argeuthiesen/claudinho/virtual/modelo/base.stl

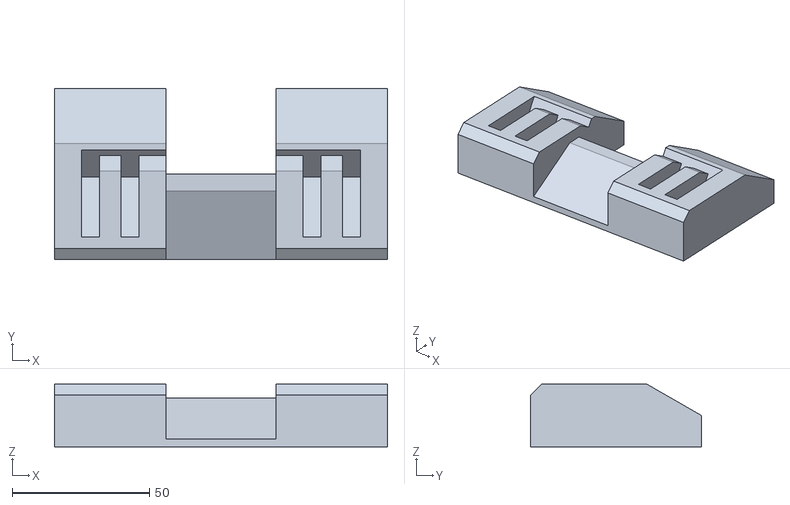
[picture p14: CAD file, 2026-10-12]
virtual/modelo/base.stl
121.5 x 62.4 x 23.0
