argeuthiesen/claudinho/docs/manual.md

# Claudinho manual

**English** · [Português](manual.pt-BR.md)

How to use Claudinho day to day, once it's built and set up. To build and
install it, see the [README](../README.md).

## What the face shows

Claudinho reacts on its own to what Claude Code is doing:

| Face | When it shows |
|---|---|
| Happy | a session started |
| Thinking | you sent a prompt |
| Excited | prompt with "thanks", "it works", "perfect", "awesome"... |
| Worried | prompt with "error", "bug", "doesn't work", "failed"... |
| Startled | prompt with a swear word |
| Working | Claude is about to use a tool (or one of the scenes below) |
| Suspicious | 5 tool calls in a row |
| Angry | a tool call failed |
| Excited | a `git commit` went through (it celebrates) |
| Happy | tests passed (`pytest`, `npm test`, `cargo test`, `go test`...) |
| Worried | tests failed |
| Waiting for you | Claude needs your permission or an answer |
| Dizzy | compacting the context |
| Done | Claude just finished responding |
| Tired | idle, with 5-hour usage above 75% |
| Sweating | idle, with usage above 90% |
| Sleeping | no open session, or 3 minutes without news from the computer |

Mood words are matched in English and Portuguese, and your prompt text never
leaves your computer: only the label ("happy", "worried", "startled") goes to
the board. The same goes for commits and tests: the command is checked on
your computer, and only the word ("commit", "tests passed", "tests failed")
goes to the board.

Along with the face, a short **caption** shows at the bottom for a few
seconds ("Thinking...", "Committed!", "I need you!") and then disappears,
leaving the face clean.

## Scenes while Claude works

While Claude uses tools, instead of the working face Claudinho plays a little
scene, with a mini Claudinho (arms, legs and all) in the corner:

| Claude is... | Scene |
|---|---|
| editing a file | a code editor: a terminal types `code` and a file name, then colored code is typed line by line and scrolls (a different file each time: Python, TypeScript, Go, SQL, C++) |
| running a command | a terminal typing commands, with output scrolling: git, tests that fail and then pass, builds, docker… in a different order each time |
| reading or searching the code | the Matrix rain |
| delegating to a subagent | an org chart: Claude on top, agents appearing below |
| asking another AI for a second opinion: OpenAI's [Codex plugin](https://github.com/openai/codex-plugin-cc) (GPT), `codex exec` or the Gemini CLI (`gemini -p`) | a chat: Claudinho and a little cloud with arms taking turns in speech bubbles full of zeros and ones |

It's all make-believe, stored on the board: the code and commands on screen are
fake. Only the category (editing, terminal, reading, agent, chat) leaves your
computer; file names and commands never do. Each scene stays at least 8
seconds, so the screen doesn't flicker; 12 seconds with no tool, it goes back
to the face (the chat waits for the next event, up to 5 minutes, since the
other AI often takes a while in a single command). Any other event (done, needs you, error) goes straight to the
face. Tap to see the usage card. To try one: `claudinho.sh cena codando`
(`terminal`, `lendo`, `agente`, `conversa`).

**The ticker.** Under the scene, a band in the face color shows what Claude is
doing in plain words: the short description Claude writes for each command
and agent (the one you see when approving it) or, without one, the task in
progress from its to-do list. It types itself out and, when it doesn't fit,
scrolls side to side. The command and file names still never leave your
computer. Off: `claudinho.sh letreiro desliga` (`liga` turns it back on). To
try it: `claudinho.sh cena terminal "Compiling the firmware"`. Claude tends to
write these descriptions in English; to get them in another language, ask for
it in your `CLAUDE.md`. On the single board the ticker uses DM Sans SemiBold;
on the Nextion version, the bold font the screen already has.

## Plan usage

- **Tap the screen** to see the usage card: 5-hour and 7-day windows, when
  each one resets, how many terminals are open and the board's IP, plus how
  full the current conversation's **context** is. On the single board they
  are **three rings** side by side (5 hours, 7 days, context) with the number
  in the middle; on the classic version, two bars plus **ctx** at the top.
  Colors: 5 h and 7 d turn yellow from 75% and red from 90%; context turns
  yellow from 70% and red from 85%, because Claude Code compacts the
  conversation a bit before it's full. After 15 seconds it goes back to the
  face (or tap outside the buttons).
- **The buttons at the bottom** (on the usage card and on the printer
  panel):
  - **Tokens** and **Printer** switch between the two screens;
    a thin gold frame marks the one you're on. Without a printer set up,
    only Tokens shows.
  - **Keep**: the screen stays on, updating live, and never goes
    back to the sleeping face. The button then reads **Sleep**:
    tap it and Claudinho goes back to sleep. Handy to take it to another
    room as a portable printer monitor. Printer alerts still show up, and
    after your tap it returns to the kept screen.
- **It also shows it on its own** for a few seconds when Claude finishes a
  response and usage grew noticeably, or when usage crosses 50%, 75% or 90%.
  Above 90% the number blinks red. Any new event goes straight back to the
  face.
- The numbers only show up after Claude's first response in a session.

## Web panel

`claudinho.sh web` (or ask Claude "open Claudinho's panel") opens, in your
browser, a page served by the board itself: the face it's showing, open
sessions, Wi-Fi signal, uptime, free memory, battery (single board), the
printer (if connected), plan usage and the last 20 events with the face each
one caused. It refreshes every 3 seconds.

Below, **Settings**: sound on/muted, volume, test a mood, face color (pick
it on the page and apply or save, or open the palette on the screen),
screen language, show usage or the printer panel now, open a game, run the
demo, restart and turn off. Updating the firmware, Wi-Fi and the printer
stay with `claudinho.sh` (they need the secret). The panel's address has a
read key that stays on your computer. Idea from
[bserking's fork](https://github.com/bserking/claudinho_GC9A01).

## Touch

| Touch | What it does |
|---|---|
| Short tap | on the face: opens the usage card; on the cards: the buttons (outside them, back to the face) |
| Long press (1.5 s) | toggles brightness between 100% and 15% |
| Tap when it asks to allow an update | authorizes the update |

When sleeping, it dims itself after 20 seconds.

## Changing the face color

Handy for matching the face to your case's filament color.

1. Ask Claude "change Claudinho's color" (or run `claudinho.sh cor`).
2. The screen shows **6 base colors**. Tap the one closest to your filament.
3. **12 shades of it** appear around the edges, with the tapped shade **shown
   large in the middle**. With the screen mounted in the case, the edge shades
   sit right against the printed frame, so you can compare each one directly
   with the filament, side by side. (Outside the case, hold a piece of
   filament next to the middle.)
4. Found it? **Tap the middle.** You get the face in that color with three
   buttons:
   - **Save**: keeps the color, even after a restart;
   - **Back**: back to the 12 shades;
   - **Cancel**: back to the previous color.

If nobody touches it for 1 minute, it cancels on its own. The eyes always
stay black. If you know the exact color: `claudinho.sh cor R G B salvar`.

## Tic-tac-toe

Just for fun: ask Claude "let's play tic-tac-toe" (or run `claudinho.sh
velha`). Your opponent is Claudinho itself, running on the board, spending no
tokens, and each game it's in a different mood: sometimes it plays perfectly,
sometimes it slips.

- You are **X**: tap a square. It answers right after with a **mini Clawd**.
- At the end it strikes the winning line and reacts: **sad** if you won,
  **excited** if it won, **suspicious** on a draw. Then a new game starts on
  its own, and who goes first alternates.
- To quit: **3 quick taps on the same square**, or 2 minutes without touching.
- If Claude Code needs you mid-game, a notice shows up in the corner.

## Genius (Simon)

Ask Claude "let's play Genius" (or run `claudinho.sh genius`). It also runs on
the board, spending no tokens.

- Claudinho lights up a sequence of colors on the 4 quadrants; you repeat it
  by tapping in the same order. The number in the middle is the round.
- Every time you get it right, the sequence gets one more color and speeds up
  a little.
- Miss one: it shows your score with a face that depends on how far you got,
  and a new game starts on its own.
- To quit: **3 quick taps on the same quadrant** (correct taps in the sequence
  don't count, so play without worry), or 2 minutes without touching.

## Bambu Lab printer (optional)

If you have a Bambu Lab 3D printer, Claudinho can watch it too. It connects
straight to the printer over your local network: no cloud, no server, no
tokens. **Tested on the P2S** (with AMS); other Bambu models with local access
(X1, P1, A1) should work but haven't been tested yet.

To turn it on, ask Claude "I have a Bambu printer" (or run `claudinho.sh bambu
PRINTER_IP`). You'll need the printer's IP and **access code** (printer
settings > Network). The access code is a secret like your Wi-Fi password: you
type it hidden, in your own terminal, and it's stored only on the board.

**The panel.** The printer model and its state (printing, paused...), the
AMS humidity and temperature (measured inside the AMS, where the spools are),
three columns (percent printed, time left, current layer), a progress bar in
the color of the filament being printed, nozzle, bed and chamber temperatures, and the
4 AMS colors with the current one framed. (The name you gave the printer in
the app lives only in Bambu's cloud, so the panel shows the model. The print
job name isn't shown either: over the local network the printer only sends
Bambu Studio's "project + plate" or the MakerWorld profile name, which don't
say what the part is.) While printing, it shows up on its own every 5 minutes
for 15 seconds. Open it anytime with the **Printer** button on the usage
card, and use **Keep** to keep it on screen.

**The alerts** show "3D PRINTER" and the model at the top, a
big title in the alert's color, the part name, the detail, and a little
Claudinho at the bottom: jumping for good news, waving its arms when something
needs you. The ones that only tell you how the print is going (started,
resumed, 5 minutes left, filament change) close by themselves after 20
seconds; the others stay on screen **until you tap** (the tap means "got it").
If several pile up, they show one after the other, and a newer alert from the
same print drops the ones it made old: "finished" replaces a "started" nobody
saw, and a pause that was resumed or ended goes away too. **When the printer
goes back to printing, Claudinho takes it that you already fixed the problem**:
the pause, the printer warnings and the end of the previous print leave the
queue without waiting for a tap.

| Alert | When |
|---|---|
| Started | a print started, with the estimated time |
| Paused | with the reason: out of filament, you paused, clogged nozzle, first layer error, front cover, temperature... |
| Resumed | back to printing after a pause |
| 5 min left | 5 minutes left |
| Filament changed | filament change, with the new color (one alert, kept up to date) |
| Finished! | with how long it took |
| Failed / Cancelled | failed (with the error code) or cancelled |
| HMS warnings | the printer's health warnings, in plain words (see below) |
| AMS is humid | AMS humidity reached 50% |

**HMS warnings, in plain words.** Bambu printers report problems as HMS codes
(like `0500-0200-0002-0005`). Claudinho carries Bambu's whole list (about 2,000
codes), rewritten as short phrases in your language: the title is the area (AMS,
nozzle / extruder, heated bed, network / internet...), the detail says what
happened, and the code stays small at the bottom, to look up in Bambu's wiki.
The color follows how serious it is: blue is informative, yellow needs
attention, red is serious.

**Tap or 20 seconds.** Informative warnings (no internet, clock sync, live
view, filter life...) **leave on their own after 20 seconds** and don't repeat
for 30 minutes: when the internet drops and comes back, it won't pop up every
time. A warning that shows up while the printer keeps printing also closes by
itself (it didn't stop anything), and one the printer clears from its list
leaves the queue too. Codes Bambu doesn't describe, at the "notice" level (no
effect on the print), only go to the log. Everything else waits for your tap,
or for the printer to start printing again.

During a game, the color palette or an update, the alerts wait until you're
back on the face. To see what they look like: `claudinho.sh alerta bom` (good
news), `ruim` (a pause), `filamento` or `hms`. To turn it off: `claudinho.sh bambu desligar` (erases the
code from the board).

## Sound and battery (single-board version only)

On the E32R28T with a small speaker, Claudinho **speaks a robot language** of
beeps and whistles, made up on the spot: no phrase is recorded, so no two are
alike, and the mood changes the intonation. It speaks when it wakes up, when
you open a Claude Code session (hello) and close the last one (goodbye), when
Claude needs you (a question), on an error (grumpy), when Claude finishes (a
quick "done!") and when it goes to sleep, and it calls out every 15 seconds
while the update screen waits for your tap. It stays quiet right after being
turned on.

- `claudinho.sh som desliga` / `som liga`: silence it or bring it back.
- `claudinho.sh som volume 150`: volume from 10 to 200% (above 100 it may
  distort a little).
- `claudinho.sh som feliz` (or `pergunta`, `sono`, `bravo`, `pronto`,
  `pensando`, `zonzo`...): hear a phrase in that mood.

**Battery:** the usage card shows a battery icon next to the clock, with a
**lightning bolt** inside while it charges. The charger's status pin doesn't
reach the ESP32, so the board figures it out from the voltage: plugging in
the 5 V makes it jump about 100 mV at once, and unplugging drops it the same
amount. The bolt shows up a few seconds after plugging in; if the board was
turned on already plugged in, it takes about 10 minutes (a slow rise). To put it
away for a few days, `claudinho.sh desligar` turns off the screen and puts the
board to deep sleep, using almost nothing; press **BOOT** (or RESET) to turn it
back on.

## Virtual Claudinho (no board)

No board yet? `claudinho.sh virtual` (or ask Claude "turn on the virtual
Claudinho") starts a small local server that takes the board's place and
opens Claudinho in a browser tab: the 3D case with the face running, or just
the screen ("Screen only" button), with the plan usage beside it. Drag to
turn it around, scroll to zoom. It reacts to the same events as the board,
spends no tokens and listens on `127.0.0.1` only.

- Click the screen (or the "Show usage" button) to see the three usage rings,
  like a tap on the board. It also opens on its own when usage crosses 50, 75
  or 90 %, and goes back to the face after 10 s.
- After restarting the computer, run it again.
- `claudinho.sh virtual parar` turns it off and points the plugin back to
  the board, if there was one.
- Not there yet: the Bambu Lab printer (panel and alerts) and the games.
  Only the board connects to a real printer for now; the online demo shows
  the printer screens with made-up data.
- Just want to look? The [online demo](https://argeuthiesen.github.io/claudinho/)
  runs on made-up events, nothing to install.

## Demo mode

Want to film Claudinho or show it to someone? Run `claudinho.sh demo` (or ask
Claude "run Claudinho's demo"). In about 2 minutes it goes through
everything on its own: sleeping and waking up, the faces, plan usage, the
work scenes, the printer panel and alerts, the color calibration, a game of
tic-tac-toe and one of Simon with "ghost" taps, and back to sleep.

It's all make-believe: your real numbers, the printer, the face color and
any pending alerts come back exactly as they were. During the demo, events
from the computer and the printer are ignored, so nothing interrupts it.
**Tap the screen to stop it** (or `claudinho.sh demo parar`). It uses the
screen language you picked. The printer part only shows if a printer is set
up.

## Updating

Ask Claude "update Claudinho". The screen will ask to allow the update: **tap
it within 1 minute** (or press the board's BOOT button). Without the tap,
nothing is sent. That keeps anyone from swapping the firmware over the network
without being in front of it.

The update takes about 40 seconds and it restarts on its own. If the network
drops halfway, it keeps the current version; just ask again.

## Asking Claude

No need to memorize commands. Inside Claude Code, just ask:

- "update Claudinho"
- "change Claudinho's color"
- "show the usage on Claudinho"
- "Claudinho stopped reacting" (the skill runs a diagnosis)
- "I changed my Wi-Fi, reconfigure Claudinho"
- "change Claudinho's language" (screen texts in English or Portuguese, and
  [your language, if you translate it](../idiomas/TRANSLATING.md))
- "I have a Bambu printer" / "show the printer panel"

The full command list is in the [README](../README.md#commands), and the most
common problems in [Troubleshooting](../README.md#troubleshooting).
