argeuthiesen/claudinho/docs/manual.pt-BR.md

# Manual do Claudinho

[English](manual.md) · **Português**

Como usar o Claudinho no dia a dia, depois de montado e configurado. Para
montar e instalar, veja o [README](../README.pt-BR.md).

## O que o rosto mostra

O Claudinho reage sozinho ao que o Claude Code está fazendo:

| Cara | Quando aparece |
|---|---|
| Feliz | abriu uma sessão |
| Pensando | você mandou um prompt |
| Empolgado | prompt com "obrigado", "valeu", "funcionou", "perfeito"... |
| Preocupado | prompt com "erro", "bug", "não funciona", "travou"... |
| Susto | prompt com palavrão |
| Trabalhando | o Claude vai usar uma ferramenta (ou uma das cenas abaixo) |
| Desconfiado | 5 ferramentas seguidas |
| Bravo | uma ferramenta falhou |
| Empolgado | um `git commit` deu certo (ele comemora) |
| Feliz | os testes passaram (`pytest`, `npm test`, `cargo test`, `go test`...) |
| Preocupado | os testes falharam |
| Esperando você | o Claude precisa da sua permissão ou de uma resposta |
| Zonzo | compactando o contexto |
| Terminou | o Claude acabou de responder |
| Cansado | parado, com o uso da janela de 5 horas acima de 75 % |
| Suando | parado, com o uso acima de 90 % |
| Dormindo | nenhuma sessão aberta, ou 3 minutos sem notícia do computador |

As palavras do humor são procuradas em português e em inglês, e o texto do
prompt nunca sai do seu computador: só a etiqueta ("feliz", "preocupado",
"susto") vai para a placa. O mesmo vale para commit e testes: o comando é
conferido no seu computador, e só a palavra ("commit", "testes passaram",
"testes falharam") vai para a placa.

Junto com a cara, aparece uma **legenda** curta embaixo por uns segundos
("Pensando...", "Commit feito!", "Preciso de você!"), que depois some e
deixa o rosto limpo.

## Cenas enquanto o Claude trabalha

Enquanto o Claude usa ferramentas, no lugar da cara de trabalhando o
Claudinho mostra uma cena, com um Claudinho pequeno (com bracinhos e
perninhas) no canto:

| O Claude está... | Cena |
|---|---|
| editando um arquivo | um editor de código: um terminal digita `code` e o nome de um arquivo, e o código colorido vai sendo digitado e rolando (cada vez um arquivo: Python, TypeScript, Go, SQL, C++) |
| rodando um comando | um terminal digitando comandos, com a saída rolando: git, testes que falham e depois passam, builds, docker… cada vez numa ordem |
| lendo ou procurando no código | a chuva do Matrix |
| delegando para um subagente | um organograma: o Claude em cima, os agentes surgindo embaixo |
| pedindo uma segunda opinião a outra IA: o [plugin do Codex](https://github.com/openai/codex-plugin-cc) da OpenAI (GPT), o `codex exec` ou o Gemini CLI (`gemini -p`) | uma conversa: o Claudinho e uma nuvenzinha de bracinhos se revezando em balões cheios de zeros e uns |

É tudo de mentira, guardado na placa: o código e os comandos da tela são
inventados. Do seu computador sai só a categoria (editando, terminal, lendo,
agente, conversa); nome de arquivo e comando nunca saem. Cada cena fica pelo menos 8
segundos, para a tela não piscar; 12 segundos sem ferramenta, volta ao rosto
(a conversa espera o próximo evento, até 5 minutos, porque a outra IA costuma
demorar num comando só).
Qualquer outro evento (terminou, precisa de você, erro) volta ao rosto na
hora. Tocar mostra o cartão de consumo. Para ver uma: `claudinho.sh cena
codando` (`terminal`, `lendo`, `agente`, `conversa`).

**O letreiro.** Embaixo da cena, uma faixa na cor do rosto mostra o que o
Claude está fazendo, em palavras: o resumo que o Claude escreve para cada
comando e agente (o que você vê ao aprovar) ou, sem ele, a tarefa em andamento
da lista dele. Ele se digita sozinho e, quando não cabe, rola de um lado para
o outro. O comando e os nomes de arquivo continuam sem sair do computador.
Desligar: `claudinho.sh letreiro desliga` (`liga` volta). Para ver:
`claudinho.sh cena terminal "Compilando o firmware"`. O Claude costuma
escrever esses resumos em inglês; para tê-los em português, peça isso no seu
`CLAUDE.md`. Na placa única o letreiro usa a DM Sans SemiBold; na versão com
Nextion, a negrito que a tela já tem.

## O consumo do plano

- **Tocando na tela** aparece o cartão de consumo: janelas de 5 horas e de 7
  dias, quando cada uma renova, quantos terminais estão abertos e o IP da
  placa, e quanto do **contexto** da conversa atual já foi usado. Na placa
  única são **três anéis** lado a lado (5 horas, 7 dias e contexto), com o
  número no meio; na versão clássica, duas barras e o **ctx** no alto. Cores:
  5 h e 7 d ficam amarelos a partir de 75 % e vermelhos a partir de 90 %; o
  contexto fica amarelo a partir de 70 % e vermelho a partir de 85 %, porque o
  Claude Code compacta a conversa um pouco antes de encher. Depois de 15
  segundos ele volta ao rosto (ou toque fora dos botões).
- **Os botões de baixo** (no cartão de consumo e no painel da impressora):
  - **Tokens** e **Impressora** alternam entre as duas telas; uma moldura
    dourada fina marca a atual. Sem impressora configurada, só aparece
    Tokens.
  - **Manter**: a tela fica ligada, atualizando ao vivo, e não volta mais
    para o rosto dormindo. O botão passa a dizer **Dormir**: tocando nele,
    o Claudinho volta a dormir. Bom para levar para outro cômodo como
    monitor portátil da impressora. Os alertas da impressora continuam
    aparecendo e, depois do seu toque, ele volta para a tela mantida.
- **Ele também mostra sozinho**, por alguns segundos, quando o Claude termina
  de responder e o uso subiu bastante, ou quando o uso passa de 50 %, 75 % ou
  90 %. Acima de 90 % o número pisca em vermelho. Qualquer evento novo volta
  ao rosto na hora.
- Os números só aparecem depois da primeira resposta do Claude numa sessão.

## Painel web

O `claudinho.sh web` (ou peça ao Claude "abre o painel do Claudinho") abre,
no navegador, uma página servida pela própria placa: a cara que está na
tela, as sessões abertas, o sinal do Wi-Fi, há quanto tempo está ligado, a
memória livre, a bateria (placa única), a impressora (se conectada), o
consumo do plano e os últimos 20 eventos, com a cara que cada um deu.
Atualiza a cada 3 segundos.

Embaixo, **Ajustes**: som ligado/mudo, volume, testar um humor, cor do rosto
(escolha na página e aplique ou salve, ou abra a paleta na tela), idioma da
tela, mostrar agora o consumo ou o painel da impressora, abrir um jogo,
rodar a demonstração, reiniciar e desligar. Atualizar o firmware, o Wi-Fi e
a impressora continuam no `claudinho.sh` (pedem o segredo). O endereço do
painel tem uma chave de leitura que fica só no seu computador. Ideia do
[fork do bserking](https://github.com/bserking/claudinho_GC9A01).

## Toques na tela

| Toque | O que faz |
|---|---|
| Toque curto | no rosto: abre o cartão de consumo; nos cartões: os botões (fora deles, volta ao rosto) |
| Toque longo (1,5 s) | alterna o brilho entre 100 % e 15 % |
| Toque quando pede "O PC quer me atualizar" | autoriza a atualização |

Dormindo, ele baixa o brilho sozinho depois de 20 segundos.

## Mudar a cor do rosto

Serve para combinar o rosto com a cor do filamento da caixa.

1. Peça ao Claude: "muda a cor do Claudinho" (ou rode `claudinho.sh cor`).
2. Na tela aparecem **6 cores base**. Toque na mais parecida com o filamento.
3. Aparecem **12 tons dela em volta da tela**, com o tom tocado **grande no
   centro**. Com a tela montada na caixa, os tons da borda ficam colados na
   moldura impressa: dá para comparar cada um direto com o filamento, lado a
   lado. (Fora da caixa, encoste um pedaço de filamento no centro.)
4. Achou? **Toque no centro.** Aparece o rosto nessa cor, com três botões:
   - **Gravar**: guarda a cor (continua depois de reiniciar);
   - **Voltar**: volta aos 12 tons;
   - **Cancelar**: volta à cor de antes.

Se ninguém tocar por 1 minuto, ele cancela sozinho. Os olhos ficam sempre
pretos. Quem souber a cor exata pode usar `claudinho.sh cor R G B salvar`.

## Jogo da velha

Um passatempo: peça ao Claude "vamos jogar velha" (ou rode `claudinho.sh
velha`). Quem joga contra você é o próprio Claudinho, rodando na placa, sem
gastar token, e cada partida ele está com um humor: às vezes joga perfeito, às
vezes vacila.

- Você é o **X**: toque no quadrado. Ele responde logo depois, com um **mini Clawd**.
- No fim, ele risca a linha vencedora e reage: **triste** se você ganhou,
  **empolgado** se ele ganhou, **desconfiado** no empate. Depois começa outra
  partida sozinho, e quem começa alterna.
- Para sair: **3 toques rápidos no mesmo quadrado**, ou 2 minutos sem tocar.
- Se o Claude Code precisar de você no meio do jogo, aparece um aviso no canto.

## Genius

Peça ao Claude "vamos jogar Genius" (ou rode `claudinho.sh genius`). Também
roda na placa, sem gastar token.

- O Claudinho acende uma sequência de cores nos 4 quadrantes; você repete
  tocando na mesma ordem. O número no meio é a rodada.
- A cada acerto a sequência ganha mais uma cor e acelera um pouco.
- Errou: ele mostra o seu placar ("Score") com uma cara que depende de quão
  longe você foi, e começa outro jogo sozinho.
- Para sair: **3 toques rápidos no mesmo quadrante** (os toques certos da
  sequência não contam, então dá para jogar sem medo), ou 2 minutos sem tocar.

## Impressora Bambu Lab (opcional)

Se você tem uma impressora 3D da Bambu Lab, o Claudinho acompanha ela também.
Ele conecta direto na impressora, pela rede de casa: sem nuvem, sem servidor,
sem gastar token. **Testado na P2S** (com AMS); outros modelos Bambu com
acesso local (X1, P1, A1) devem funcionar, mas ainda não foram testados.

Para ligar, peça ao Claude "tenho uma impressora Bambu" (ou rode
`claudinho.sh bambu IP_DA_IMPRESSORA`). Você vai precisar do IP e do **código
de acesso** da impressora (configurações > Rede). O código é um segredo, como
a senha do Wi-Fi: você digita escondido, no seu terminal, e ele fica gravado
só na placa.

**O painel.** O modelo da impressora e o estado (imprimindo, pausada...), a
umidade e a temperatura do AMS (medidas dentro dele, onde ficam os
carretéis), três colunas (quanto já imprimiu, tempo que falta, camada atual),
barra de progresso na cor do filamento que está imprimindo, temperatura do
bico, da mesa e da câmara, e as 4 cores do AMS com a atual em destaque. (O nome que você
deu à impressora no app fica só na nuvem da Bambu, por isso o painel mostra o
modelo. O nome da impressão também não aparece: pela rede local a impressora
só manda o "projeto + placa" do Bambu Studio ou o nome do perfil do
MakerWorld, que não dizem qual é a peça.) Imprimindo, ele aparece sozinho a
cada 5 minutos por 15 segundos. Abra quando quiser pelo botão **Impressora**
do cartão de consumo, e use **Manter** para deixar na tela.

**Os alertas** mostram "IMPRESSORA 3D" e o modelo no alto, um título grande na
cor do alerta, o nome da peça, o detalhe e um Claudinho pequeno embaixo:
pulando nas notícias boas, abanando os braços quando algo precisa de você.
Os que só contam como a impressão vai (começou, retomou, faltam 5 min, troca
de filamento) saem sozinhos em 20 segundos; os outros ficam na tela **até
você tocar** (o toque quer dizer "li"). Se juntarem vários, aparecem um depois
do outro, e um alerta mais novo da mesma impressão tira os que ficaram velhos:
o "terminou" substitui um "começou" que ninguém viu, e uma pausa que voltou
ou acabou também sai. **Quando a impressora volta a imprimir, o Claudinho
entende que você já resolveu o problema**: a pausa, os avisos da impressora e
o fim da impressão anterior saem da fila sem esperar o toque.

| Alerta | Quando |
|---|---|
| Começou | começou uma impressão, com o tempo previsto |
| Pausada | com o motivo: acabou o filamento, você pausou, bico entupido, erro na 1ª camada, tampa frontal, temperatura... |
| Retomou | voltou a imprimir depois da pausa |
| Faltam 5 min | faltam 5 minutos |
| Trocou o filamento | troca de filamento, com a cor nova (um alerta só, atualizado) |
| Terminou! | com quanto tempo levou |
| Falhou / Cancelada | falhou (com o código do erro) ou foi cancelada |
| Avisos HMS | os avisos de saúde da impressora, em palavras simples (veja abaixo) |
| AMS úmido | a umidade do AMS chegou a 50 % |

**Avisos HMS em português.** As impressoras Bambu avisam problemas com códigos
HMS (como `0500-0200-0002-0005`). O Claudinho leva a lista inteira da Bambu
(uns 2.000 códigos), reescrita em frases curtas: o título é a área (AMS,
bico / extrusora, mesa aquecida, rede / internet...), o detalhe diz o que
aconteceu, e o código fica pequeno embaixo, para procurar no wiki da Bambu. A
cor segue a gravidade: azul é informativo, amarelo pede atenção, vermelho é
grave.

**Toque ou 20 segundos.** Os avisos informativos (sem internet, acerto do
relógio, câmera ao vivo, vida do filtro...) **saem sozinhos em 20 segundos** e
não se repetem por 30 minutos: se a internet cair e voltar, não fica
pipocando. Um aviso que chega com a impressora imprimindo também sai sozinho
(ele não parou nada), e o que a impressora tira da lista dela sai da fila
também. Códigos que a Bambu não descreve, no nível de "aviso" (sem efeito na
impressão), vão só para o log. Todo o resto espera o seu toque, ou a
impressora voltar a imprimir.

Num jogo, na paleta de cores ou numa atualização, os alertas esperam você
voltar ao rosto. Para ver como ficam: `claudinho.sh alerta bom` (notícia
boa), `ruim` (uma pausa), `filamento` ou `hms`. Para desligar: `claudinho.sh bambu desligar` (apaga o código
da placa).

## Som e bateria (só na versão de placa única)

Na E32R28T com um alto-falante pequeno, o Claudinho **fala um idioma de
robô**, de bipes e assobios, inventado na hora: nenhuma fala é gravada, então
nenhuma sai igual, e o humor muda a entonação. Ele fala ao acordar, quando
você abre uma sessão do Claude Code (oi) e fecha a última (tchau), quando o
Claude precisa de você (uma pergunta), num erro (bravo), quando o Claude
termina (um "pronto!" rápido) e ao ir dormir, e chama a cada 15 segundos
enquanto a tela de atualização espera o seu toque. Logo depois de ligar ele
fica quieto.

- `claudinho.sh som desliga` / `som liga`: silencia ou volta a falar.
- `claudinho.sh som volume 150`: volume de 10 a 200 % (acima de 100 pode
  distorcer um pouco).
- `claudinho.sh som feliz` (ou `pergunta`, `sono`, `bravo`, `pronto`,
  `pensando`, `zonzo`...): ouve uma fala daquele humor.

**Bateria:** o cartão de consumo mostra um ícone de bateria ao lado do
relógio, com um **raio** dentro enquanto carrega. O pino de estado do
carregador não chega ao ESP32, então a placa deduz pela tensão: ao plugar os
5 V ela pula uns 100 mV de uma vez, e ao tirar cai o mesmo tanto. O raio
aparece uns segundos depois de plugar; se a placa foi ligada já na tomada,
leva uns 10 minutos (a subida é lenta). Para guardar por uns dias, o `claudinho.sh desligar` apaga a tela e
põe a placa em sono profundo, gastando quase nada; aperte **BOOT** (ou RESET)
para ligar de novo.

## Claudinho virtual (sem placa)

Ainda sem placa? O `claudinho.sh virtual` (ou peça ao Claude "liga o
Claudinho virtual") sobe um servidorzinho local que faz o papel da placa e
abre o Claudinho numa aba do navegador: a caixa em 3D com o rosto
funcionando, ou só a tela (botão "Ver só a tela"), com o consumo do plano ao
lado. Arraste para girar, use a rodinha para aproximar. Ele reage aos mesmos
eventos da placa, não gasta tokens e só escuta em `127.0.0.1`.

- Clique na tela (ou no botão "Ver consumo") para ver os três anéis de
  consumo, como um toque na placa. Ela também abre sozinha quando o consumo
  cruza 50, 75 ou 90 %, e volta para o rosto depois de 10 s.
- Depois de reiniciar o computador, rode de novo.
- `claudinho.sh virtual parar` desliga e aponta o plugin de volta para a
  placa, se havia uma.
- Ainda não tem: a impressora Bambu Lab (painel e alertas) e os jogos. Por
  enquanto só a placa conecta a uma impressora de verdade; a demonstração
  online mostra as telas da impressora com dados de mentira.
- Só quer olhar? A [demonstração online](https://argeuthiesen.github.io/claudinho/?lang=pt)
  roda com eventos de mentira, sem instalar nada.

## Modo demonstração

Quer filmar o Claudinho ou mostrar para alguém? Rode `claudinho.sh demo` (ou
peça ao Claude "roda a demo do Claudinho"). Em uns 2 minutos ele passa por
tudo sozinho: dorme e acorda, as caras, o consumo do plano, as cenas de
trabalho, o painel e os alertas da impressora, a calibragem de cor, uma
partida de jogo da velha e uma de Genius com toques "fantasma", e volta a
dormir.

É tudo de mentira: seus números de verdade, a impressora, a cor do rosto e os
alertas pendentes voltam exatamente como estavam. Durante a demo, os eventos
do computador e da impressora são ignorados, para nada interromper. **Toque
na tela para parar** (ou `claudinho.sh demo parar`). Ela usa o idioma da tela
que você escolheu. A parte da impressora só aparece se houver impressora
configurada.

## Atualizar

Peça ao Claude "atualiza o Claudinho". A tela vai mostrar "O PC quer me
atualizar": **toque nela em até 1 minuto** (ou aperte o botão BOOT da placa).
Sem o toque, nada é enviado. Isso impede que alguém troque o firmware pela
rede sem estar na frente dele.

A atualização leva uns 40 segundos e ele reinicia sozinho. Se a rede cair no
meio, ele continua na versão atual; é só pedir de novo.

## Pedir ao Claude

Não precisa decorar comando. Dentro do Claude Code, é só pedir:

- "atualiza o Claudinho"
- "muda a cor do Claudinho"
- "mostra o consumo no Claudinho"
- "o Claudinho parou de reagir" (a skill faz o diagnóstico)
- "troquei o Wi-Fi, reconfigura o Claudinho"
- "muda o idioma do Claudinho" (textos da tela em português ou inglês, e
  [no seu idioma, se você traduzir](../idiomas/TRANSLATING.pt-BR.md))
- "tenho uma impressora Bambu" / "mostra o painel da impressora"

A lista completa de comandos está no [README](../README.pt-BR.md#comandos), e
os problemas mais comuns, em [Problemas comuns](../README.pt-BR.md#problemas-comuns).
