argeuthiesen/claudinho/docs/img/e32r28t-montagem-frente.jpg

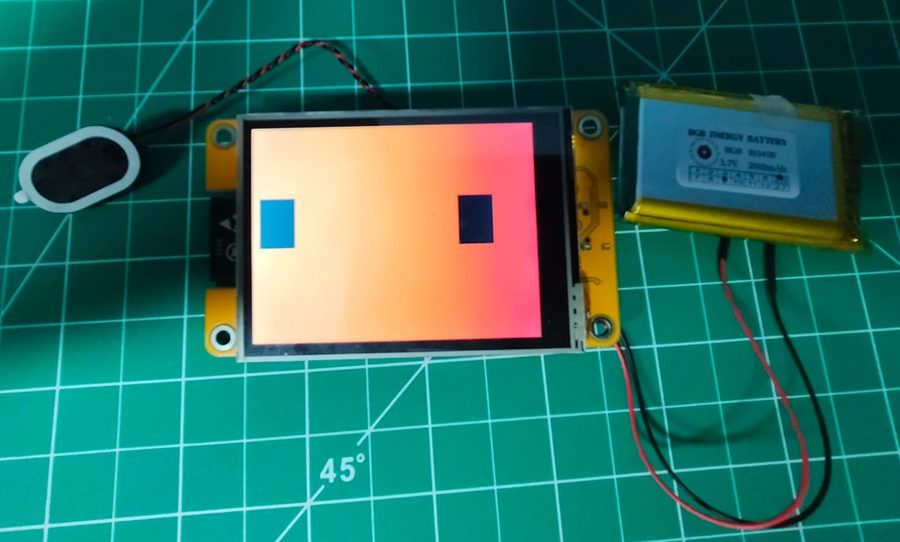
docs/img/e32r28t-montagem-frente.jpg
