argeuthiesen/claudinho/docs/img/e32r28t-montagem-verso.jpg

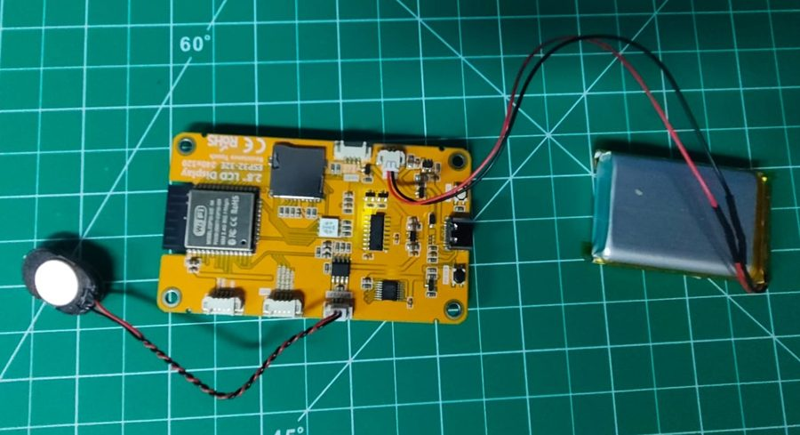
docs/img/e32r28t-montagem-verso.jpg
