argeuthiesen/claudinho/firmware/claudinho/claudinho.ino

/*
 * Claudinho — o mascote do Claude Code, vivo, na sua mesa.
 * ESP32-C3 Super Mini (ou ESP32-S3) + Nextion Discovery NX3224F024 (320x240).
 *
 * Tela 0 (padrao): os olhos do Clawd, pixelados, na tela inteira, reagindo ao
 *                  que o Claude Code esta fazendo (hooks) e ao uso do plano.
 * Tela 1 (toque):  janelas de 5 h e 7 dias, reset, terminais abertos e o IP.
 * Toque longo:     brilho 100 % / 15 %.
 *
 * Sem servidor e sem credencial da Anthropic: o PC (status line e hooks do
 * Claude Code) faz POST direto aqui, na rede local, com um segredo proprio.
 *
 * Configuracao (Wi-Fi e segredo) fica gravada na placa, nao no codigo. Na
 * primeira vez, pela serial USB (115200), linha a linha:
 *   INFO                      -> CLAUDINHO {"versao":..,"mac":..,"ip":..,...}
 *   SCAN                      -> REDE {"ssid":..,"rssi":..} ... SCAN FIM
 *   CFG {"ssid":..,"senha":..,"token":..}  -> CFG OK e reinicia
 * A skill do plugin faz isso sozinha.
 *
 * HTTP, tudo com "Authorization: Bearer <token>": POST /estado, /evento,
 * /cmd; GET /mini.json e /log; /ota (upload do .bin) e /tft?tam=N (upload da
 * tela) exigem ainda um toque na tela (ver manutencao). GET / so diz a versao.
 */

#include <WiFi.h>
#include <WiFiClientSecure.h>
#ifdef PLACA_E32R28T
#include "tela_e32.h"        // a E32R28T desenha direto (sem Nextion)
#include <LittleFS.h>         // sons enviados pela rede (claudinho.sh som envia)
#include "soc/rtc_io_reg.h"   // escrita direta no DAC do IO26 (rapida)
#endif
#include "textos.h"        // textos da tela por idioma (gerado de idiomas/*.txt)
#include "painel_web.h"    // a pagina do painel web (/painel)
#include "hms_codigos.h"   // codigos HMS da Bambu (gerado por firmware/hms/gerar.py)      // avisos HMS da Bambu em portugues (gerado por firmware/hms/gerar.py)
#include <esp_wifi.h>
#include <WebServer.h>
#include <Preferences.h>
#include <Update.h>
#include <ESPmDNS.h>
#include <ArduinoJson.h>
#include <time.h>
#include <sys/time.h>
#include <stdarg.h>
#include "config.h"

// ---------------------------------------------------------------- cores 565
#define RGB565(r, g, b) ((uint16_t)((((r) >> 3) << 11) | (((g) >> 2) << 5) | ((b) >> 3)))
static const uint16_t COR_FUNDO   = RGB565(0x36, 0x34, 0x35);
static const uint16_t COR_BLOCO   = RGB565(0x42, 0x40, 0x41);
static const uint16_t COR_OURO    = RGB565(0xd0, 0xad, 0x6c);
static const uint16_t COR_ALERTA  = RGB565(0xd9, 0xa2, 0x5a);
static const uint16_t COR_CRITICO = RGB565(0xc9, 0x6f, 0x6f);
static const uint16_t COR_OK      = RGB565(0x7b, 0xbf, 0x7b);
static const uint16_t COR_TEXTO   = RGB565(0xf2, 0xf3, 0xf4);
static const uint16_t COR_APAGADO = RGB565(0xa5, 0xa0, 0x9d);
static const uint16_t COR_TRILHO  = RGB565(0x55, 0x53, 0x54);
static const uint16_t COR_AZUL    = RGB565(0x4a, 0x8f, 0xd9);
// Rosto: o Clawd (mascote do Claude Code) — corpo laranja, dois retangulos
// pretos verticais como olhos, "> <" quando fecha. O fundo e a cor do corpo
// impresso, para o display parecer a propria logo viva.
static const uint16_t COR_ROSTO = RGB565(240, 105, 30);        // afinado ao vivo com o filamento laranja (2026-09-26)
static const uint16_t COR_OLHO  = RGB565(0x1e, 0x1c, 0x1c);   // preto
static const uint16_t COR_ZZZ   = RGB565(0x8a, 0x44, 0x10);   // marrom, discreto sobre o laranja
static const uint16_t COR_BRAVO = RGB565(0x8c, 0x0e, 0x0e);   // olhos vermelho-escuro
static const uint16_t COR_BRANCO = RGB565(0xff, 0xf4, 0xe6);

static const int FONTE_P = 0;   // 16 px
static const int FONTE_G = 1;   // 48 px
static const int FONTE_M = 2;   // 24 px negrito
static const int FONTE_32 = 3;  // 32 px
static const int LARG = 320;

// ---------------------------------------------------------------- estado
struct Dados {
  int  h5 = 0, d7 = 0, ctx = 0, n = 0;
  long h5r = 0, d7r = 0, at = 0;
  char mod[17] = "";
  bool ok = false;
};
Dados dados;

enum Servidor { SRV_INICIANDO, SRV_OK, SRV_SEM_WIFI, SRV_FALHA };
Servidor servidor = SRV_INICIANDO;

enum Cara { C_DORMINDO, C_NEUTRO, C_PENSANDO, C_TRABALHANDO, C_ESPERANDO, C_TERMINOU,
            C_FELIZ, C_EMPOLGADO, C_PREOCUPADO, C_SUSTO, C_ZONZO, C_CANSADO, C_SUANDO,
            C_BRAVO, C_TRISTE, C_DESCONFIADO };
// Um olho pixelado, em CELULAS (nao pixels). Definido antes de qualquer funcao:
// o Arduino gera protótipos no topo e precisa do tipo ja existente.
struct Olho {
  int w = 5, h = 11;        // tamanho em celulas (retangulo vertical, como o Clawd)
  int dx = 0, dy = 0;       // olhar (deslocamento em celulas)
  int palpebra = 0;         // linhas escondidas a partir de cima (cansado, piscar)
  int fundo = 0;            // linhas escondidas a partir de baixo
  bool domo = false;        // topo em arco (feliz)
  int diag = 0;             // 0 nada, +1 corta canto externo de cima (triste), -1 corta o interno
  int diagN = 0;            // quantas linhas o corte diagonal alcanca
  bool xis = false;         // olho em X (zonzo)
  int chev = 0;             // 0 quadrado, 1 = "<" piscadela (aponta para o outro olho), 2 = "^" feliz
};
struct Caixa { int x = 0, y = 0, w = 0, h = 0; };
struct Forma { int chev = -1, xis = 0, diag = 0, diagN = 0, domo = 0; uint16_t cor = 0;
  bool operator==(const Forma& f) const { return chev == f.chev && xis == f.xis && diag == f.diag && diagN == f.diagN && domo == f.domo && cor == f.cor; } };
enum BocaP { BP_NENHUMA, BP_SORRISO, BP_ABERTA, BP_O, BP_O_PEQ, BP_TRISTE, BP_BRAVA, BP_ONDA, BP_RETA };
struct Expr { Olho e, d; BocaP boca = BP_NENHUMA; uint16_t cor = 0; int bocaDy = 0; };
Cara caraNaTela = C_NEUTRO;
bool caraDesenhada = false;
struct { Cara cara = C_NEUTRO; unsigned long ate = 0; } evento;   // cara vinda de evento, com validade

int  pagina = 0;
bool demo = false;           // modo demonstracao (claudinho.sh demo): ignora eventos de verdade
bool forcaCena = false;      // evento de teste: troca a cena sem esperar o minimo
bool manter = false; int paginaManter = 1;   // botao Manter: tokens ou impressora ficam na tela (nao volta a dormir)
int  miniP = 4;              // tamanho do pixel do mini Clawd (4 nas cenas, 6 nos alertas)
unsigned long paginaDesde = 0;
unsigned long paginaDur = VOLTA_PAGINA_MS;    // quanto a tela de numeros fica antes de voltar ao rosto

// Atualizacao pela rede (firmware e tela) so com alguem na frente do
// Claudinho: o PC pede (/cmd {"manutencao":true}), a tela pede um toque (ou o
// botao BOOT) e so entao /ota e /tft aceitam arquivo, por MANUT_JANELA_MS.
// Quem so conhece o segredo, de longe, nao troca o firmware.
unsigned long manutPedidaEm = 0, manutAte = 0;

// Consumo automatico: a tela de numeros aparece sozinha em alguns momentos
// (boas-vindas, fim de resposta com uso subindo, limite cruzado). O pedido
// fica na fila e so e atendido com o Claudinho parado (sem cara de evento),
// para nunca esconder "esperando voce" nem atrapalhar o trabalho.
struct {
  bool pendente = false, soSeSubiu = false, intenso = false;
  unsigned long dur = 0;
  bool naTela = false, telaIntensa = false;   // o que esta sendo mostrado agora
} consumo;
int  mostrado5 = -1, mostrado7 = -1;          // uso na ultima exibicao
int  faixa5 = -1, faixa7 = -1;                // maior limite (0/50/75/90) ja avisado na janela
bool renovou5 = false, renovou7 = false;
unsigned long ultimoIntenso = 0;
static const unsigned long INTENSO_INTERVALO_MS = 5UL * 60 * 1000;
bool brilhoAlto = true;

HardwareSerial& nex = Serial1;

// Configuracao gravada na placa (NVS). Vazia de fabrica.
Preferences prefs;
String cfgSsid, cfgSenha, cfgToken;
String cfgLeitura;           // chave de leitura do painel web (so le; o segredo continua sendo o cfgToken)
// Abrir a porta serial reinicia a placa. Enquanto ela ainda tenta entrar no
// Wi-Fi, INFO nao e respondido (responderia "sem conexao" cedo demais); o
// proprio setup imprime o INFO quando termina.
bool conectandoWifi = false;

// ---------------------------------------------------------------- primitivas (protótipos p/ structs)
void preenche(int x, int y, int w, int h, uint16_t cor);
void escreve(int x, int y, int w, int h, int fonte, uint16_t cor, uint16_t fundo, int alin, const char* t);

struct Campo {
  int x, y, w, h, fonte, alin;
  uint16_t fundo;
  char ultimo[40] = "";
  uint16_t corUltima = 0;
  void mostra(const char* t, uint16_t cor) {
    if (strcmp(t, ultimo) == 0 && cor == corUltima) return;
    strlcpy(ultimo, t, sizeof ultimo);
    corUltima = cor;
    escreve(x, y, w, h, fonte, cor, fundo, alin, t);
  }
  void limpa() { ultimo[0] = 0; corUltima = 0; }
};

struct Barra {
  int x, y, w, h;
  int pctUltimo = -1;
  uint16_t corUltima = 0;
  void mostra(int pct, uint16_t cor) {
    if (pct == pctUltimo && cor == corUltima) return;
    pctUltimo = pct; corUltima = cor;
    preenche(x, y, w, h, COR_TRILHO);
    int usado = (long)w * constrain(pct, 0, 100) / 100;
    if (usado > 0) preenche(x, y, usado, h, cor);
  }
  void limpa() { pctUltimo = -1; }
};

// ---------------------------------------------------------------- layout
Campo cTitulo  = {12,  3, 100, 20, FONTE_P, 0, COR_FUNDO};
Campo cCtx     = {112, 3, 88, 20, FONTE_P, 0, COR_FUNDO};   // contexto da conversa; termina antes do icone da bateria (E32R28T)
Campo cRelogio = {240, 3,  68, 20, FONTE_P, 2, COR_FUNDO};
Campo cRodape  = {0, 168, LARG, 17, FONTE_P, 1, COR_FUNDO};

// Tela 0: grade de celulas de 8 px (40 x 30 celulas). Centros dos olhos.
static const int CEL = 8;
static const int OLHO_ESQ_X = 6, OLHO_DIR_X = 34, OLHO_Y = 11;    // em celulas: bem afastados, como no mascote; boca em y 21..24

// Tela 1: blocos completos
struct BlocoJanela {
  int y;
  Campo rotulo, pct, reseta, resta;
  Barra barra;
  BlocoJanela(int y0) : y(y0),
    rotulo {12,  y0 + 2,  220, 18, FONTE_P, 0, COR_BLOCO},   // as caixas nao se sobrepoem: o fundo do numero
    pct    {12,  y0 + 24, 112, 36, FONTE_32, 0, COR_BLOCO},  // apagava a parte de baixo do rotulo
    reseta {132, y0 + 22, 176, 18, FONTE_P, 0, COR_BLOCO},
    resta  {132, y0 + 42, 176, 18, FONTE_P, 0, COR_BLOCO},
    barra  {12,  y0 + 64, 296, 6} {}
  void limpa() { rotulo.limpa(); pct.limpa(); reseta.limpa(); resta.limpa(); barra.limpa(); }
};
BlocoJanela b5h(22), b7d(96);
#ifdef PLACA_E32R28T
// Tela 1 na E32R28T: tres aneis (ver anelJanela)
struct Anel {
  int cx;
  int pct = -2; uint16_t cor = 0; char txt[8] = "", l2[24] = "";
  Campo num, rotulo, linha2;
  Anel(int x) : cx(x),
    num    {x - 30, 62, 60, 26, FONTE_M, 1, COR_FUNDO},    // cabe dentro do furo do anel (raio 34)
    rotulo {x - 52, 124, 104, 18, FONTE_P, 1, COR_FUNDO},
    linha2 {x - 52, 143, 104, 18, FONTE_P, 1, COR_FUNDO} {}
  void esquece() { pct = -2; cor = 0; txt[0] = l2[0] = 0; num.limpa(); rotulo.limpa(); linha2.limpa(); }
};
static const int ANEL_Y = 75, ANEL_R1 = 44, ANEL_R0 = 34;
Anel aneis[3] = {Anel(56), Anel(160), Anel(264)};
#endif

// ---------------------------------------------------------------- nextion
// O Nextion tem buffer de 1 KB e desenha mais devagar do que 115200 baud
// entrega. Sem folga entre comandos, uma troca de cara (30-40 fills) estoura o
// buffer e ele descarta pedacos: sobra lixo na tela. Cada comando espera o
// anterior render; "cls" (tela inteira) ganha folga maior.
void nexCmd(const char* cmd) {
#ifdef PLACA_E32R28T
  e32Cmd(cmd); return;                 // E32R28T: desenha direto, sem serial
#endif
  nex.print(cmd);
  nex.write(0xFF); nex.write(0xFF); nex.write(0xFF);
  nex.flush();
  delay(strncmp(cmd, "cls", 3) == 0 ? 40 : 5);
}
void nexCmdf(const char* fmt, ...) {
  char buf[220];
  va_list ap; va_start(ap, fmt);
  vsnprintf(buf, sizeof buf, fmt, ap);
  va_end(ap);
  nexCmd(buf);
}
#define DEBUG_FILLS 0     // registra cada fill no serial (para simular a tela no PC)
void preenche(int x, int y, int w, int h, uint16_t cor) {
#if DEBUG_FILLS
  Serial.printf("F %d %d %d %d %u\n", x, y, w, h, cor);
#endif
  nexCmdf("fill %d,%d,%d,%d,%u", x, y, w, h, cor);
}
// Limpa a tela com fill (o "cls" se perdeu em campo e deixou lixo); duas
// vezes, porque perder este e o unico erro que fica visivel ate a proxima troca.
void limpaTela(uint16_t cor) { preenche(0, 0, 320, 240, cor); delay(30); preenche(0, 0, 320, 240, cor); delay(30); }
void escreve(int x, int y, int w, int h, int fonte, uint16_t cor, uint16_t fundo, int alin, const char* t) {
  nexCmdf("xstr %d,%d,%d,%d,%d,%u,%u,%d,1,1,\"%s\"", x, y, w, h, fonte, cor, fundo, alin, t);
}
void circulo(int x, int y, int r, uint16_t cor) { nexCmdf("cirs %d,%d,%d,%u", x, y, r, cor); }
// linha grossa (2 px): o Nextion so desenha 1 px
void linha(int x1, int y1, int x2, int y2, uint16_t cor) {
  nexCmdf("line %d,%d,%d,%d,%u", x1, y1, x2, y2, cor);
  nexCmdf("line %d,%d,%d,%d,%u", x1, y1 + 1, x2, y2 + 1, cor);
}

// Log: vai para a serial e para um buffer circular lido em GET /log, para
// dar para diagnosticar sem cabo.
static char logBuf[3072]; static size_t logPos = 0; static bool logCheio = false;
void registra(const char* fmt, ...) {
  char buf[200]; va_list ap; va_start(ap, fmt); vsnprintf(buf, sizeof buf, fmt, ap); va_end(ap);
  Serial.println(buf);
  char linha[220]; int n = snprintf(linha, sizeof linha, "%lu %s\n", millis() / 1000, buf);
  for (int k = 0; k < n; k++) { logBuf[logPos++] = linha[k]; if (logPos >= sizeof logBuf) { logPos = 0; logCheio = true; } }
}

// ---------------------------------------------------------------- tempo
void horaStr(time_t t, char* out, size_t n) {
  struct tm tm; localtime_r(&t, &tm);
  snprintf(out, n, "%02d:%02d", tm.tm_hour, tm.tm_min);
}
void diaHoraStr(time_t t, char* out, size_t n) {
  struct tm tm, hoje; time_t agora = time(nullptr);
  localtime_r(&t, &tm); localtime_r(&agora, &hoje);
  if (tm.tm_yday == hoje.tm_yday && tm.tm_year == hoje.tm_year)
    snprintf(out, n, tx(T_TEMPO_HOJE), tm.tm_hour, tm.tm_min);
  else
    snprintf(out, n, tx(T_TEMPO_DIA), tx((Txt)(T_DIA_0 + tm.tm_wday)), tm.tm_hour, tm.tm_min);
}
void restanteStr(long ate, char* out, size_t n) {
  long s = ate - (long)time(nullptr); if (s < 0) s = 0;
  long d = s / 86400, h = (s % 86400) / 3600, m = (s % 3600) / 60;
  if (d > 0)      snprintf(out, n, tx(T_TEMPO_EM_D), d, h);
  else if (h > 0) snprintf(out, n, tx(T_TEMPO_EM_H), h, m);
  else            snprintf(out, n, tx(T_TEMPO_EM_MIN), m);
}
bool relogioValido() { return time(nullptr) > 1600000000L; }
void ajustaRelogio(long agora) {
  if (agora > 1600000000L) { struct timeval tv = { (time_t)agora, 0 }; settimeofday(&tv, nullptr); }
}
uint16_t corPct(int pct) { return pct >= 90 ? COR_CRITICO : pct >= 75 ? COR_ALERTA : COR_OURO; }
bool congelado() { return dados.ok && dados.at > 0 && relogioValido() && (long)time(nullptr) - dados.at > CONGELADO_APOS_S; }

// ---------------------------------------------------------------- rosto
// Cada olho e desenhado linha a linha (uma celula de altura), com um "fill"
// por linha. Antes de desenhar, apaga so a caixa que ocupou no quadro anterior.
// Alem dos olhos: boca (so nas emocoes fortes) e "extras" (pontinhos, !, ?,
// gota, lagrima, zzz), cada um com a sua caixa.
void celula(int cx, int cy, int w, int h, uint16_t cor) { preenche(cx * CEL, cy * CEL, w * CEL, h * CEL, cor); }

Caixa ultimaEsq, ultimaDir, ultimaExtra, ultimaBoca;
// O que esta na tela agora (o simulador de PC compara com um desenho limpo).
Expr exprNaTela; Cara extrasCaraNaTela = C_NEUTRO; int extrasFaseNaTela = 0;
uint16_t corRostoAtual = COR_ROSTO;          // escolhida na paleta (claudinho.sh cor) ou por /cmd {"cor":[r,g,b]}; gravada na placa
uint16_t corRosto() { return corRostoAtual; }
void apaga(Caixa& c) { if (c.w) { celula(c.x, c.y, c.w, c.h, corRosto()); c = {}; } }

void recorte(const Olho& o, int r, int& corteExt, int& corteInt) {
  corteExt = corteInt = 0;
  int deBaixo = o.h - 1 - r, arred = 0;
  if (o.w >= 10)     { if (r == 0 || deBaixo == 0) arred = 2; else if (r == 1 || deBaixo == 1) arred = 1; }
  else if (o.w >= 7) { if (r == 0 || deBaixo == 0) arred = 1; }
  corteExt = corteInt = arred;                       // menor que 7: retangulo crisp, como o Clawd
  if (o.domo) { int meio = o.h / 2; if (r < meio) { int c = meio - r; corteExt = max(corteExt, c); corteInt = max(corteInt, c); } }
  if (o.diag != 0 && r < o.diagN) { int c = o.diagN - r; if (o.diag > 0) corteExt = max(corteExt, c); else corteInt = max(corteInt, c); }
}

Forma formaEsq, formaDir;

// Apaga o que sobrou da caixa antiga fora da caixa nova (ate 4 tiras). Como a
// parte comum foi redesenhada por cima na mesma cor, nao ha piscada.
void apagaSobra(const Caixa& velha, const Caixa& nova) {
  if (!velha.w) return;
  int vx2 = velha.x + velha.w, vy2 = velha.y + velha.h, nx2 = nova.x + nova.w, ny2 = nova.y + nova.h;
  bool cruza = velha.x < nx2 && nova.x < vx2 && velha.y < ny2 && nova.y < vy2;
  if (!cruza) { celula(velha.x, velha.y, velha.w, velha.h, corRosto()); return; }
  if (nova.y > velha.y) celula(velha.x, velha.y, velha.w, nova.y - velha.y, corRosto());           // tira de cima
  if (ny2 < vy2)        celula(velha.x, ny2, velha.w, vy2 - ny2, corRosto());                       // tira de baixo
  int ya = max(velha.y, nova.y), yb = min(vy2, ny2);
  if (nova.x > velha.x) celula(velha.x, ya, nova.x - velha.x, yb - ya, corRosto());                 // tira da esquerda
  if (nx2 < vx2)        celula(nx2, ya, vx2 - nx2, yb - ya, corRosto());                            // tira da direita
}

void desenhaOlho(const Olho& o, int centroX, bool ladoEsquerdo, uint16_t cor, Caixa& ultima, Forma& ultimaForma) {
  int x0 = centroX + o.dx - o.w / 2, y0 = OLHO_Y + o.dy - o.h / 2;
  Forma f; f.chev = o.chev; f.xis = o.xis; f.diag = o.diag; f.diagN = o.diagN; f.domo = o.domo; f.cor = cor;
  bool retangulo = (o.chev == 0 && !o.xis && o.diag == 0 && !o.domo && o.w < 7);
  // Forma igual e retangulo: desenha por cima e apaga so a sobra (sem piscar).
  // Forma diferente ou desenho esparso (chevron, X, cortes): apaga antes.
  bool suave = retangulo && (f == ultimaForma) && ultima.w;
  if (!suave) apaga(ultima);

  Caixa nova;
  if (o.chev == 1) {
    // "<" no olho direito (ponta para a esquerda), ">" no esquerdo. A caixa
    // precisa cobrir TODAS as colunas do traco (meio + espessura), nao so o.w:
    // foi daqui que sobravam pixels perdidos entre uma cara e outra.
    int n = o.h | 1, meio = n / 2, oy = y0 + (o.h - n) / 2, esp = o.w >= 5 ? 2 : 1;
    int larg = meio + esp;
    int xIni = ladoEsquerdo ? (x0 + o.w - larg) : x0;
    for (int r = 0; r < n; r++) {
      int passo = abs(r - meio);
      int cx = ladoEsquerdo ? (x0 + o.w - esp - passo) : (x0 + passo);
      celula(cx, oy + r, esp, 1, cor);
    }
    nova = {xIni, oy, larg, n};
  } else if (o.chev == 2) {
    int n = o.w | 1, meio = n / 2, ox = x0 + (o.w - n) / 2;
    for (int c = 0; c < n; c++) celula(ox + c, y0 + 1 + abs(c - meio), 1, 2, cor);
    nova = {ox, y0 + 1, n, meio + 2};
  } else if (o.xis) {
    int n = min(o.w, o.h) - 1, ox = x0 + (o.w - n) / 2, oy = y0 + (o.h - n) / 2;
    if (o.fundo == 99) { celula(ox + n / 2, oy, 1, n, cor); celula(ox, oy + n / 2, n, 1, cor); }
    else for (int k = 0; k < n; k++) { celula(ox + k, oy + k, 1, 1, cor); celula(ox + n - 1 - k, oy + k, 1, 1, cor); }
    nova = {ox, oy, n, n};
  } else if (retangulo) {
    int alt = o.h - o.palpebra - o.fundo;
    if (alt > 0) celula(x0, y0 + o.palpebra, o.w, alt, cor);
    nova = {x0, y0 + o.palpebra, o.w, max(alt, 0)};
  } else {
    for (int r = 0; r < o.h; r++) {
      if (r < o.palpebra || r >= o.h - o.fundo) continue;
      int ce, ci; recorte(o, r, ce, ci);
      int esq = ladoEsquerdo ? ce : ci, dir = ladoEsquerdo ? ci : ce, larg = o.w - esq - dir;
      if (larg > 0) celula(x0 + esq, y0 + r, larg, 1, cor);
    }
    nova = {x0, y0 + o.palpebra, o.w, o.h - o.palpebra - o.fundo};
  }
  if (suave) apagaSobra(ultima, nova);
  ultima = nova; ultimaForma = f;
}

// ---- boca: so nas emocoes fortes; no neutro o Clawd fica sem boca
BocaP bocaNaTela = BP_NENHUMA;
void desenhaBoca(BocaP b, int dy = 0) {
  (void)dy;
  if (b == bocaNaTela && (b == BP_NENHUMA || ultimaBoca.w)) return;
  apaga(ultimaBoca); bocaNaTela = b;
  if (b == BP_NENHUMA) return;
  int y = 21; ultimaBoca = {14, y - 1, 13, 6};
  uint16_t c = COR_OLHO;
  switch (b) {
    case BP_SORRISO: celula(15, y, 1, 1, c); celula(25, y, 1, 1, c); celula(16, y + 1, 1, 1, c); celula(24, y + 1, 1, 1, c); celula(17, y + 2, 7, 1, c); break;
    case BP_ABERTA:  celula(15, y, 11, 1, c); celula(16, y + 1, 9, 2, c); celula(17, y + 3, 7, 1, c); break;
    case BP_O:       celula(18, y, 5, 4, c); celula(19, y + 1, 3, 2, corRosto()); break;
    case BP_O_PEQ:   celula(19, y + 1, 3, 2, c); break;
    case BP_TRISTE:  celula(17, y, 7, 1, c); celula(16, y + 1, 1, 1, c); celula(24, y + 1, 1, 1, c); celula(15, y + 2, 1, 1, c); celula(25, y + 2, 1, 1, c); break;
    case BP_BRAVA:   celula(23, y, 3, 1, c); celula(19, y + 1, 4, 1, c); celula(15, y + 2, 4, 1, c); break;
    case BP_ONDA:    celula(15, y, 2, 1, c); celula(19, y, 2, 1, c); celula(23, y, 2, 1, c); celula(17, y + 1, 2, 1, c); celula(21, y + 1, 2, 1, c); celula(25, y + 1, 1, 1, c); break;
    case BP_RETA:    celula(16, y + 1, 9, 1, c); break;
    default: break;
  }
}

// ---- extras (uma caixa so, apagada e redesenhada a cada quadro animado)
// Z em pixels, desenho 5x5 com unidade de u px (u = 4, 6, 8: pequeno, medio, grande)
void zetaPx(int x, int y, int u, uint16_t cor) {
  preenche(x, y, 5 * u, u, cor);
  for (int k = 0; k < 3; k++) preenche(x + (3 - k) * u, y + (k + 1) * u, u, u, cor);
  preenche(x, y + 4 * u, 5 * u, u, cor);
}
void glifoInterrogacao(int x, int y, uint16_t c) {
  celula(x + 1, y, 3, 1, c); celula(x, y + 1, 1, 1, c); celula(x + 4, y + 1, 1, 2, c);
  celula(x + 3, y + 3, 1, 1, c); celula(x + 2, y + 4, 1, 1, c); celula(x + 2, y + 6, 1, 1, c);
}
void glifoExclamacao(int x, int y, uint16_t c) { celula(x, y, 2, 5, c); celula(x, y + 6, 2, 1, c); }

static Cara extrasCUlt = C_NEUTRO; static int extrasChaveUlt = -1;
void esqueceExtras() { extrasCUlt = C_NEUTRO; extrasChaveUlt = -1; }
void extras(Cara c, int fase) {
  extrasCaraNaTela = c; extrasFaseNaTela = fase;
  Cara& cUlt = extrasCUlt; int& chaveUlt = extrasChaveUlt;
  int chave;                                            // o que de fato muda com a fase, por cara
  switch (c) {
    case C_DORMINDO:  chave = (fase / 4) % 4; break;
    case C_PENSANDO:  chave = (fase / 2) % 4; break;
    case C_ESPERANDO: chave = (fase / 2) % 2; break;
    case C_SUANDO:    chave = fase % 6; break;
    case C_TRISTE:    chave = fase % 8; break;
    default:          chave = 0;
  }
  if (c == cUlt && chave == chaveUlt && (ultimaExtra.w || c == C_NEUTRO)) return;
  cUlt = c; chaveUlt = chave;
  apaga(ultimaExtra);
  // Tudo no espaco ENTRE os olhos (x 13..27), que fica livre.
  switch (c) {
    case C_DORMINDO: {                                // zzz subindo entre os olhos
      int n = (fase / 4) % 4;
      ultimaExtra = {14, 0, 13, 13};
      if (n >= 1) zetaPx(112, 76, 4, COR_ZZZ);      // pequeno, perto dos olhos
      if (n >= 2) zetaPx(140, 40, 6, COR_ZZZ);      // medio
      if (n >= 3) zetaPx(176,  0, 8, COR_ZZZ);      // grande, la em cima
    } break;
    case C_PENSANDO: {                                // pontinhos, como balao de pensamento
      int n = (fase / 2) % 4;
      ultimaExtra = {16, 3, 9, 2};
      for (int k = 0; k < n; k++) celula(17 + k * 3, 4, 1, 1, COR_OLHO);
    } break;
    case C_ESPERANDO:                                 // "?" piscando
      ultimaExtra = {17, 1, 6, 8};
      if ((fase / 2) % 2 == 0) glifoInterrogacao(18, 2, COR_OLHO);
      break;
    case C_SUSTO:                                     // "!" grande
      ultimaExtra = {19, 1, 3, 8};
      glifoExclamacao(19, 1, COR_OLHO);
      break;
    case C_SUANDO: {                                  // gota escorrendo, do lado de fora do olho direito
      int q = fase % 6;
      ultimaExtra = {37, 2, 3, 13};
      celula(38, 2 + q, 1, 2, COR_AZUL); celula(37, 4 + q, 3, 2, COR_AZUL); celula(38, 6 + q, 1, 1, COR_AZUL);
    } break;
    case C_TRISTE: {                                  // lagrima caindo do olho esquerdo
      int q = fase % 8;
      ultimaExtra = {5, 18, 2, 12};
      celula(5, 18 + q, 2, 2, COR_AZUL); celula(5, 20 + q, 1, 1, COR_AZUL);
    } break;
    default: break;
  }
}

// A expressao de cada cara: olhos, boca e cor. fase avanca a cada 250 ms.

void expressao(Cara c, int fase, Expr& x) {
  x = Expr(); x.cor = COR_OLHO;
  Olho& e = x.e; Olho& d = x.d;
  int quica = ((fase / 2) & 1) ? -1 : 0;              // pulinho alternado a cada 500 ms
  switch (c) {
    case C_NEUTRO: break;                                                        // dois retangulos (o Clawd)
    case C_DORMINDO:    e.palpebra = d.palpebra = 10; e.dy = d.dy = 2; break;    // so um traco embaixo + zzz
    case C_PENSANDO:    e.dx = d.dx = 2; e.dy = d.dy = -2; d.palpebra = 4; e.palpebra = 1; break;
    case C_TRABALHANDO: { int dx = (fase & 1) ? 3 : -3; e.dx = d.dx = dx;
                          e.h = d.h = 7; e.dy = d.dy = 2; } break;               // estreitos, varrendo largo
    case C_ESPERANDO:   e.w = d.w = 6; e.h = d.h = 14; x.boca = BP_O_PEQ; break;
    case C_SUSTO:       e.w = d.w = 8; e.h = d.h = 16; e.dy = d.dy = (fase < 2) ? -2 : 0;
                        x.boca = BP_O; break;                                    // pula e fica enorme
    case C_TERMINOU:    d.chev = 1; d.h = 11; break;                              // piscadela "<"
    case C_FELIZ:       e.chev = d.chev = 2; e.w = d.w = 7; e.dy = d.dy = quica;
                        x.boca = BP_SORRISO; break;                              // "^ ^" quicando, sorriso
    case C_EMPOLGADO:   e.chev = d.chev = 1; e.h = d.h = 13; e.dy = d.dy = quica;
                        x.boca = BP_ABERTA; break;                               // "> <" quicando, boca aberta
    case C_BRAVO:       e.diag = d.diag = -1; e.diagN = d.diagN = 5; e.dx = 1; d.dx = -1;
                        { int tr = (fase < 6) ? ((fase & 1) ? 1 : -1) : 0; e.dx += tr; d.dx += tr; }
                        x.cor = COR_BRAVO; x.boca = BP_BRAVA; break;             // vermelho, franzido, tremendo
    case C_PREOCUPADO:  e.diag = d.diag = 1; e.diagN = d.diagN = 5; e.dy = d.dy = 2;
                        x.boca = BP_TRISTE; break;
    case C_TRISTE:      e.h = d.h = 7; e.dy = d.dy = 4; e.dx = -1; d.dx = 1; x.boca = BP_TRISTE; break;
    case C_DESCONFIADO: d.palpebra = 5; e.w = 6; e.h = 12; e.dx = d.dx = -2; x.boca = BP_RETA; break;
    case C_ZONZO:       e.xis = d.xis = true; e.w = d.w = 7; e.h = d.h = 7;
                        e.fundo = d.fundo = (fase & 1) ? 99 : 0; x.boca = BP_ONDA; break;   // X / + girando
    case C_CANSADO:     e.palpebra = d.palpebra = 5; e.dy = d.dy = 1; break;
    case C_SUANDO:      e.palpebra = d.palpebra = 5; e.diag = d.diag = 1; e.diagN = d.diagN = 2; e.dy = d.dy = 1;
                        x.boca = BP_ONDA; break;
  }
}

void desenhaExpr(const Expr& x) {
  exprNaTela = x;
  desenhaOlho(x.e, OLHO_ESQ_X, true,  x.cor, ultimaEsq, formaEsq);
  desenhaOlho(x.d, OLHO_DIR_X, false, x.cor, ultimaDir, formaDir);
  desenhaBoca(x.boca);
}

bool caraAnimada(Cara c) {
  return c == C_TRABALHANDO || c == C_DORMINDO || c == C_PENSANDO || c == C_ESPERANDO || c == C_SUSTO ||
         c == C_FELIZ || c == C_EMPOLGADO || c == C_BRAVO || c == C_ZONZO || c == C_SUANDO || c == C_TRISTE;
}
bool caraPisca(Cara c) { return c == C_NEUTRO || c == C_CANSADO || c == C_ESPERANDO || c == C_PREOCUPADO || c == C_DESCONFIADO || c == C_PENSANDO; }

Cara caraBase() {
  if (!dados.ok || congelado() || dados.n == 0) return C_DORMINDO;   // n == 0: todas as sessoes fechadas
  if (dados.h5 >= 90) return C_SUANDO;
  if (dados.h5 >= 75) return C_CANSADO;
  return C_NEUTRO;
}
Cara caraDesejada() {
  if (evento.ate && (long)(millis() - evento.ate) < 0) return evento.cara;
  if (evento.ate && (evento.cara == C_DESCONFIADO || evento.cara == C_BRAVO)) {
    evento.cara = C_TRABALHANDO; evento.ate = millis() + 120000;
    return C_TRABALHANDO;
  }
  return caraBase();
}
void poeCara(Cara c, unsigned long dur) { evento.cara = c; evento.ate = millis() + dur; caraDesenhada = false; }

// Legenda: uma frase curta embaixo do rosto dizendo o que aconteceu. Aparece
// junto com a cara do evento e some sozinha depois de uns segundos.
int legenda = -1;                         // T_LEGENDA_... (-1: nenhuma)
unsigned long legendaAte = 0;
bool legendaNaTela = false;               // desenhada (ou ainda por apagar)
void poeLegenda(int t, unsigned long dur = 5000) { legenda = t; legendaAte = millis() + dur; legendaNaTela = false; }
void cuidaLegenda() {                     // so na tela 0, depois do rosto
  if (legenda >= 0 && (long)(millis() - legendaAte) >= 0) legenda = -1;
  if (legenda >= 0 && !legendaNaTela) { escreve(0, 202, 320, 30, FONTE_M, COR_OLHO, corRosto(), 1, tx((Txt)legenda)); legendaNaTela = true; }
  else if (legenda < 0 && legendaNaTela) { preenche(0, 202, 320, 30, corRosto()); legendaNaTela = false; }
}
// Comemoracao (commit, testes): a ferramenta seguinte nao tira a cara antes da hora.
unsigned long celebraAte = 0;
bool celebrando() { return celebraAte && (long)(millis() - celebraAte) < 0; }

void trataEvento(const char* tipo, const char* humor) {
  static int ferramentasSeguidas = 0;
  if (strcmp(tipo, "ferramenta") != 0 && strcmp(tipo, "erro") != 0) ferramentasSeguidas = 0;
  if (consumo.naTela && pagina != 0 && !manter) mudaPagina(0);    // qualquer evento volta ao rosto na hora (mantida: fica)
  if (pagina == 9 && !manter && !strcmp(tipo, "atencao")) mudaPagina(0);
  if (pagina == 10 && strcmp(tipo, "ferramenta")) mudaPagina(0);   // qualquer outro evento: sai da cena e mostra a cara   // o Claude precisa de voce: vale mais que o painel
  if (pagina == 6 && !strcmp(tipo, "atencao")) avisoVelha();   // no jogo: so avisa no canto
  if (strcmp(tipo, "ferramenta") && strcmp(tipo, "parou")) celebraAte = 0;   // outro evento: a comemoracao acaba
  if      (!strcmp(tipo, "inicio"))     { poeCara(C_FELIZ, 5000); poeLegenda(T_LEGENDA_OI); pedeConsumo(20000, false, false); }
  else if (!strcmp(tipo, "prompt")) {
    if      (!strcmp(humor, "feliz"))      { poeCara(C_EMPOLGADO, 5000); poeLegenda(T_LEGENDA_EMPOLGADO); }
    else if (!strcmp(humor, "preocupado")) { poeCara(C_PREOCUPADO, 6000); poeLegenda(T_LEGENDA_PREOCUPADO); }
    else if (!strcmp(humor, "susto"))      { poeCara(C_SUSTO, 5000); poeLegenda(T_LEGENDA_SUSTO); }
    else                                   { poeCara(C_PENSANDO, 120000); poeLegenda(T_LEGENDA_PENSANDO); }
  }
  else if (!strcmp(tipo, "ferramenta")) {
    ++ferramentasSeguidas;
    if (celebrando()) {}                                                    // deixa a festa terminar
    else if (cenaPorFerramenta(forcaCena)) {}                               // editor, terminal, Matrix ou organograma
    else if (ferramentasSeguidas == 5) { poeCara(C_DESCONFIADO, 4000); poeLegenda(T_LEGENDA_DESCONFIADO, 4000); }
    else if (caraDesejada() != C_DESCONFIADO) {
      if (caraDesejada() != C_TRABALHANDO) poeLegenda(T_LEGENDA_TRABALHANDO);
      poeCara(C_TRABALHANDO, 120000);
    }
  }
  else if (!strcmp(tipo, "erro"))       { poeCara(C_BRAVO, 3500); poeLegenda(T_LEGENDA_ERRO, 3500); }
  else if (!strcmp(tipo, "parou"))      { if (!celebrando()) { poeCara(C_TERMINOU, 5000); poeLegenda(T_LEGENDA_PRONTO); } pedeConsumo(15000, true, false); }
  else if (!strcmp(tipo, "atencao"))    { poeCara(C_ESPERANDO, 120000); poeLegenda(T_LEGENDA_ATENCAO, 8000); }
  else if (!strcmp(tipo, "compact"))    { poeCara(C_ZONZO, 5000); poeLegenda(T_LEGENDA_COMPACT); }
  // commit e testes: o hook ve o comando no PC e manda so a palavra
  else if (!strcmp(tipo, "commit"))       { poeCara(C_EMPOLGADO, 5000); poeLegenda(T_LEGENDA_COMMIT); celebraAte = millis() + 5000; }
  else if (!strcmp(tipo, "teste_ok"))     { poeCara(C_FELIZ, 4000); poeLegenda(T_LEGENDA_TESTE_OK, 4000); celebraAte = millis() + 4000; }
  else if (!strcmp(tipo, "teste_falhou")) { poeCara(C_PREOCUPADO, 5000); poeLegenda(T_LEGENDA_TESTE_FALHOU); }
  else if (!strcmp(tipo, "dormir"))     poeCara(C_DORMINDO, 20000);    // so para teste (claudinho.sh cara dormir)
  else if (!strcmp(tipo, "fim"))        { evento.ate = 0; caraDesenhada = false; }   // quem decide e o contador de sessoes (estado)
}

// Chamado a cada volta do loop na tela 0: troca de cara, animacao, piscada e
// os "olhares" do neutro (de vez em quando olha pro lado, para parecer vivo).
void cuidaRosto() {
  static unsigned long ultimaFase = 0, proximaPiscada = 0, piscadaEm = 0, proximoOlhar = 0, olharAte = 0;
  static int fase = 0, quadroPiscada = -1, olharDx = 0;
  Cara c = caraDesejada();
  unsigned long agora = millis();
  Expr x;

  if (!caraDesenhada || c != caraNaTela) {
    if (caraDesenhada) somDaCara(caraNaTela, c);
    caraNaTela = c; caraDesenhada = true; fase = 0;
    Serial.printf("CARA %d\n", (int)c);
    expressao(c, fase, x); desenhaExpr(x); extras(c, fase);
    proximaPiscada = agora + 2500 + random(3000); quadroPiscada = -1;
    proximoOlhar = agora + 4000 + random(5000); olharAte = 0;
    return;
  }
  if (agora - ultimaFase >= 250) {
    ultimaFase = agora; fase++;
    if (caraAnimada(c)) {
      expressao(c, fase, x);
      if (c == C_DORMINDO || c == C_PENSANDO || c == C_ESPERANDO || c == C_SUANDO || c == C_TRISTE) extras(c, fase);
      else { desenhaExpr(x); if (c == C_SUSTO) extras(c, fase); }
    }
  }
  // neutro: olhadinha pro lado a cada poucos segundos
  if (c == C_NEUTRO && quadroPiscada < 0) {
    if (!olharAte && agora >= proximoOlhar) { olharAte = agora + 700; olharDx = random(2) ? 2 : -2;
      expressao(c, fase, x); x.e.dx = x.d.dx = olharDx; desenhaExpr(x); }
    else if (olharAte && agora >= olharAte) { olharAte = 0; proximoOlhar = agora + 4000 + random(6000);
      expressao(c, fase, x); desenhaExpr(x); }
  }
  if (!caraPisca(c)) return;
  unsigned long dur = (c == C_CANSADO) ? 220 : 45;
  if (quadroPiscada < 0 && agora >= proximaPiscada) { quadroPiscada = 0; piscadaEm = 0; }
  if (quadroPiscada >= 0 && agora - piscadaEm >= dur) {
    piscadaEm = agora;
    expressao(c, fase, x);
    if (olharAte) { x.e.dx = x.d.dx = olharDx; }
    const int PALP[] = {x.e.h * 4 / 10, x.e.h - 1, x.e.h * 4 / 10, 0}; int pp = PALP[quadroPiscada];
    x.e.palpebra = max(x.e.palpebra, pp); x.d.palpebra = max(x.d.palpebra, pp);
    desenhaExpr(x);
    if (++quadroPiscada > 3) { quadroPiscada = -1; proximaPiscada = agora + (c == C_CANSADO ? 1500 : 2500) + random(4000); }
  }
}

// ---------------------------------------------------------------- telas
void desenhaMoldura() {
  cTitulo.limpa(); cCtx.limpa(); cRelogio.limpa(); cRodape.limpa();
  if (pagina == 0) {
    limpaTela(corRosto());
    caraDesenhada = false; ultimaEsq = {}; ultimaDir = {}; ultimaExtra = {}; ultimaBoca = {};
    formaEsq = Forma(); formaDir = Forma(); bocaNaTela = BP_NENHUMA; esqueceExtras();
    legendaNaTela = false;
  } else if (pagina == 9) {
    painel(true);
  } else if (pagina == 8) {
    desenhaAlerta();
  } else if (pagina == 10) {
    cenaInicio();
  } else if (pagina >= 6) {
    // os jogos desenham a propria tela
  } else if (pagina >= 3) {
    desenhaPaleta();
  } else if (pagina == 2) {
    limpaTela(COR_FUNDO);
    escreve(0,  40, 320, 30, FONTE_M,  COR_OURO,    COR_FUNDO, 1, tx(T_MANUT_PC_QUER));
    escreve(0,  90, 320, 38, FONTE_32, COR_TEXTO,   COR_FUNDO, 1, tx(T_MANUT_TOQUE));
    escreve(0, 130, 320, 38, FONTE_32, COR_TEXTO,   COR_FUNDO, 1, tx(T_MANUT_PERMITIR));
    escreve(0, 196, 320, 20, FONTE_P,  COR_APAGADO, COR_FUNDO, 1, tx(T_MANUT_OU_BOOT));
  } else {
    limpaTela(COR_FUNDO);
#ifdef PLACA_E32R28T
    for (Anel& a : aneis) a.esquece();
#else
    preenche(6, b5h.y, 308, 72, COR_BLOCO);
    preenche(6, b7d.y, 308, 72, COR_BLOCO);
    b5h.limpa(); b7d.limpa();
#endif
    desenhaBotoes();
  }
}

// ---- bateria (so a E32R28T: divisor de 100k + 100k no IO34, le metade da tensao)
int batNaTela = -2;                       // nivel desenhado no cabecalho (-2: redesenhar)
#ifdef PLACA_E32R28T
int bateriaMv() {
  uint32_t soma = 0; for (int i = 0; i < 16; i++) soma += analogReadMilliVolts(34);
  return soma / 16 * 2;
}
// Curva tipica de uma LiPo (4,2 V cheia, 3,3 V vazia). -1: sem bateria.
int bateriaPct(int mv) {
  if (mv < 2500) return -1;
  static const int MV[] = {3300, 3500, 3600, 3700, 3800, 3900, 4000, 4100, 4200}, PCT[] = {0, 10, 20, 35, 50, 65, 80, 90, 100};
  if (mv <= MV[0]) return 0;
  for (int i = 1; i < 9; i++) if (mv <= MV[i]) return PCT[i - 1] + (PCT[i] - PCT[i - 1]) * (mv - MV[i - 1]) / (MV[i] - MV[i - 1]);
  return 100;
}
// Carregando? O pino de estado do carregador (TP4054) nao chega ao ESP32, entao
// a placa deduz pela tensao: ao plugar os 5 V, a leitura pula uns 100 mV na
// hora (a corrente de carga passa pela resistencia interna da bateria); ao
// tirar, cai o mesmo tanto. Medido na placa: 4134 -> 4030 -> 4126 mV. Depois
// de ligar, ou sem pulo para ver, vale a tendencia de 10 min: subindo = carregando.
// Carregando, a leitura fica inflada pelo pulo: o percentual desconta ele.
bool batCarregando = false;
int batPulo = 100;                        // mV que a leitura sobe com o carregador (o ultimo pulo medido)
int batMvAgora = 0;                       // ultima leitura (media de 3 amostras)
void cuidaBateria() {
  static unsigned long ult = 0, tendDesde = 0; static int am[6], n = 0, tendMv = 0; static float media = 0; static bool viuPulo = false;
  if (millis() - ult < 2000) return;
  ult = millis();
  int mv = bateriaMv();
  if (mv < 2500) { batCarregando = false; batMvAgora = mv; n = 0; return; }   // sem bateria
  if (n == 6) { memmove(am, am + 1, 5 * sizeof(int)); n = 5; }
  am[n++] = mv;
  media = media ? media + (mv - media) * 0.05f : mv;   // media lenta, para a tendencia
  int ini = n >= 3 ? (am[0] + am[1] + am[2]) / 3 : mv, fim = n >= 3 ? (am[n - 3] + am[n - 2] + am[n - 1]) / 3 : mv;
  batMvAgora = fim;
  if (n == 6) {
    int d = fim - ini;
    if (d >= 60 && !batCarregando)  { batCarregando = true;  batPulo = constrain(d, 60, 200); viuPulo = true; n = 0; tendDesde = 0; registra("bateria: carregador ligado (+%d mV)", d); }
    else if (d <= -60 && batCarregando) { batCarregando = false; batPulo = constrain(-d, 60, 200); viuPulo = true; n = 0; tendDesde = 0; registra("bateria: carregador desligado (%d mV)", d); }
  }
  // Tendencia de 10 min: na tomada a tensao nunca cai, na bateria nunca sobe.
  // E devagar (medido: +8 mV em 6 min carregando a 85 %), por isso a janela longa.
  // Pega o que o pulo nao mostra (ligou ja na tomada; tirou com a bateria cheia).
  {
    if (!tendDesde) { tendDesde = millis(); tendMv = (int)media; }
    else if (millis() - tendDesde > 600000) {
      int d = (int)media - tendMv;
      bool antes = batCarregando;
      if (d >= 6) batCarregando = true; else if (d <= -6) batCarregando = false;
      if (!viuPulo && fim >= 4190) batCarregando = true;   // logo depois de ligar: acima disso, so na tomada
      if (batCarregando != antes) registra("bateria: %s (tendencia %+d mV)", batCarregando ? "carregando" : "na bateria", d);
      tendDesde = millis(); tendMv = (int)media;
    }
  }
}
int bateriaMvReal() { int mv = batMvAgora ? batMvAgora : bateriaMv(); return batCarregando && mv < 4190 ? mv - batPulo : mv; }
void desenhaBateria() {
  int pct = bateriaPct(bateriaMvReal());
  int nivel = pct < 0 ? -1 : (pct + 5) / 10 + (batCarregando ? 100 : 0);   // redesenha ao mudar de faixa de 10 % ou ao plugar/tirar
  if (nivel == batNaTela) return;
  batNaTela = nivel;
  const int x = 206, y = 7, w = 24, h = 12;
  preenche(x - 2, y - 1, w + 6, h + 2, COR_FUNDO);
  if (pct < 0) return;
  uint16_t c = pct > 50 ? COR_OK : pct > 20 ? COR_OURO : COR_CRITICO;
  preenche(x, y, w, h, COR_TEXTO); preenche(x + 1, y + 1, w - 2, h - 2, COR_FUNDO);   // contorno
  preenche(x + w, y + 3, 2, h - 6, COR_TEXTO);                                         // polo
  preenche(x + 2, y + 2, max(1, (w - 4) * pct / 100), h - 4, c);
  if (batCarregando) {                    // raio no meio, com borda escura para aparecer sobre qualquer cor
    const int X[] = {x + 14, x + 9, x + 15, x + 10}, Y[] = {y + 1, y + 6, y + 6, y + 11};
    for (int i = 0; i < 3; i++) {
      for (int o = -1; o <= 1; o += 2) linha(X[i] + o, Y[i], X[i + 1] + o, Y[i + 1], COR_FUNDO);
      linha(X[i], Y[i], X[i + 1], Y[i + 1], COR_OURO);
    }
  }
}
#else
int bateriaMv() { return 0; }
int bateriaPct(int) { return -1; }
bool batCarregando = false;
int bateriaMvReal() { return 0; }
void cuidaBateria() {}
void desenhaBateria() {}
#endif

// ---- som (so a E32R28T: amplificador FM8002E ligado pelo IO4 em nivel baixo,
// som pelo IO26). O Claudiao "fala" num idioma de robo gerado na hora: cada
// fala e montada por sorteio (voz, ritmo, silabas, notas), entao nunca se
// repete e nada e gravado. O humor muda a gramatica da fala. Um som enviado
// pela rede (claudinho.sh som envia acordar|dormir arq.wav) tem preferencia.
// Logo depois de ligar fica quieto. claudinho.sh som liga|desliga|volume N.
#ifdef PLACA_E32R28T
#define TEM_SOM true
#else
#define TEM_SOM false
#endif
bool somLigado = true;
int somVolume = 100;                   // % (10 a 200; acima de 100 pode distorcer nos picos)
inline int somAmostra(int x) { return constrain(128 + (x - 128) * somVolume / 100, 0, 255); }
enum Humor { H_FELIZ, H_PERGUNTA, H_SONO, H_BRAVO, H_PRONTO, H_PENSANDO, H_EMPOLGADO, H_PREOCUPADO, H_SUSTO,
             H_TRABALHANDO, H_DESCONFIADO, H_ZONZO, H_CANSADO, H_NERVOSO };
#ifdef PLACA_E32R28T
static const int SOM_PINO = 26, SOM_LIGA = 4;
void somAmp(bool liga) { pinMode(SOM_LIGA, OUTPUT); digitalWrite(SOM_LIGA, liga ? LOW : HIGH); }

// Saida de som: o DAC do IO26, amostra por amostra, no ritmo de micros().
// A escrita vai direto no registrador (dacWrite, a funcao do core, e lenta
// demais para 22050 amostras/s: o som saia devagar e grave). No fim, o log
// diz quanto tempo levou contra o esperado.
static const uint32_t SOM_TAXA = 22050;
uint32_t somT = 0, somInicio = 0, somAmostras = 0;
bool somAbre() {
  dacWrite(SOM_PINO, 128);                           // liga o DAC e o pino (uma vez, pela funcao do core)
  somAmp(true); somT = somInicio = micros(); somAmostras = 0;
  return true;
}
inline void somPoe(int v) {
  SET_PERI_REG_BITS(RTC_IO_PAD_DAC2_REG, RTC_IO_PDAC2_DAC, somAmostra(v), RTC_IO_PDAC2_DAC_S);   // DAC2 = IO26
  somAmostras++;
  somT += 1000000UL / SOM_TAXA; while ((int32_t)(micros() - somT) < 0) {}
}
void somFecha() {
  uint32_t real = micros() - somInicio, esperado = (uint64_t)somAmostras * 1000000ULL / SOM_TAXA;
  dacDisable(SOM_PINO); somAmp(false);
  registra("som: %u amostras em %u ms (esperado %u ms)", (unsigned)somAmostras, (unsigned)(real / 1000), (unsigned)(esperado / 1000));
}

// ---- o idioma do Claudiao: assobio quase puro (seno + um pouco do 2o harmonico)
float vozFase = 0, vozTom = 1, vozRitmo = 1;
inline float rnd(float a, float b) { return a + (b - a) * (esp_random() / 4294967295.0f); }
inline int vozMs(float ms) { return (int)(ms * vozRitmo * SOM_TAXA / 1000); }
// Toca n amostras com a frequencia dada por f(i) e um envelope curto (sem estalo).
template <typename F> void vozSoa(int n, F freq) {
  int a = SOM_TAXA / 250;                                      // 4 ms
  for (int i = 0; i < n; i++) {
    float f = freq(i) * vozTom;
    vozFase += 6.2831853f * f / SOM_TAXA; if (vozFase > 6.2831853f) vozFase -= 6.2831853f;
    float env = min(1.0f, min((float)i / a, (float)(n - i) / a));
    somPoe(128 + (int)(105 * env * (sinf(vozFase) + 0.12f * sinf(2 * vozFase)) / 1.12f));
  }
}
void vozPausa(float ms) { int n = vozMs(ms); for (int i = 0; i < n; i++) somPoe(128); }
void vozDesliza(float f0, float f1, float ms, float curva) { int n = max(1, vozMs(ms)); float r = f1 / f0;
  vozSoa(n, [&](int i) { return f0 * powf(r, powf((float)i / n, curva)); }); }
void vozBip(float f, float ms) { vozSoa(vozMs(ms), [&](int) { return f; }); }
void vozTrinado(float f1, float f2, float ms, float hz) { int meio = (int)(SOM_TAXA / (hz * 2));
  vozSoa(vozMs(ms), [&](int i) { return (i / meio) % 2 ? f2 : f1; }); }
void vozBorbulho(float ms, float lo, float hi, float hz) {
  int passo = (int)(SOM_TAXA / hz); float alvo = rnd(lo, hi), f = alvo;
  vozSoa(vozMs(ms), [&](int i) { if (i % passo == 0) alvo = rnd(lo, hi); f += (alvo - f) * 0.008f; return f; });
}
// Uma silaba sorteada, puxada para a faixa [lo, hi] da fala.
void vozSilaba(float lo, float hi, int pesoDesliza, int pesoBip, int pesoTrinado, int pesoBorbulho) {
  int t = random(pesoDesliza + pesoBip + pesoTrinado + pesoBorbulho);
  if (t < pesoDesliza) { float a = rnd(lo, hi), b = rnd(lo, hi); vozDesliza(a, b, rnd(60, 160), rnd(0.6f, 1.6f)); }
  else if ((t -= pesoDesliza) < pesoBip) { int k = random(1, 4); for (int q = 0; q < k; q++) { vozBip(rnd(lo, hi), rnd(30, 65)); if (q < k - 1) vozPausa(rnd(12, 28)); } }
  else if ((t -= pesoBip) < pesoTrinado) { float f = rnd(lo, hi * 0.85f); vozTrinado(f, f * rnd(1.15f, 1.35f), rnd(120, 240), rnd(14, 22)); }
  else vozBorbulho(rnd(150, 320), lo, hi, rnd(18, 30));
}

void fala(int h) {   // h: um Humor (int porque o Arduino declara as funcoes antes do enum)
  if (!somLigado || !somAbre()) return;
  vozTom = rnd(0.82f, 1.2f); vozRitmo = rnd(0.8f, 1.25f); vozFase = 0;
  switch (h) {
    case H_FELIZ: {                                            // sobe, animado, termina la em cima
      vozDesliza(rnd(850, 1100), rnd(1900, 2500), rnd(60, 90), 0.7f); vozPausa(rnd(15, 35));
      int n = random(4, 8);
      for (int k = 0; k < n; k++) { vozSilaba(1200, 3100, 3, 4, 2, 2); vozPausa(rnd(15, 45)); }
      float f = rnd(1100, 1500); vozDesliza(f * 2.2f, f, rnd(110, 160), 0.8f); vozDesliza(f, rnd(3000, 3500), rnd(100, 150), 1.6f);
      if (random(2)) { vozPausa(15); vozBip(rnd(2600, 3300), rnd(30, 50)); }
    } break;
    case H_PERGUNTA: {                                         // conversa e termina subindo ("hein?")
      int n = random(2, 5);
      for (int k = 0; k < n; k++) { vozSilaba(1100, 2600, 2, 4, 1, 2); vozPausa(rnd(25, 55)); }
      float f = rnd(1100, 1500); vozDesliza(f, f * rnd(2.2f, 2.8f), rnd(240, 340), rnd(2.0f, 2.8f));
    } break;
    case H_SONO: {                                             // mais lento e grave, sempre descendo
      vozRitmo *= 1.35f;
      int n = random(2, 4);
      for (int k = 0; k < n; k++) { float a = rnd(1500, 2200); vozDesliza(a, a * rnd(0.5f, 0.7f), rnd(140, 220), 0.7f); vozPausa(rnd(50, 90)); }
      float f = rnd(1300, 1700); vozTrinado(f, f * 0.85f, rnd(160, 240), 9); vozPausa(40);
      vozDesliza(f * 0.9f, f * 0.4f, rnd(380, 480), 1.5f);
    } break;
    case H_BRAVO: {                                            // trinados rapidos e deslizes para baixo
      vozTom *= 0.75f;
      int n = random(3, 6);
      for (int k = 0; k < n; k++) {
        if (random(2)) { float f = rnd(900, 1500); vozTrinado(f, f * 1.2f, rnd(90, 160), rnd(24, 32)); }
        else { float a = rnd(1600, 2200); vozDesliza(a, a * 0.45f, rnd(90, 140), 0.6f); }
        vozPausa(rnd(20, 40));
      }
    } break;
    case H_PENSANDO: {                                         // murmurio baixinho, borbulho lento
      vozTom *= 0.85f; vozBorbulho(rnd(420, 620), 900, 1700, rnd(9, 13)); vozPausa(40); vozBip(rnd(1100, 1400), 50);
    } break;
    case H_EMPOLGADO: {                                        // feliz, mais rapido e agudo
      vozTom *= 1.15f; vozRitmo *= 0.75f;
      int n = random(5, 9);
      for (int k = 0; k < n; k++) { vozSilaba(1500, 3400, 3, 3, 2, 2); vozPausa(rnd(10, 25)); }
      vozDesliza(rnd(1600, 2000), rnd(3400, 3800), rnd(80, 120), 1.4f);
    } break;
    case H_PREOCUPADO: {                                       // pergunta que cai no fim: "hmm..."
      vozSilaba(1100, 2200, 2, 3, 1, 1); vozPausa(rnd(30, 50));
      float f = rnd(1600, 2000); vozDesliza(f, f * 1.4f, rnd(120, 160), 1.2f); vozDesliza(f * 1.4f, f * 0.6f, rnd(260, 340), 0.7f);
    } break;
    case H_SUSTO: {                                            // guincho curto e agudo, de repente
      vozRitmo = 1; float f = rnd(900, 1200); vozDesliza(f, rnd(3600, 4200), rnd(70, 100), 0.4f); vozPausa(30);
      vozTrinado(rnd(3000, 3400), rnd(3600, 3900), rnd(90, 130), 28);
    } break;
    case H_TRABALHANDO: {                                      // tagarelando apressado
      vozRitmo *= 0.8f; vozBorbulho(rnd(300, 450), 1300, 2900, rnd(28, 36)); vozPausa(25); vozBip(rnd(1800, 2400), 40);
      vozPausa(20); vozBorbulho(rnd(200, 300), 1300, 2900, rnd(28, 36));
    } break;
    case H_DESCONFIADO: {                                      // "hmmm" grave e lento
      vozTom *= 0.7f; vozRitmo *= 1.3f; float f = rnd(1100, 1300);
      vozTrinado(f, f * 1.06f, rnd(260, 340), 6); vozPausa(50); vozDesliza(f * 1.05f, f * 0.8f, rnd(220, 280), 1.0f);
    } break;
    case H_ZONZO: {                                            // sobe e desce, cambaleando
      vozRitmo *= 1.1f; float f = rnd(1300, 1600);
      for (int k = 0; k < 3; k++) { vozDesliza(f, f * 1.6f, rnd(110, 150), 1.0f); vozDesliza(f * 1.6f, f * 0.8f, rnd(110, 150), 1.0f); f *= rnd(0.85f, 1.05f); }
    } break;
    case H_CANSADO: {                                          // suspiro descendo
      vozRitmo *= 1.4f; float f = rnd(1600, 1900); vozDesliza(f, f * 0.55f, rnd(420, 520), 0.8f); vozPausa(60); vozBip(f * 0.5f, 90);
    } break;
    case H_NERVOSO: {                                          // trinados nervosos
      vozRitmo *= 0.85f; int n = random(3, 5);
      for (int k = 0; k < n; k++) { float f = rnd(1800, 2600); vozTrinado(f, f * 1.12f, rnd(80, 130), rnd(26, 34)); vozPausa(rnd(20, 40)); }
    } break;
    case H_PRONTO: {                                           // curtinho: bips e um trinado subindo
      int n = random(2, 4);
      for (int k = 0; k < n; k++) { vozBip(rnd(1500, 2600), rnd(35, 55)); vozPausa(rnd(15, 30)); }
      float f = rnd(2000, 2600); vozTrinado(f, f * 1.25f, rnd(110, 160), 20);
    } break;
  }
  somFecha();
}

// Som enviado pela rede (LittleFS, particao "spiffs" de 128 KB): WAV 8 bits mono 22050 Hz.
bool somFs = false;
bool tocaArquivo(const char* nome) {
  if (!somLigado) return false;
  if (!somFs) { registra("som: %s: memoria de sons nao montada", nome); return false; }
  if (!LittleFS.exists(nome)) return false;
  File f = LittleFS.open(nome, "r"); uint8_t h[44];
  if (!f) { registra("som: %s: nao abriu", nome); return false; }
  if (f.read(h, 44) != 44) { registra("som: %s: cabecalho curto (%u bytes)", nome, (unsigned)f.size()); f.close(); return false; }
  registra("som: tocando %s (%u bytes)", nome, (unsigned)f.size());
  if (!somAbre()) { f.close(); return false; }
  uint8_t b[512]; int n;
  while ((n = f.read(b, sizeof b)) > 0) for (int i = 0; i < n; i++) somPoe(b[i]);
  f.close(); somFecha();
  return true;
}
void somAcordar() { if (!tocaArquivo("/acordar.wav")) fala(H_FELIZ); }
void somDormir()  { if (!tocaArquivo("/dormir.wav")) fala(H_SONO); }
// Chamado quando a cara muda: acordou ou foi dormir.
unsigned long somOiEm = 0, somTchauEm = 0;                 // ultimo "oi"/"tchau" (para nao repetir)
void somDaCara(Cara antes, Cara depois) {
  if (millis() < 15000) return;                            // ligou agora: sem barulho
  if (antes == C_DORMINDO && depois != C_DORMINDO) { registra("som: acordou"); somAcordar(); somOiEm = millis(); }
  else if (depois == C_DORMINDO && antes != C_DORMINDO && (!somTchauEm || millis() - somTchauEm > 600000)) { registra("som: dormiu"); somDormir(); }
}
// Eventos do Claude Code que falam: esperando voce, erro, terminou, commit, teste que falhou,
// abriu uma sessao (oi) e fechou a ultima (tchau).
// A placa responde ao PC primeiro e fala logo depois, no loop.
#define SOM_OI -2
#define SOM_TCHAU -3
int somPendente = -1;
void somDoEvento(const char* tipo) {
  if (millis() < 15000 || demo) return;
  if (!strcmp(tipo, "inicio")) { if (millis() - somOiEm > 3000) somPendente = SOM_OI; }   // se acordou agora, ja disse oi
  else if (!strcmp(tipo, "fim")) { if (dados.n == 0) somPendente = SOM_TCHAU; }
  else if (!strcmp(tipo, "atencao")) somPendente = H_PERGUNTA;
  else if (!strcmp(tipo, "commit")) somPendente = H_EMPOLGADO;
  else if (!strcmp(tipo, "teste_falhou")) somPendente = H_PREOCUPADO;
  else if (!strcmp(tipo, "erro")) somPendente = H_BRAVO;
  else if (!strcmp(tipo, "parou")) somPendente = H_PRONTO;
}
void cuidaSomE32() {
  if (somPendente == -1) return;
  int h = somPendente; somPendente = -1;
  if (h == SOM_OI) { registra("som: oi"); somAcordar(); somOiEm = millis(); }
  else if (h == SOM_TCHAU) { registra("som: tchau"); somDormir(); somTchauEm = millis(); }
  else fala(h);
}
#else
void fala(int) {}
void somAcordar() {}
void somDormir() {}
void somDaCara(Cara, Cara) {}
void somDoEvento(const char*) {}
void cuidaSomE32() {}
#endif
void cuidaSom() { cuidaSomE32(); }

void desenhaCabecalho() {
  desenhaBateria();
  char t[24];
  snprintf(t, sizeof t, "CLAUDE CODE");
  cTitulo.mostra(t, COR_OURO);
  // ctx: quanto do contexto da conversa (do ultimo terminal que mandou numeros) ja foi usado
#ifdef PLACA_E32R28T
  if (false) {                           // na E32 o contexto tem anel proprio
#else
  if (dados.ok && dados.ctx > 0) {
#endif
    snprintf(t, sizeof t, tx(T_USO_CTX), dados.ctx);
    cCtx.mostra(t, dados.ctx >= 90 ? COR_CRITICO : dados.ctx >= 75 ? COR_ALERTA : COR_APAGADO);
  } else cCtx.mostra("", COR_APAGADO);
  if (relogioValido()) { horaStr(time(nullptr), t, sizeof t); cRelogio.mostra(t, COR_TEXTO); }
  else cRelogio.mostra("--:--", COR_APAGADO);
}

void desenhaRodape() {
  char t[48], h[16];
  if (servidor == SRV_SEM_WIFI)       { cRodape.mostra(tx(T_USO_SEM_WIFI), COR_CRITICO); return; }
  if (servidor == SRV_INICIANDO)      { cRodape.mostra(tx(T_USO_CONECTANDO), COR_APAGADO); return; }
  if (!dados.ok || dados.at == 0) {
    snprintf(t, sizeof t, tx(T_USO_AGUARDANDO_PC), WiFi.localIP().toString().c_str());
    cRodape.mostra(t, COR_APAGADO); return;
  }
  if (congelado()) {
    diaHoraStr(dados.at, h, sizeof h);
    snprintf(t, sizeof t, tx(T_USO_DORMINDO_DESDE), h);
    cRodape.mostra(t, COR_APAGADO);
  } else {
    snprintf(t, sizeof t, tx(dados.n == 1 ? T_USO_TERMINAL : T_USO_TERMINAIS), dados.n, WiFi.localIP().toString().c_str());
    cRodape.mostra(t, COR_OK);
  }
}

void desenhaJanela(BlocoJanela& b, const char* nome, int pct, long reseta, bool semana) {
  char t[40];
  b.rotulo.mostra(nome, COR_APAGADO);
  bool vencida = reseta > 0 && relogioValido() && (long)time(nullptr) >= reseta;
  if (dados.ok && vencida) {             // numero velho de uma janela que ja renovou
    b.pct.mostra("0%", COR_TEXTO); b.reseta.mostra(tx(T_USO_RENOVOU), COR_OK); b.resta.mostra("", COR_TEXTO);
    b.barra.mostra(0, COR_OURO); return;
  }
  if (dados.ok) {
    // Na exibicao automatica, o numero acima de 75 % sai na cor do alerta; no
    // modo intenso (>= 90 %) pisca a cada segundo (desenha() roda a cada 1 s).
    uint16_t cor = COR_TEXTO;
    if (consumo.naTela && pct >= 75) cor = corPct(pct);
    if (consumo.naTela && consumo.telaIntensa && pct >= 90 && (millis() / 1000) % 2) cor = COR_BLOCO;
    snprintf(t, sizeof t, "%d%%", pct); b.pct.mostra(t, cor);
    if (reseta > 0 && relogioValido()) {
      char h[20];
      if (semana) diaHoraStr(reseta, h, sizeof h); else horaStr(reseta, h, sizeof h);
      snprintf(t, sizeof t, tx(T_USO_RESETA), h); b.reseta.mostra(t, COR_APAGADO);
      restanteStr(reseta, t, sizeof t);      b.resta.mostra(t, COR_TEXTO);
    } else { b.reseta.mostra(pct == 0 ? tx(T_USO_JANELA_LIVRE) : "", COR_APAGADO); b.resta.mostra("", COR_TEXTO); }
  } else { b.pct.mostra("--", COR_APAGADO); b.reseta.mostra(tx(T_USO_AGUARDANDO), COR_APAGADO); b.resta.mostra("", COR_TEXTO); }
  b.barra.mostra(dados.ok ? pct : 0, corPct(pct));
}

#ifdef PLACA_E32R28T
// ---- E32R28T: o consumo em tres aneis (5 horas, 7 dias e o contexto da
// sessao), lado a lado, com o numero no meio. A placa desenha arcos direto;
// no Nextion seguem as barras. O contexto ganha cor antes dos 100 %, porque o
// Claude Code compacta a conversa um pouco antes de encher.

void anelArco(int cx, int pct, uint16_t cor) {
  e32.fillArc(cx, ANEL_Y, ANEL_R0, ANEL_R1, 0, 360, (uint16_t)COR_TRILHO);
  if (pct <= 0) return;
  float fim = -90 + 3.6f * constrain(pct, 0, 100);
  e32.fillArc(cx, ANEL_Y, ANEL_R0, ANEL_R1, -90, fim, cor);
}
// pct < 0: sem dado. l2: a linha de baixo (quanto falta para renovar...).
void mostraAnel(Anel& a, const char* rotulo, int pct, uint16_t cor, const char* l2, uint16_t corL2, bool pisca) {
  char t[8]; if (pct >= 0) snprintf(t, sizeof t, "%d%%", pct); else strcpy(t, "--");
  if (pct != a.pct || cor != a.cor) {             // o arco so redesenha quando muda
    anelArco(a.cx, pct, cor); a.pct = pct; a.cor = cor; a.txt[0] = 0;
  }
  uint16_t corNum = pct < 0 ? COR_APAGADO : (pisca && (millis() / 1000) % 2 ? COR_FUNDO : COR_TEXTO);
  if (strcmp(t, a.txt) || pisca) { a.num.mostra(t, corNum); strlcpy(a.txt, t, sizeof a.txt); }
  a.rotulo.mostra(rotulo, COR_APAGADO);
  if (strcmp(l2, a.l2)) { a.linha2.mostra(l2, corL2); strlcpy(a.l2, l2, sizeof a.l2); }
}
void anelJanela(Anel& a, const char* rotulo, int pct, long reseta) {
  char t[24] = "";
  bool vencida = reseta > 0 && relogioValido() && (long)time(nullptr) >= reseta;
  if (!dados.ok) { mostraAnel(a, rotulo, -1, COR_TRILHO, tx(T_USO_AGUARDANDO), COR_APAGADO, false); return; }
  if (vencida) { mostraAnel(a, rotulo, 0, COR_OURO, tx(T_USO_RENOVOU), COR_OK, false); return; }
  if (reseta > 0 && relogioValido()) restanteStr(reseta, t, sizeof t);
  else if (pct == 0) strlcpy(t, tx(T_USO_JANELA_LIVRE), sizeof t);
  bool pisca = consumo.naTela && consumo.telaIntensa && pct >= 90;
  mostraAnel(a, rotulo, pct, corPct(pct), t, COR_TEXTO, pisca);
}
#endif

void desenha() {
  if (pagina == 0 || pagina >= 2) return;   // olhos, manutencao ou paleta: nada a atualizar
  desenhaCabecalho();
#ifdef PLACA_E32R28T
  anelJanela(aneis[0], tx(T_USO_ANEL_5H), dados.h5, dados.h5r);
  anelJanela(aneis[1], tx(T_USO_ANEL_7D), dados.d7, dados.d7r);
  {
    int c = dados.ok && dados.ctx >= 0 ? dados.ctx : -1;
    uint16_t cor = c >= 85 ? COR_CRITICO : c >= 70 ? COR_ALERTA : COR_OURO;
    mostraAnel(aneis[2], tx(T_USO_ANEL_CTX), c, c < 0 ? COR_TRILHO : cor, tx(T_USO_ANEL_SESSAO), COR_APAGADO, false);
  }
#else
  desenhaJanela(b5h, tx(T_USO_SESSAO_5H), dados.h5, dados.h5r, false);
  desenhaJanela(b7d, tx(T_USO_SEMANA_7D), dados.d7, dados.d7r, true);
#endif
  desenhaRodape();
}

void mudaPagina(int p) {
  pagina = p; batNaTela = -2; paginaDesde = millis(); paginaDur = VOLTA_PAGINA_MS;
  consumo.naTela = false; consumo.telaIntensa = false;
  desenhaMoldura();
  desenha();
  if (pagina == 0) { cuidaRosto(); cuidaLegenda(); }
}

// ---------------------------------------------------------------- consumo automatico
int faixaDe(int pct) { return pct >= 90 ? 90 : pct >= 75 ? 75 : pct >= 50 ? 50 : 0; }
bool usoIntenso() { return dados.h5 >= 90 || dados.d7 >= 90; }

// Junta pedidos: vale a maior duracao; "so se subiu" so se todos pedirem.
void pedeConsumo(unsigned long dur, bool soSeSubiu, bool intenso) {
  if (!consumo.pendente) { consumo.soSeSubiu = soSeSubiu; consumo.dur = dur; consumo.intenso = intenso; }
  else { consumo.soSeSubiu = consumo.soSeSubiu && soSeSubiu; consumo.dur = max(consumo.dur, dur); consumo.intenso = consumo.intenso || intenso; }
  consumo.pendente = true;
}

// Chamado quando chegam numeros novos (status line): avisa limite cruzado.
void confereLimites() {
  int f5 = faixaDe(dados.h5), f7 = faixaDe(dados.d7);
  if (faixa5 < 0) { faixa5 = f5; faixa7 = f7; mostrado5 = dados.h5; mostrado7 = dados.d7; return; }   // primeiro dado apos ligar: sem alarde
  bool subiu = false;
  if (f5 > faixa5) { registra("consumo: 5 h passou de %d%%", f5); subiu = true; }
  if (f7 > faixa7) { registra("consumo: 7 dias passou de %d%%", f7); subiu = true; }
  faixa5 = f5; faixa7 = f7;                  // tambem desce quando a janela renova
  if (subiu) { bool i = usoIntenso(); pedeConsumo(i ? 30000 : 15000, false, i); if (i) ultimoIntenso = 0; }
}

// Janela que venceu: carinha feliz e zera as referencias.
void confereRenovacao() {
  if (!dados.ok || !relogioValido()) return;
  long agora = time(nullptr);
  bool v5 = dados.h5r > 0 && agora >= dados.h5r, v7 = dados.d7r > 0 && agora >= dados.d7r;
  bool nova = (v5 && !renovou5) || (v7 && !renovou7);
  if (v5 && !renovou5) { mostrado5 = 0; faixa5 = 0; }
  if (v7 && !renovou7) { mostrado7 = 0; faixa7 = 0; }
  renovou5 = v5; renovou7 = v7;
  if (nova && dados.n > 0 && !congelado()) { registra("consumo: janela renovou"); poeCara(C_FELIZ, 5000); poeLegenda(T_LEGENDA_JANELA); }
}

// Atende o pedido pendente quando o Claudinho esta parado no rosto.
void cuidaConsumo() {
  if (demo) return;
  if (!consumo.pendente || pagina != 0) return;
  if (!dados.ok || dados.n == 0 || congelado()) { consumo.pendente = false; return; }
  if (evento.ate && (long)(millis() - evento.ate) < 0) return;      // ainda numa cara de evento
  consumo.pendente = false;
  bool intenso = consumo.intenso;
  if (consumo.soSeSubiu) {
    bool subiu = dados.h5 - mostrado5 >= 5 || dados.d7 - mostrado7 >= 5;
    bool vezIntensa = usoIntenso() && millis() - ultimoIntenso >= INTENSO_INTERVALO_MS;
    if (!subiu && !vezIntensa) return;
    if (vezIntensa) intenso = true;
  }
  unsigned long dur = intenso ? max(consumo.dur, 30000UL) : consumo.dur;
  registra("consumo: mostrando %lu s%s", dur / 1000, intenso ? " (intenso)" : "");
  mudaPagina(1);
  paginaDur = dur; consumo.naTela = true; consumo.telaIntensa = intenso;
  mostrado5 = dados.h5; mostrado7 = dados.d7;
  if (intenso) ultimoIntenso = millis();
}

// ---------------------------------------------------------------- paleta de cor do rosto
// claudinho.sh cor (sem numeros) abre a paleta na tela, para combinar o rosto
// com a cor do filamento. Pagina 3: 6 cores base; pagina 4: 12 variacoes da
// escolhida, sempre no MESMO tom, numa moldura em volta da tela (do mais claro
// e pastel ao mais escuro e vivo, em sentido horario), com o tom tocado grande
// no centro para comparar com o filamento; tocar no centro confirma;
// pagina 5: previa do rosto com Gravar / Voltar (as 24) / Cancelar. Tocar
// numa cor ja avanca; 1 min sem toque cancela (volta a cor de antes).
// Os olhos ficam sempre pretos: a variacao mais escura para antes de some-los.
static const unsigned long PALETA_ESPERA_MS = 60000;
struct CorBase { float h, s, v; };
static const CorBase CORES_BASE[6] = {
  {21, 0.88f, 0.94f},   // laranja Clawd
  {0,  0.85f, 0.90f},   // vermelho
  {48, 0.85f, 0.97f},   // amarelo
  {125, 0.70f, 0.75f},  // verde
  {212, 0.75f, 0.90f},  // azul
  {275, 0.60f, 0.80f},  // roxo
};
static const float VAR_S[4] = {0.50f, 0.70f, 0.85f, 1.0f};   // fracao da saturacao da base
static const float VAR_V[3] = {1.0f, 0.88f, 0.74f};           // brilho
int paletaBase = 0, paletaTom = -1;   // tom da moldura mostrado no centro (-1: a cor base)
uint16_t corAntesPaleta = COR_ROSTO;

uint16_t hsv565(float h, float s, float v) {
  h = fmodf(h + 360.0f, 360.0f);
  float c = v * s, x = c * (1 - fabsf(fmodf(h / 60.0f, 2) - 1)), m = v - c, r, g, b;
  if (h < 60)       { r = c; g = x; b = 0; } else if (h < 120) { r = x; g = c; b = 0; }
  else if (h < 180) { r = 0; g = c; b = x; } else if (h < 240) { r = 0; g = x; b = c; }
  else if (h < 300) { r = x; g = 0; b = c; } else               { r = c; g = 0; b = x; }
  return RGB565((int)((r + m) * 255), (int)((g + m) * 255), (int)((b + m) * 255));
}
uint16_t corBase(int i) { return i == 0 ? COR_ROSTO : hsv565(CORES_BASE[i].h, CORES_BASE[i].s, CORES_BASE[i].v); }
uint16_t corVariacao(int base, int lin, int col) {
  return hsv565(CORES_BASE[base].h, CORES_BASE[base].s * VAR_S[col], VAR_V[lin]);
}

// Moldura de 12 quadrados de 80 x 60: k 0-3 em cima (esq->dir), 4-5 a direita
// (cima->baixo), 6-9 embaixo (dir->esq), 10-11 a esquerda (baixo->cima).
// Centro livre: 160 x 120.
static const int CEL_W = 80, CEL_H = 60, N_TONS = 12;
void posMoldura(int k, int& x, int& y) {
  if (k < 4)       { x = k * CEL_W;         y = 0; }
  else if (k < 6)  { x = 3 * CEL_W;         y = (k - 3) * CEL_H; }
  else if (k < 10) { x = (9 - k) * CEL_W;   y = 3 * CEL_H; }
  else             { x = 0;                 y = (12 - k) * CEL_H; }
}
int tomNaMoldura(int tx, int ty) {        // -1: centro
  for (int k = 0; k < N_TONS; k++) { int x, y; posMoldura(k, x, y);
    if (tx >= x && tx < x + CEL_W && ty >= y && ty < y + CEL_H) return k; }
  return -1;
}
uint16_t corTom(int k) { return k < 0 ? corBase(paletaBase) : corVariacao(paletaBase, k / 4, k % 4); }
void desenhaCentroPaleta() {
  uint16_t c = corTom(paletaTom);
  preenche(CEL_W + 2, CEL_H + 2, 320 - 2 * CEL_W - 4, 240 - 2 * CEL_H - 4, c);
  escreve(CEL_W + 2, 150, 320 - 2 * CEL_W - 4, 18, FONTE_P, COR_OLHO, c, 1, tx(T_PALETA_CONFIRMAR));
}

void irPaleta(int p) { mudaPagina(p); paginaDur = PALETA_ESPERA_MS; }

void desenhaPaleta() {
  if (pagina == 3) {                                     // 6 cores base, 3 x 2
    limpaTela(COR_FUNDO);
    for (int i = 0; i < 6; i++) preenche((i % 3) * 106 + 4, (i / 3) * 120 + 4, 100, 112, corBase(i));
  } else if (pagina == 4) {                              // moldura de 12 tons + centro
    limpaTela(COR_FUNDO);
    for (int k = 0; k < N_TONS; k++) { int x, y; posMoldura(k, x, y); preenche(x + 1, y + 1, CEL_W - 2, CEL_H - 2, corTom(k)); }
    desenhaCentroPaleta();
  } else {                                               // previa: rosto + botoes
    limpaTela(corRosto());
    ultimaEsq = {}; ultimaDir = {}; ultimaExtra = {}; ultimaBoca = {};
    formaEsq = Forma(); formaDir = Forma(); bocaNaTela = BP_NENHUMA; esqueceExtras();
    Expr x; expressao(C_NEUTRO, 0, x); desenhaExpr(x);
    preenche(4,   200, 100, 36, COR_OK);      escreve(4,   208, 100, 20, FONTE_P, COR_BRANCO, COR_OK,      1, tx(T_PALETA_GRAVAR));
    preenche(110, 200, 100, 36, COR_FUNDO);   escreve(110, 208, 100, 20, FONTE_P, COR_BRANCO, COR_FUNDO,   1, tx(T_PALETA_VOLTAR));
    preenche(216, 200, 100, 36, COR_CRITICO); escreve(216, 208, 100, 20, FONTE_P, COR_BRANCO, COR_CRITICO, 1, tx(T_PALETA_CANCELAR));
  }
}

void abrePaleta() { corAntesPaleta = corRostoAtual; registra("cor: paleta aberta"); irPaleta(3); }
void cancelaPaleta(const char* porque) {
  corRostoAtual = corAntesPaleta; registra("cor: cancelada (%s)", porque); voltaRepouso();
}
void gravaCor(uint16_t cor) {
  corRostoAtual = cor;
  prefs.begin("claudinho", false); prefs.putUShort("cor", cor); prefs.end();
  registra("cor: gravada 0x%04X", cor);
}

// Toque (soltou) em uma das telas da paleta.
void toquePaleta(int tx, int ty) {
  if (pagina == 3) { paletaBase = min(1, ty / 120) * 3 + min(2, tx / 106); paletaTom = -1; irPaleta(4); }
  else if (pagina == 4) {
    int k = tomNaMoldura(tx, ty);
    if (k >= 0) { paletaTom = k; desenhaCentroPaleta(); paginaDesde = millis(); }   // mostra no centro
    else { corRostoAtual = corTom(paletaTom); irPaleta(5); }                         // centro: confirma
  }
  else if (ty >= 192) {
    if (tx < 107)      { gravaCor(corRostoAtual); voltaRepouso(); }
    else if (tx < 213) irPaleta(4);
    else               cancelaPaleta("botao");
  }
}

// ---------------------------------------------------------------- jogo da velha
// claudinho.sh velha (a skill chama quando a pessoa pede) abre o tabuleiro na
// pagina 6. Voce e o X, o Claudinho joga com um mini Clawd, e a jogada dele roda aqui mesmo
// (minimax), sem Claude nem token. Cada partida sorteia o quanto ele erra.
// No fim: risca a linha, mostra o rosto reagindo com uma palavra, e comeca
// outra partida sozinha (quem comeca alterna). Passatempo:
// sem placar e sem toque a mais. Sai com 3 toques rapidos no mesmo quadrado
// ou 2 min sem toque. "Esperando voce" do Claude Code vira aviso no canto.
static const unsigned long VELHA_ESPERA_MS = 120000, VELHA_PENSA_MS = 600, VELHA_TRIPLO_MS = 1500;
static const unsigned long VELHA_RISCO_MS = 1200, VELHA_REACAO_MS = 3500;   // linha riscada, depois o rosto
static const int VX = 55, VY = 15, VC = 70;          // tabuleiro 210 x 210, centralizado
int vTab[9];                        // 0 livre, 1 voce (X), 2 Claudinho (mini Clawd)
int vResultado = 0;                 // 0 jogando; 1 voce ganhou, 2 Claudinho, 3 empate
bool vVoceComeca = true, vReacaoNaTela = false, vAviso = false;
float vErro = 0;                    // chance de o Claudinho jogar ao acaso, sorteada por partida
unsigned long vJogaEm = 0, vFimEm = 0;
int vUltCasa = -1, vToques = 0; unsigned long vUltToque = 0;
static const int LINHAS3[8][3] = {{0,1,2},{3,4,5},{6,7,8},{0,3,6},{1,4,7},{2,5,8},{0,4,8},{2,4,6}};

int vVencedor(const int* t) {       // 1 ou 2 = venceu, 3 = empate, 0 = segue
  for (auto& l : LINHAS3) if (t[l[0]] && t[l[0]] == t[l[1]] && t[l[1]] == t[l[2]]) return t[l[0]];
  for (int i = 0; i < 9; i++) if (!t[i]) return 0;
  return 3;
}
int vMinimax(int* t, bool vezDele) {
  int r = vVencedor(t);
  if (r == 2) return 10; if (r == 1) return -10; if (r == 3) return 0;
  int melhor = vezDele ? -100 : 100;
  for (int i = 0; i < 9; i++) if (!t[i]) {
    t[i] = vezDele ? 2 : 1; int v = vMinimax(t, !vezDele); t[i] = 0;
    melhor = vezDele ? max(melhor, v) : min(melhor, v);
  }
  return melhor;
}
int vJogadaDele() {
  int livres[9], n = 0; for (int i = 0; i < 9; i++) if (!vTab[i]) livres[n++] = i;
  if (n == 9) { const int boas[5] = {0, 2, 4, 6, 8}; return boas[random(5)]; }   // tabuleiro vazio: poupa o minimax
  if (random(1000) < vErro * 1000) return livres[random(n)];
  int melhor = -100, casa = livres[0];
  for (int k = 0; k < n; k++) { int i = livres[k]; vTab[i] = 2; int v = vMinimax(vTab, false); vTab[i] = 0;
    if (v > melhor || (v == melhor && random(2))) { melhor = v; casa = i; } }
  return casa;
}

void vCentro(int i, int& cx, int& cy) { cx = VX + (i % 3) * VC + VC / 2; cy = VY + (i / 3) * VC + VC / 2; }
void vMiniClawd(int cx, int cy) {                              // a peca dele: o mesmo mini Clawd das cenas, em branco
  const int u = 4, x = cx - 7 * u, y = cy - 9 * u / 2;          // 14 x 9 blocos de 4 px
  auto cel = [&](int bx, int by, int w, int h, uint16_t c) { preenche(x + bx * u, y + by * u, w * u, h * u, c); };
  cel(2, 0, 10, 7, COR_BRANCO); cel(0, 3, 2, 2, COR_BRANCO); cel(12, 3, 2, 2, COR_BRANCO);
  for (int p : {3, 5, 8, 10}) cel(p, 7, 1, 2, COR_BRANCO);
  cel(4, 2, 1, 3, COR_OLHO); cel(9, 2, 1, 3, COR_OLHO);
}
void vDesenhaPeca(int i) {
  int cx, cy; vCentro(i, cx, cy); const int r = 22;
  if (vTab[i] == 1) for (int d = -2; d <= 2; d++) {            // X preto grosso
    nexCmdf("line %d,%d,%d,%d,%u", cx - r + d, cy - r, cx + r + d, cy + r, COR_OLHO);
    nexCmdf("line %d,%d,%d,%d,%u", cx + r + d, cy - r, cx - r + d, cy + r, COR_OLHO);
  } else if (vTab[i] == 2) vMiniClawd(cx, cy);
}
void vDesenhaAviso() {
  if (vAviso) { escreve(0, 90, VX, 18, FONTE_P, COR_CRITICO, corRosto(), 1, tx(T_VELHA_CLAUDE));
                escreve(0, 110, VX, 18, FONTE_P, COR_CRITICO, corRosto(), 1, tx(T_VELHA_CHAMA)); }
}
void vDesenhaTabuleiro() {
  limpaTela(corRosto());
  for (int k = 1; k < 3; k++) {                                   // grade preta
    preenche(VX + k * VC - 2, VY, 4, 3 * VC, COR_OLHO);
    preenche(VX, VY + k * VC - 2, 3 * VC, 4, COR_OLHO);
  }
  for (int i = 0; i < 9; i++) vDesenhaPeca(i);
  vDesenhaAviso();
}
void vNovaPartida() {
  for (int& c : vTab) c = 0;
  vResultado = 0; vReacaoNaTela = false;
  const float ERROS[3] = {0.0f, 0.25f, 0.5f}; vErro = ERROS[random(3)];
  vDesenhaTabuleiro();
  vJogaEm = vVoceComeca ? 0 : millis() + VELHA_PENSA_MS;
  registra("velha: nova partida (erro %d%%, %s comeca)", (int)(vErro * 100), vVoceComeca ? "voce" : "Claudinho");
}
void vFimDePartida(int r) {
  vResultado = r; vJogaEm = 0; vFimEm = millis(); vVoceComeca = !vVoceComeca;
  for (auto& l : LINHAS3) if (r != 3 && vTab[l[0]] == r && vTab[l[1]] == r && vTab[l[2]] == r) {   // risca a vitoria
    int x1, y1, x2, y2; vCentro(l[0], x1, y1); vCentro(l[2], x2, y2);
    for (int d = -2; d <= 2; d++) { nexCmdf("line %d,%d,%d,%d,%u", x1 + d, y1, x2 + d, y2, COR_CRITICO); nexCmdf("line %d,%d,%d,%d,%u", x1, y1 + d, x2, y2 + d, COR_CRITICO); }
    break;
  }
  registra("velha: %s", r == 1 ? "voce ganhou" : r == 2 ? "Claudinho ganhou" : "empate");
}
// Rosto reagindo ao resultado, na tela inteira, com uma palavra embaixo.
void vDesenhaReacao() {
  Cara c = vResultado == 1 ? C_TRISTE : vResultado == 2 ? C_EMPOLGADO : C_DESCONFIADO;
  const char* frase = tx(vResultado == 1 ? T_VELHA_VOCE_GANHOU : vResultado == 2 ? T_VELHA_EU_GANHEI : T_VELHA_EMPATE);
  limpaTela(corRosto());
  ultimaEsq = {}; ultimaDir = {}; ultimaExtra = {}; ultimaBoca = {};
  formaEsq = Forma(); formaDir = Forma(); bocaNaTela = BP_NENHUMA; esqueceExtras();
  Expr x; expressao(c, 0, x); desenhaExpr(x); extras(c, 0);
  escreve(0, 202, 320, 30, FONTE_M, COR_OLHO, corRosto(), 1, frase);
}
void abreVelha() {
  vVoceComeca = true; vAviso = false; vUltCasa = -1; vToques = 0;
  mudaPagina(6); paginaDur = VELHA_ESPERA_MS; vNovaPartida();
}
void avisoVelha() { if (!vAviso) { vAviso = true; if (!vResultado) vDesenhaAviso(); } }
void saiVelha(const char* porque) { registra("velha: saiu (%s)", porque); vJogaEm = 0; voltaRepouso(); }

void toqueVelha(int tx, int ty) {
  paginaDesde = millis();                                          // renova o tempo de inatividade
  if (tx < VX || tx >= VX + 3 * VC || ty < VY || ty >= VY + 3 * VC) return;
  int i = ((ty - VY) / VC) * 3 + (tx - VX) / VC;
  if (i == vUltCasa && millis() - vUltToque < VELHA_TRIPLO_MS) vToques++; else vToques = 1;
  vUltCasa = i; vUltToque = millis();
  if (vToques >= 3) { saiVelha("3 toques"); return; }
  if (vResultado || vJogaEm || vTab[i]) return;                    // fim de partida, vez dele, ou casa ocupada
  vTab[i] = 1; vDesenhaPeca(i);
  int r = vVencedor(vTab);
  if (r) vFimDePartida(r); else vJogaEm = millis() + VELHA_PENSA_MS;
}
void cuidaVelha() {
  if (pagina != 6) return;
  if (vResultado) {                                                // fim: risco -> rosto -> nova partida
    unsigned long t = millis() - vFimEm;
    if (!vReacaoNaTela && t > VELHA_RISCO_MS) { vReacaoNaTela = true; vDesenhaReacao(); }
    else if (t > VELHA_RISCO_MS + VELHA_REACAO_MS) vNovaPartida();
    return;
  }
  if (!vJogaEm || (long)(millis() - vJogaEm) < 0) return;
  vJogaEm = 0;
  int i = vJogadaDele(); vTab[i] = 2; vDesenhaPeca(i);
  int r = vVencedor(vTab);
  if (r) vFimDePartida(r);
}

// ---------------------------------------------------------------- genius
// claudinho.sh genius abre na pagina 7: 4 quadrantes (verde, vermelho,
// amarelo, azul); o Claudinho acende uma sequencia e voce repete tocando; a
// cada acerto ela cresce uma cor e acelera um pouco. Errou: o rosto reage com
// o placar e comeca outra sozinho. Roda na placa, sem token. Sai com 3 toques
// rapidos no mesmo quadrante: toques CERTOS da sequencia nao contam (ela pode
// pedir o mesmo quadrante varias vezes), so os fora de hora (enquanto ele
// mostra, depois de errar, na tela do placar). Ou 2 min sem toque.
static const int G_MAX = 64;
static const unsigned long G_TOQUE_ACESO_MS = 250, G_PAUSA_RODADA_MS = 800, G_REACAO_MS = 3500;
int gSeq[G_MAX], gLen = 0, gIdx = 0, gFase = 0;   // fase 0 mostrando, 1 sua vez, 2 placar
int gAceso = -1, gAcesoJ = -1;       // quadrante aceso pela sequencia / pelo seu toque
unsigned long gProx = 0, gApagaEm = 0, gFimEm = 0;
int gUltQ = -1, gToques = 0; unsigned long gUltToque = 0;
static const float G_TOM[4] = {125, 0, 50, 212};               // verde, vermelho, amarelo, azul

uint16_t gCor(int q, bool aceso) { return hsv565(G_TOM[q], aceso ? 0.75f : 0.85f, aceso ? 1.0f : 0.38f); }
void gQuadrante(int q, bool aceso) {
  preenche((q % 2) * 162, (q / 2) * 122, 158, 118, gCor(q, aceso));
  gCentro();
}
void gCentro() {                                               // rodada no circulo do meio
  char t[8]; snprintf(t, sizeof t, "%d", gLen);
  nexCmdf("cirs 160,120,26,%u", COR_OLHO);
  escreve(136, 108, 48, 26, FONTE_M, COR_BRANCO, COR_OLHO, 1, t);
}
void gDesenhaTudo() {
  limpaTela(COR_OLHO);
  for (int q = 0; q < 4; q++) preenche((q % 2) * 162, (q / 2) * 122, 158, 118, gCor(q, false));
  gCentro();
}
unsigned long gTempoAceso() { return max(250L, 520L - 18L * gLen); }
void gNovaRodada() {
  if (gLen < G_MAX) gSeq[gLen++] = random(4);
  gFase = 0; gIdx = 0; gAceso = -1; gProx = millis() + G_PAUSA_RODADA_MS;
  gCentro();
}
void gNovoJogo() { gLen = 0; gAcesoJ = -1; gDesenhaTudo(); gNovaRodada(); registra("genius: novo jogo"); }
void abreGenius() { gUltQ = -1; gToques = 0; mudaPagina(7); paginaDur = VELHA_ESPERA_MS; gNovoJogo(); }
void saiGenius(const char* porque) { registra("genius: saiu (%s)", porque); voltaRepouso(); }
void gPlacar() {
  int pontos = gLen - 1;
  gFase = 2; gFimEm = millis();
  registra("genius: errou, %d pontos", pontos);
  Cara c = pontos >= 8 ? C_EMPOLGADO : pontos >= 4 ? C_FELIZ : C_DESCONFIADO;
  char t[20]; snprintf(t, sizeof t, tx(T_GENIUS_PLACAR), pontos);
  limpaTela(corRosto());
  ultimaEsq = {}; ultimaDir = {}; ultimaExtra = {}; ultimaBoca = {};
  formaEsq = Forma(); formaDir = Forma(); bocaNaTela = BP_NENHUMA; esqueceExtras();
  Expr x; expressao(c, 0, x); desenhaExpr(x); extras(c, 0);
  escreve(0, 202, 320, 30, FONTE_M, COR_OLHO, corRosto(), 1, t);
}
void toqueGenius(int tx, int ty) {
  paginaDesde = millis();
  int q = (ty >= 120 ? 2 : 0) + (tx >= 160 ? 1 : 0);
  bool certo = gFase == 1 && q == gSeq[gIdx];
  if (!certo) {                                                  // so toque fora de hora conta para sair
    if (q == gUltQ && millis() - gUltToque < VELHA_TRIPLO_MS) gToques++; else gToques = 1;
    gUltQ = q; gUltToque = millis();
    if (gToques >= 3) { saiGenius("3 toques"); return; }
    if (gFase == 1) gPlacar();                                   // errou a sequencia
    return;
  }
  gToques = 0; gUltQ = -1;
  if (gAcesoJ >= 0) gQuadrante(gAcesoJ, false);
  gAcesoJ = q; gQuadrante(q, true); gApagaEm = millis() + G_TOQUE_ACESO_MS;
  if (++gIdx >= gLen) gNovaRodada();
}
void cuidaGenius() {
  if (pagina != 7) return;
  unsigned long agora = millis();
  if (gFase == 2) { if (agora - gFimEm > G_REACAO_MS) gNovoJogo(); return; }
  if (gAcesoJ >= 0 && (long)(agora - gApagaEm) >= 0) { gQuadrante(gAcesoJ, false); gAcesoJ = -1; }   // seu toque apaga
  if (gFase == 1) return;
  if ((long)(agora - gProx) < 0) return;                         // fase 0: mostrando a sequencia
  if (gAceso >= 0) { gQuadrante(gAceso, false); gAceso = -1; gProx = agora + 160; gIdx++; return; }
  if (gIdx < gLen) { gAceso = gSeq[gIdx]; gQuadrante(gAceso, true); gProx = agora + gTempoAceso(); return; }
  gFase = 1; gIdx = 0;                                           // sua vez
}

// ---------------------------------------------------------------- impressora Bambu (opcional)
// Desligado ate a pessoa configurar (claudinho.sh bambu IP; o codigo de acesso
// LAN fica gravado na placa). O Claudinho conecta direto no MQTT da propria
// impressora (TLS na porta 8883, usuario bblp), sem servidor nem nuvem nem
// biblioteca: o MQTT e escrito aqui, a criptografia vem do nucleo do ESP32.
// Assina device/+/report (o numero de serie vem no topico) e le so os campos
// do painel. Impressora desligada: testa a porta rapido e tenta de novo em 1 min.
// Pagina 9: painel da impressora. Imprimindo, aparece sozinho a cada 5 min por
// 15 s; tocar fixa (fica ate tocar de novo).
// Pagina 8: alertas (comecou, pausou e por que, retomou, faltam 5 min, trocou
// o filamento, terminou, falhou/cancelada, avisos HMS, AMS umido). Os de
// andamento (comecou, retomou, faltam 5 min, trocou o filamento) saem sozinhos
// em 20 s; os outros ficam ate um toque (o toque = "li"). Varios fazem fila, e
// um aviso novo da impressao tira da fila os de andamento que ficaram velhos
// (e a pausa, quando ela voltou ou acabou). Voltou a imprimir = resolveram:
// pausa, HMS e o fim da impressao anterior saem sem toque. HMS que chega
// imprimindo sai sozinho; o que a impressora tira da lista sai da fila; codigo
// sem descricao no nivel "aviso" so vai para o log. Em jogo, paleta ou
// atualizacao, esperam a pessoa voltar ao rosto.
static const unsigned long B_TENTA_MS = 60000, B_PING_MS = 30000, B_SILENCIO_MS = 100000;
static const unsigned long B_AUTO_MS = 300000, B_AUTO_DUR_MS = 15000, B_FIXO = 0x7FFFFFFFUL;
static const uint32_t B_MAX_MSG = 24576;
String bIp, bCod, bSerial;
WiFiClientSecure bCli;
bool bConectado = false;
unsigned long bProxTentativa = 0, bUltDado = 0, bUltPing = 0, bUltAuto = 0;
int bFase = 0; uint8_t bCab = 0; uint32_t bRestante = 0, bMult = 1, bLidos = 0; uint8_t* bBuf = nullptr; bool bDescarta = false;
struct {
  char estado[12] = ""; char nome[48] = "";
  int pct = -1, restante = -1, camada = -1, camadas = -1, erro = 0, stg = -1, trayNow = 255;
  float bico = 0, bicoAlvo = 0, mesa = 0, mesaAlvo = 0;
  uint32_t cor[4] = {0, 0, 0, 0}; char tipo[4][8] = {"", "", "", ""}; bool temAms = false;
  int umid = -1, camara = -1; float amsTemp = -100; char modelo[24] = ""; long inicio = 0;   // inicio: hora em que a impressao comecou (da impressora)
} bi;

// ---- alertas (pagina 8)
enum { A_GERAL, A_FILAMENTO, A_ANDAMENTO, A_PAUSA, A_FIM, A_HMS };
#define A_BIT(t) (1u << (t))
struct Alerta { uint8_t tipo; uint16_t cor; char titulo[24]; char l1[56]; char l2[60]; char codigo[24]; char hora[6]; uint32_t amostra; bool fixo; };   // fixo: espera o toque
static const int A_MAX = 6;
static const unsigned long A_INFO_MS = 20000, A_INFO_REPETE_MS = 1800000;   // informativo: some em 20 s; nao repete em 30 min
Alerta aFila[A_MAX]; int aN = 0;
unsigned long bInicioEm = 0, bPausaPend = 0; bool b5min = false, bUmidAvisada = false; int bUltTray = -1;
uint32_t bHmsVisto[8][2]; int bHmsN = 0; bool bHmsBase = false;

void abreAlerta() { mudaPagina(8); paginaDur = aFila[0].fixo ? B_FIXO : A_INFO_MS; }
// Tira da fila os alertas dos tipos da mascara (e, com codigo, so o HMS com esse codigo).
// Devolve se o da frente mudou; quem chama decide se redesenha.
bool tiraAlertas(uint32_t mascara, const char* codigo) {
  bool cabecaMudou = false; int j = 0;
  for (int i = 0; i < aN; i++) {
    bool sai = (mascara & A_BIT(aFila[i].tipo)) && (!codigo || !strcmp(aFila[i].codigo, codigo));
    if (sai) { if (i == 0) cabecaMudou = true; registra("bambu: alerta velho tirado (%s)", aFila[i].titulo); }
    else aFila[j++] = aFila[i];
  }
  aN = j;
  return cabecaMudou;
}
void redesenhaFila(bool cabecaMudou) {
  if (pagina != 8 || !cabecaMudou) return;
  if (aN) abreAlerta(); else voltaRepouso();
}
// Imprimindo de novo = o problema foi resolvido: pausa, aviso da impressora e o fim
// da impressao anterior saem da fila sem esperar o toque.
const uint32_t A_RESOLVIDOS = A_BIT(A_PAUSA) | A_BIT(A_HMS) | A_BIT(A_FIM);
void novoAlerta(uint8_t tipo, uint16_t cor, const char* titulo, const char* l1, const char* l2, uint32_t amostra) {
  Alerta* a = nullptr; bool cabecaMudou = false;
  // o que este alerta deixa velho
  uint32_t velhos = 0;
  if (tipo == A_ANDAMENTO) velhos = A_BIT(A_ANDAMENTO) | A_BIT(A_FILAMENTO) | A_RESOLVIDOS;   // comecou/retomou/faltam 5: esta imprimindo
  else if (tipo == A_PAUSA) velhos = A_BIT(A_ANDAMENTO) | A_BIT(A_FILAMENTO) | A_BIT(A_PAUSA);
  else if (tipo == A_FIM) velhos = A_BIT(A_ANDAMENTO) | A_BIT(A_FILAMENTO) | A_BIT(A_PAUSA) | A_BIT(A_FIM);
  if (velhos) cabecaMudou = tiraAlertas(velhos, nullptr);
  if (tipo == A_FILAMENTO) for (int i = 0; i < aN; i++) if (aFila[i].tipo == A_FILAMENTO) a = &aFila[i];   // troca de cor: um aviso so, atualizado
  if (!a) {
    if (aN == A_MAX) { memmove(aFila, aFila + 1, sizeof(Alerta) * (A_MAX - 1)); aN--; cabecaMudou = true; }   // fila cheia: sai o mais velho
    a = &aFila[aN++];
  }
  a->tipo = tipo; a->cor = cor; a->amostra = amostra; a->fixo = tipo != A_ANDAMENTO && tipo != A_FILAMENTO;
  strlcpy(a->titulo, titulo, sizeof a->titulo); strlcpy(a->l2, l2, sizeof a->l2); a->codigo[0] = 0;
  strlcpy(a->l1, l1 == bi.nome ? "" : l1, sizeof a->l1);   // o nome da impressao esta errado (projeto + placa): fica de fora
  a->hora[0] = 0; if (relogioValido()) horaStr(time(nullptr), a->hora, sizeof a->hora);
  registra("bambu: alerta %s (%s)", titulo, l2);
  if (pagina == 8 && (a == &aFila[0] || cabecaMudou)) abreAlerta();   // o que esta na tela mudou
}
void desenhaAlerta() {
  limpaTela(COR_FUNDO);
  if (!aN) return;
  const Alerta& a = aFila[0];
  char t[64];
  // cabecalho: de onde vem, e um traco na cor do alerta
  escreve(12, 6, 180, 28, FONTE_M, COR_TEXTO, COR_FUNDO, 0, tx(T_ALERTA_IMPRESSORA_3D));
  escreve(190, 10, 118, 20, FONTE_P, COR_APAGADO, COR_FUNDO, 2, bi.modelo[0] ? bi.modelo : "Bambu Lab");
  preenche(0, 38, 320, 3, a.cor);
  bool grande = strlen(a.titulo) <= 12;
  escreve(0, grande ? 46 : 54, 320, grande ? 54 : 38, grande ? FONTE_G : FONTE_32, a.cor, COR_FUNDO, 1, a.titulo);
  escreve(8, 102, 304, 20, FONTE_P, COR_APAGADO, COR_FUNDO, 1, a.l1);
  // detalhe: uma ou duas linhas (quebra no espaco), com a amostra da cor na troca de filamento
  if (a.amostra) {
    preenche(16, 126, 34, 30, COR_BRANCO); preenche(18, 128, 30, 26, cor565(a.amostra));
    escreve(58, 126, 254, 30, FONTE_M, COR_TEXTO, COR_FUNDO, 0, a.l2);
  } else if (strlen(a.l2) <= 26) {
    escreve(8, 130, 304, 30, FONTE_M, COR_TEXTO, COR_FUNDO, 1, a.l2);
  } else {
    int n = strlen(a.l2), meio = n / 2, q = -1;              // quebra no espaco mais perto do meio
    for (int i = 0; i < n; i++) if (a.l2[i] == ' ' && (q < 0 || abs(i - meio) < abs(q - meio))) q = i;
    if (q < 0) q = meio;
    strlcpy(t, a.l2, min(q + 1, (int)sizeof t)); escreve(8, 122, 304, 26, FONTE_M, COR_TEXTO, COR_FUNDO, 1, t);
    escreve(8, 148, 304, 26, FONTE_M, COR_TEXTO, COR_FUNDO, 1, a.l2 + min(n, q + (a.l2[q] == ' ' ? 1 : 0)));
  }
  // embaixo: o Claudinho (pula ou abana os bracos), a hora, o "toque: li" e o codigo
  alertaMini(0);
  if (a.hora[0]) { snprintf(t, sizeof t, tx(T_ALERTA_AS), a.hora); escreve(110, 178, 200, 20, FONTE_P, COR_APAGADO, COR_FUNDO, 1, t); }
  const char* acao = tx(a.fixo ? T_ALERTA_TOQUE_LI : T_ALERTA_SAI_SOZINHO);
  if (aN > 1) snprintf(t, sizeof t, tx(T_ALERTA_MAIS), acao, aN - 1); else strlcpy(t, acao, sizeof t);
  escreve(110, 200, 200, 20, FONTE_P, COR_OURO, COR_FUNDO, 1, t);
  if (a.codigo[0]) escreve(110, 222, 200, 18, FONTE_P, COR_TRILHO, COR_FUNDO, 1, a.codigo);
}
void toqueAlerta() {
  if (aN) { registra("bambu: alerta lido (%s)", aFila[0].titulo); memmove(aFila, aFila + 1, sizeof(Alerta) * (A_MAX - 1)); aN--; }
  if (aN) abreAlerta(); else voltaRepouso();
}
// Mostra o proximo alerta quando a tela esta no rosto, no painel ou no consumo automatico.
void cuidaAlertas() {
  if (demo) return;
  if (aN && (pagina == 0 || pagina == 9 || pagina == 10 || (pagina == 1 && (consumo.naTela || manter)))) abreAlerta();
}

const char* motivoPausa(int stg) {
  switch (stg) {
    case 5: case 30: return tx(T_PAUSA_GCODE);
    case 6:  return tx(T_PAUSA_FILAMENTO);
    case 16: return tx(T_PAUSA_VOCE);
    case 17: return tx(T_PAUSA_TAMPA);
    case 20: return tx(T_PAUSA_TEMP_BICO);
    case 21: return tx(T_PAUSA_TEMP_MESA);
    case 23: return tx(T_PAUSA_PULOU_PASSO);
    case 26: return tx(T_PAUSA_PERDEU_AMS);
    case 27: return tx(T_PAUSA_VENTOINHA);
    case 28: return tx(T_PAUSA_TEMP_CAMARA);
    case 32: return tx(T_PAUSA_ENROLADO);
    case 33: return tx(T_PAUSA_CORTADOR);
    case 34: return tx(T_PAUSA_PRIMEIRA_CAMADA);
    case 35: return tx(T_PAUSA_ENTUPIDO);
  }
  return nullptr;
}
bool imprimindoEm(const char* e) { return !strcmp(e, "RUNNING") || !strcmp(e, "PAUSE") || !strcmp(e, "PREPARE"); }
void duracao(unsigned long ms, char* t, size_t n) {
  unsigned long m = ms / 60000;
  if (m >= 60) snprintf(t, n, tx(T_ALERTA_LEVOU_H), m / 60, m % 60); else snprintf(t, n, tx(T_ALERTA_LEVOU_MIN), m);
}
void codigoErro(uint32_t e, char* t, size_t n) { snprintf(t, n, tx(T_ALERTA_ERRO), (unsigned)(e >> 16), (unsigned)(e & 0xFFFF)); }

// Compara o que chegou com o que havia antes. Primeiro dado depois de ligar: so aprende.
void bDetecta(const char* antes, int restAntes) {
  const char* e = bi.estado; char t[40];
  if (antes[0] && strcmp(e, antes)) {
    bool era = imprimindoEm(antes), eh = imprimindoEm(e);
    if (!strcmp(e, "RUNNING")) redesenhaFila(tiraAlertas(A_RESOLVIDOS, nullptr));   // voltou a imprimir: ja resolveram
    if (!era && eh) {
      bInicioEm = millis(); b5min = false; bPausaPend = 0;
      t[0] = 0; if (bi.restante > 0) snprintf(t, sizeof t, tx(T_ALERTA_PREVISTO), bi.restante / 60, bi.restante % 60);
      novoAlerta(A_ANDAMENTO, COR_OK, tx(T_ALERTA_COMECOU), bi.nome, t, 0);
    } else if (!strcmp(e, "PAUSE")) {
      bPausaPend = millis();                                    // o motivo chega junto ou logo depois
    } else if (!strcmp(antes, "PAUSE") && eh) {
      if (bPausaPend) bPausaPend = 0;                           // pausa rapida: nem avisou
      else novoAlerta(A_ANDAMENTO, COR_OK, tx(T_ALERTA_RETOMOU), bi.nome, tx(T_ALERTA_IMPRIMINDO_DE_NOVO), 0);
    } else if (!strcmp(e, "FINISH") && era) {
      bPausaPend = 0; t[0] = 0;
      long agora = time(nullptr);                               // a hora da impressora vale mesmo depois de reiniciar
      if (bi.inicio > 1600000000L && relogioValido() && agora > bi.inicio) duracao((agora - bi.inicio) * 1000UL, t, sizeof t);
      else if (bInicioEm) duracao(millis() - bInicioEm, t, sizeof t);
      novoAlerta(A_FIM, COR_OK, tx(T_ALERTA_TERMINOU), bi.nome, t, 0);
    } else if (!strcmp(e, "FAILED") && era) {
      bPausaPend = 0;
      if (bi.erro == 0x0300400C) novoAlerta(A_FIM, COR_ALERTA, tx(T_ALERTA_CANCELADA), bi.nome, tx(T_ALERTA_IMPRESSAO_CANCELADA), 0);
      else { if (bi.erro) codigoErro(bi.erro, t, sizeof t); else strlcpy(t, tx(T_ALERTA_SEM_CODIGO), sizeof t); novoAlerta(A_FIM, COR_CRITICO, tx(T_ALERTA_FALHOU), bi.nome, t, 0); }
    }
  }
  if (!antes[0]) return;
  if (!strcmp(e, "RUNNING") && !b5min && bi.restante > 0 && bi.restante <= 5 && restAntes > 5) {
    b5min = true; novoAlerta(A_ANDAMENTO, COR_OURO, tx(T_ALERTA_FALTAM_5), bi.nome, tx(T_ALERTA_QUASE_PRONTA), 0);
  }
  // troca de filamento (255 = descarregando no meio da troca: ignora)
  if (bi.trayNow != 255) {
    if (bUltTray >= 0 && bi.trayNow != bUltTray && imprimindoEm(e)) {
      char a[16], b[16];
      if (bUltTray == 254) strlcpy(a, tx(T_ALERTA_EXTERNO), sizeof a); else snprintf(a, sizeof a, tx(T_ALERTA_SLOT), bUltTray + 1);
      if (bi.trayNow == 254) strlcpy(b, tx(T_ALERTA_EXTERNO), sizeof b); else snprintf(b, sizeof b, tx(T_ALERTA_SLOT), bi.trayNow + 1);
      bool noAms = bi.trayNow >= 0 && bi.trayNow < 4;
      snprintf(t, sizeof t, "%s > %s%s%s", a, b, noAms && bi.tipo[bi.trayNow][0] ? "  " : "", noAms ? bi.tipo[bi.trayNow] : "");
      novoAlerta(A_FILAMENTO, COR_AZUL, tx(T_ALERTA_TROCOU_FILAMENTO), bi.nome, t, noAms ? bi.cor[bi.trayNow] : 0);
    }
    bUltTray = bi.trayNow;
  }
}
void bConfereUmidade() {
  if (bi.umid < 0) return;
  if (bi.umid >= 50 && !bUmidAvisada) {
    bUmidAvisada = true; char t[40]; snprintf(t, sizeof t, tx(T_ALERTA_UMIDADE), bi.umid);
    novoAlerta(A_GERAL, COR_AZUL, tx(T_ALERTA_AMS_UMIDO), tx(T_ALERTA_SECAR), t, 0);
  } else if (bi.umid < 40) bUmidAvisada = false;
}
// HMS: a tabela gerada (hms_pt.h) da categoria, o nivel e uma frase curta em
// portugues; o codigo vai pequeno embaixo. Codigo que a tabela nao conhece:
// categoria pela familia do codigo.
const char* hmsCatFamilia(uint32_t at) {
  switch (at >> 24) {
    case 0x03: return tx(T_HMS_FAMILIA_IMPRESSORA);
    case 0x05: return tx(T_HMS_FAMILIA_SISTEMA);
    case 0x07: case 0x18: return tx(T_HMS_FAMILIA_AMS);
    case 0x0C: return tx(T_HMS_FAMILIA_CAMERA);
    case 0x29: return tx(T_HMS_FAMILIA_CAMARA);
  }
  return tx(T_HMS_FAMILIA_OUTRO);
}
void bConfereHms(JsonArray h) {
  uint32_t novo[8][2]; int n = 0;
  for (JsonObject o : h) { if (n == 8) break; novo[n][0] = o["attr"] | 0UL; novo[n][1] = o["code"] | 0UL; n++; }
  for (int i = 0; i < n && bHmsBase; i++) {
    bool visto = false;
    for (int j = 0; j < bHmsN; j++) if (bHmsVisto[j][0] == novo[i][0] && bHmsVisto[j][1] == novo[i][1]) visto = true;
    if (visto) continue;
    uint32_t at = novo[i][0], co = novo[i][1];
    char cod[24]; snprintf(cod, sizeof cod, "HMS %04X-%04X-%04X-%04X", (unsigned)(at >> 16), (unsigned)(at & 0xFFFF), (unsigned)(co >> 16), (unsigned)(co & 0xFFFF));
    const HmsCodigo* e = hmsBusca(at, co);
    // Nivel da Bambu (2o grupo do codigo): 1 fatal, 2 grave, 3 e 4 so avisam, sem efeito na impressao.
    if (!e && (co >> 16) >= 3) { registra("bambu: %s sem descricao, so aviso: ignorado", cod); continue; }
    bool info = e ? e->nivel == 0 : false;
    if (info) {                                        // informativo repetido (internet caindo e voltando): fica quieto
      static struct { uint32_t a, c; unsigned long em; } visto[6]; static int prox = 0;
      bool repetido = false;
      for (auto& v : visto) if (v.em && v.a == at && v.c == co && millis() - v.em < A_INFO_REPETE_MS) repetido = true;
      if (repetido) { registra("bambu: %s repetido, ignorado", cod); continue; }
      visto[prox] = {at, co, millis()}; prox = (prox + 1) % 6;
    }
    const char* cat; const char* frase; char onde[32] = ""; uint16_t cor;
    if (e) {
      cat = hmsCatTxt(e->cat); frase = hmsMsgTxt(e->msg);
      cor = e->nivel == 0 ? COR_AZUL : e->nivel == 1 ? COR_ALERTA : COR_CRITICO;
      if (e->unid) {
        if (e->slot) snprintf(onde, sizeof onde, "%s %c  \xb7  slot %d", e->ht ? "AMS-HT" : "AMS", e->unid, e->slot);
        else snprintf(onde, sizeof onde, "%s %c", e->ht ? "AMS-HT" : "AMS", e->unid);
      }
    } else {                                           // a Bambu inventou um codigo novo
      int sev = co >> 16;
      cat = hmsCatFamilia(at); frase = tx(T_HMS_PROCURE_WIKI);
      cor = sev <= 2 ? COR_CRITICO : sev == 3 ? COR_ALERTA : COR_AZUL;
    }
    novoAlerta(A_HMS, cor, cat, onde[0] ? onde : (bImprimindo() ? bi.nome : ""), frase, 0);
    // imprimindo, o aviso nao parou nada: sai sozinho; parada, espera o toque (ou a volta a imprimir)
    strlcpy(aFila[aN - 1].codigo, cod, sizeof aFila[aN - 1].codigo); aFila[aN - 1].fixo = !info && strcmp(bi.estado, "RUNNING");
    if (pagina == 8 && aN == 1) abreAlerta();          // redesenha com o codigo
  }
  bool cabecaMudou = false;                          // aviso que a impressora tirou da lista: resolvido
  for (int j = 0; j < bHmsN && bHmsBase; j++) {
    bool ainda = false;
    for (int i = 0; i < n; i++) if (bHmsVisto[j][0] == novo[i][0] && bHmsVisto[j][1] == novo[i][1]) ainda = true;
    if (ainda) continue;
    uint32_t at = bHmsVisto[j][0], co = bHmsVisto[j][1]; char cod[24];
    snprintf(cod, sizeof cod, "HMS %04X-%04X-%04X-%04X", (unsigned)(at >> 16), (unsigned)(at & 0xFFFF), (unsigned)(co >> 16), (unsigned)(co & 0xFFFF));
    cabecaMudou |= tiraAlertas(A_BIT(A_HMS), cod);
  }
  redesenhaFila(cabecaMudou);
  memcpy(bHmsVisto, novo, sizeof novo); bHmsN = n; bHmsBase = true;
}

bool bambuLigado() { return !bIp.isEmpty() && !bCod.isEmpty(); }
bool bImprimindo() { return !strcmp(bi.estado, "RUNNING") || !strcmp(bi.estado, "PAUSE") || !strcmp(bi.estado, "PREPARE"); }

size_t bRlen(uint8_t* o, uint32_t n) { size_t k = 0; do { uint8_t d = n & 0x7F; n >>= 7; o[k++] = d | (n ? 0x80 : 0); } while (n); return k; }
void bStr(uint8_t* p, size_t& n, const char* s) { size_t l = strlen(s); p[n++] = l >> 8; p[n++] = l & 0xFF; memcpy(p + n, s, l); n += l; }
void bEnvia(uint8_t tipo, const uint8_t* corpo, size_t n) {
  uint8_t h[5]; size_t hn = 0; h[hn++] = tipo; hn += bRlen(h + hn, n);
  bCli.write(h, hn); if (n) bCli.write(corpo, n);
}
void bPede(const char* j) {
  if (bSerial.isEmpty() || !bConectado) return;
  String t = "device/" + bSerial + "/request";
  size_t tl = t.length(), jl = strlen(j);
  uint8_t h[5]; size_t hn = 0; h[hn++] = 0x30; hn += bRlen(h + hn, 2 + tl + jl);
  uint8_t l[2] = {(uint8_t)(tl >> 8), (uint8_t)(tl & 0xFF)};
  bCli.write(h, hn); bCli.write(l, 2); bCli.write((const uint8_t*)t.c_str(), tl); bCli.write((const uint8_t*)j, jl);
}
void bPushall() {   // estado completo + modelo (o nome dado no app fica so na nuvem)
  bPede("{\"pushing\":{\"sequence_id\":\"1\",\"command\":\"pushall\"}}");
  bPede("{\"info\":{\"sequence_id\":\"2\",\"command\":\"get_version\"}}");
}
void bConecta() {
  bProxTentativa = millis() + B_TENTA_MS;
  static int falhas = 0;
  WiFiClient teste;                                    // impressora desligada: desiste em 1 s
  if (!teste.connect(bIp.c_str(), 8883, 1000)) {
    if (falhas++ < 3) { bProxTentativa = millis() + 10000; registra("bambu: impressora nao responde, tento em 10 s"); }
    return;                                            // depois disso, 1 vez por minuto e em silencio
  }
  falhas = 0;
  teste.stop();
  bCli.setInsecure(); bCli.setHandshakeTimeout(8);
  if (!bCli.connect(bIp.c_str(), 8883)) { registra("bambu: falha na conexao segura"); return; }
  String cid = "claudinho-" + macTexto(); cid.replace(":", "");
  uint8_t c[160]; size_t n = 0;
  const uint8_t var[] = {0, 4, 'M', 'Q', 'T', 'T', 4, 0xC2, 0, 60};
  memcpy(c, var, sizeof var); n = sizeof var;
  bStr(c, n, cid.c_str()); bStr(c, n, "bblp"); bStr(c, n, bCod.c_str());
  bEnvia(0x10, c, n);
  bFase = 0; bUltDado = bUltPing = millis();
}
void bSolta() { if (bBuf) { free(bBuf); bBuf = nullptr; } bFase = 0; }

void bProcessa(const uint8_t* js, size_t n) {
  if (demo) return;                                        // a demonstracao usa uma impressora de mentira
  static JsonDocument filtro; static bool pronto = false;
  if (!pronto) {
    const char* ks[] = {"gcode_state", "mc_percent", "mc_remaining_time", "layer_num", "total_layer_num", "subtask_name",
                        "nozzle_temper", "nozzle_target_temper", "bed_temper", "bed_target_temper", "print_error", "stg_cur"};
    for (auto k : ks) filtro["print"][k] = true;
    filtro["print"]["ams"]["tray_now"] = true;
    filtro["print"]["ams"]["ams"][0]["tray"][0]["id"] = true;
    filtro["print"]["ams"]["ams"][0]["tray"][0]["tray_color"] = true;
    filtro["print"]["ams"]["ams"][0]["tray"][0]["tray_type"] = true;
    filtro["print"]["ams"]["ams"][0]["humidity_raw"] = true;
    filtro["print"]["ams"]["ams"][0]["temp"] = true;
    filtro["print"]["hms"] = true;
    filtro["print"]["gcode_start_time"] = true;
    filtro["print"]["device"]["ctc"]["info"]["temp"] = true;   // camara de impressao (P2S, X1, H2)
    filtro["info"]["module"][0]["name"] = true;
    filtro["info"]["module"][0]["product_name"] = true;
    pronto = true;
  }
  JsonDocument d;
  if (deserializeJson(d, (const char*)js, n, DeserializationOption::Filter(filtro))) return;
  for (JsonObject m : d["info"]["module"].as<JsonArray>())   // o modulo "ota" e a impressora
    if (m["name"] == "ota" && m["product_name"].is<const char*>()) {
      strlcpy(bi.modelo, m["product_name"], sizeof bi.modelo);
      if (pagina == 9) painel(false);
    }
  JsonObject p = d["print"]; if (p.isNull()) return;
  char antes[12]; strlcpy(antes, bi.estado, sizeof antes); int restAntes = bi.restante;
  if (p["gcode_state"].is<const char*>()) strlcpy(bi.estado, p["gcode_state"], sizeof bi.estado);
  if (p["subtask_name"].is<const char*>()) strlcpy(bi.nome, p["subtask_name"], sizeof bi.nome);
  if (!p["mc_percent"].isNull()) bi.pct = p["mc_percent"];
  if (!p["mc_remaining_time"].isNull()) bi.restante = p["mc_remaining_time"];
  if (!p["layer_num"].isNull()) bi.camada = p["layer_num"];
  if (!p["total_layer_num"].isNull()) bi.camadas = p["total_layer_num"];
  if (!p["print_error"].isNull()) bi.erro = p["print_error"];
  if (!p["stg_cur"].isNull()) bi.stg = p["stg_cur"];
  if (!p["device"]["ctc"]["info"]["temp"].isNull()) {       // as vezes vem empacotado (alvo << 16 | atual)
    long v = p["device"]["ctc"]["info"]["temp"]; bi.camara = v > 0xFFFF ? (v & 0xFFFF) : v;
  }
  if (!p["gcode_start_time"].isNull()) bi.inicio = p["gcode_start_time"].as<String>().toInt();
  if (!p["nozzle_temper"].isNull()) bi.bico = p["nozzle_temper"];
  if (!p["nozzle_target_temper"].isNull()) bi.bicoAlvo = p["nozzle_target_temper"];
  if (!p["bed_temper"].isNull()) bi.mesa = p["bed_temper"];
  if (!p["bed_target_temper"].isNull()) bi.mesaAlvo = p["bed_target_temper"];
  JsonVariant ams = p["ams"];
  if (!ams["tray_now"].isNull()) bi.trayNow = ams["tray_now"].as<String>().toInt();
  JsonArray un = ams["ams"];
  if (!un.isNull() && un.size()) {
    for (JsonObject t : un[0]["tray"].as<JsonArray>()) {
      int id = t["id"].as<String>().toInt();
      if (id < 0 || id > 3) continue;
      if (t["tray_color"].is<const char*>()) bi.cor[id] = strtoul(t["tray_color"], nullptr, 16);
      if (t["tray_type"].is<const char*>()) strlcpy(bi.tipo[id], t["tray_type"], sizeof bi.tipo[id]);
    }
    if (!un[0]["humidity_raw"].isNull()) bi.umid = un[0]["humidity_raw"].as<String>().toInt();
    if (!un[0]["temp"].isNull()) bi.amsTemp = un[0]["temp"].as<String>().toFloat();
    bi.temAms = true;
  }
  bDetecta(antes, restAntes);
  if (p["hms"].is<JsonArray>()) bConfereHms(p["hms"]);
  bConfereUmidade();
  if (pagina == 9) painel(false);
}

void bPacote(const uint8_t* b, uint32_t n) {
  uint8_t tipo = bCab & 0xF0;
  if (tipo == 0x20) {                                  // CONNACK
    if (n >= 2 && b[1] == 0) {
      bConectado = true;
      uint8_t c[40]; size_t k = 0; c[k++] = 0; c[k++] = 1; bStr(c, k, "device/+/report"); c[k++] = 0;
      bEnvia(0x82, c, k);
      registra("bambu: conectado (memoria livre %u)", (unsigned)ESP.getFreeHeap());
      bPushall();
    } else {
      registra("bambu: codigo de acesso recusado"); bCli.stop(); bProxTentativa = millis() + 5 * B_TENTA_MS;
    }
  } else if (tipo == 0x30 && n > 2) {                  // PUBLISH
    uint8_t qos = (bCab >> 1) & 3; uint16_t tl = (b[0] << 8) | b[1];
    if (2u + tl > n) return;
    if (bSerial.isEmpty()) {                           // device/<serie>/report
      String t((const char*)b + 2, tl); int i = t.indexOf('/'), f = t.lastIndexOf('/');
      if (i > 0 && f > i) {
        bSerial = t.substring(i + 1, f);
        prefs.begin("claudinho", false); prefs.putString("bambu_sn", bSerial); prefs.end();
        registra("bambu: impressora %s", bSerial.c_str());
        bPushall();
      }
    }
    uint32_t off = 2 + tl + (qos ? 2 : 0);
    if (off < n) bProcessa(b + off, n - off);
  }
}

void bLe() {
  uint8_t tmp[256];
  int orcamento = 8;                                   // no maximo 8 leituras por volta do loop
  while (bCli.available() && orcamento-- > 0) {
    bUltDado = millis();
    if (bFase == 0) { int c = bCli.read(); if (c < 0) break; bCab = c; bRestante = 0; bMult = 1; bFase = 1; continue; }
    if (bFase == 1) {
      int c = bCli.read(); if (c < 0) break;
      bRestante += (c & 0x7F) * bMult; bMult *= 128;
      if (c & 0x80) continue;
      bLidos = 0; bDescarta = bRestante > B_MAX_MSG;
      if (bRestante == 0) { bPacote(nullptr, 0); bFase = 0; continue; }
      if (!bDescarta) { bBuf = (uint8_t*)malloc(bRestante + 1); if (!bBuf) bDescarta = true; }
      bFase = 2; continue;
    }
    uint32_t falta = bRestante - bLidos;
    int r = bDescarta ? bCli.read(tmp, min((uint32_t)sizeof tmp, falta)) : bCli.read(bBuf + bLidos, falta);
    if (r <= 0) break;
    bLidos += r;
    if (bLidos >= bRestante) {
      if (!bDescarta) { bBuf[bLidos] = 0; bPacote(bBuf, bRestante); }
      bSolta();
    }
  }
}

void cuidaBambu() {
  if (bPausaPend && millis() - bPausaPend > 4000) {
    bPausaPend = 0;
    if (!strcmp(bi.estado, "PAUSE")) {
      const char* m = motivoPausa(bi.stg); char t[40];
      if (!m && bi.erro) { codigoErro(bi.erro, t, sizeof t); m = t; }
      bool voce = bi.stg == 16 || bi.stg == 5 || bi.stg == 30;
      novoAlerta(A_PAUSA, voce ? COR_ALERTA : COR_CRITICO, tx(T_ALERTA_PAUSADA), bi.nome, m ? m : tx(T_ALERTA_MOTIVO_DESCONHECIDO), 0);
    }
  }
  cuidaAlertas();
  if (!bambuLigado() || WiFi.status() != WL_CONNECTED) return;
  if (!bCli.connected()) {
    if (bConectado) { bConectado = false; bSolta(); registra("bambu: conexao caiu"); if (pagina == 9) painel(false); }
    if ((long)(millis() - bProxTentativa) >= 0) bConecta();
    return;
  }
  bLe();
  if (bConectado && millis() - bUltPing > B_PING_MS) { bEnvia(0xC0, nullptr, 0); bUltPing = millis(); }
  if (millis() - bUltDado > B_SILENCIO_MS) { registra("bambu: sem resposta, reconectando"); bCli.stop(); }
  if (bConectado && !demo && bImprimindo() && pagina == 0 && millis() - bUltAuto > B_AUTO_MS) {   // painel a cada 5 min
    bUltAuto = millis(); abrePainel();
  }
}

// ---- painel (pagina 9)
// modelo + estado; arquivo; 3 colunas (impresso, faltam, camada); barra; temperaturas; AMS
Campo pModelo = {12, 2, 184, 30, FONTE_M, 0, COR_FUNDO}, pEstado = {196, 6, 112, 20, FONTE_P, 2, COR_FUNDO};
Campo pNome = {12, 30, 296, 20, FONTE_P, 0, COR_FUNDO};
Campo pRot[3] = {{4, 48, 104, 18, FONTE_P, 1, COR_FUNDO}, {108, 48, 104, 18, FONTE_P, 1, COR_FUNDO}, {212, 48, 104, 18, FONTE_P, 1, COR_FUNDO}};
Campo pVal[3] = {{4, 64, 104, 36, FONTE_32, 1, COR_FUNDO}, {108, 64, 104, 36, FONTE_32, 1, COR_FUNDO}, {212, 64, 104, 36, FONTE_32, 1, COR_FUNDO}};
Campo pBico = {12, 113, 104, 20, FONTE_P, 0, COR_FUNDO}, pMesa = {116, 113, 92, 20, FONTE_P, 1, COR_FUNDO}, pCamara = {208, 113, 100, 20, FONTE_P, 2, COR_FUNDO};
int pBarraPct = -2; uint16_t pBarraCor = 0; uint32_t pAmsCor[4]; int pAmsNow = -2; char pAmsTipo[4][8];

uint16_t cor565(uint32_t rgba) { return RGB565((rgba >> 24) & 0xFF, (rgba >> 16) & 0xFF, (rgba >> 8) & 0xFF); }
bool corClara(uint32_t rgba) { int r = (rgba >> 24) & 0xFF, g = (rgba >> 16) & 0xFF, b = (rgba >> 8) & 0xFF; return (r * 299 + g * 587 + b * 114) / 1000 > 140; }

void painel(bool tudo) {
  if (tudo) {
    limpaTela(COR_FUNDO);
    desenhaBotoes();
    pModelo.limpa(); pEstado.limpa(); pNome.limpa(); pBico.limpa(); pMesa.limpa(); pCamara.limpa();
    for (int i = 0; i < 3; i++) { pRot[i].limpa(); pVal[i].limpa(); }
    pBarraPct = -2; pAmsNow = -2; for (int i = 0; i < 4; i++) { pAmsCor[i] = 0xFFFFFFFF; pAmsTipo[i][0] = 1; pAmsTipo[i][1] = 0; }
  }
  char t[48];
  const char* e = bi.estado; uint16_t ce = COR_APAGADO; const char* rot = tx(T_IMP_AGUARDANDO);
  if (!bConectado) { rot = tx(T_IMP_SEM_CONEXAO); ce = COR_CRITICO; }
  else if (!strcmp(e, "RUNNING")) { rot = tx(T_IMP_IMPRIMINDO); ce = COR_OK; }
  else if (!strcmp(e, "PAUSE"))   { rot = tx(T_IMP_PAUSADA); ce = COR_ALERTA; }
  else if (!strcmp(e, "PREPARE")) { rot = tx(T_IMP_PREPARANDO); ce = COR_OURO; }
  else if (!strcmp(e, "FINISH"))  { rot = tx(T_IMP_TERMINOU); ce = COR_OK; }
  else if (!strcmp(e, "FAILED"))  { rot = tx(T_IMP_FALHOU); ce = COR_CRITICO; }
  else if (!strcmp(e, "IDLE"))    { rot = tx(T_IMP_OCIOSA); }
  pModelo.mostra(bi.modelo[0] ? bi.modelo : tx(T_IMP_IMPRESSORA), COR_TEXTO);
  pEstado.mostra(rot, ce);
  // (o nome da impressao saiu: o Bambu Studio manda "projeto + placa", que nao diz qual e a peca)
  if (bi.umid >= 0 && bi.amsTemp > -100) snprintf(t, sizeof t, tx(T_IMP_AMS_UMID_TEMP), bi.umid, (int)lroundf(bi.amsTemp));
  else if (bi.umid >= 0) snprintf(t, sizeof t, tx(T_IMP_AMS_UMID), bi.umid); else t[0] = 0;
  pNome.mostra(t, bi.umid >= 50 ? COR_AZUL : COR_APAGADO);
  bool imp = bImprimindo();
  pRot[0].mostra(tx(T_IMP_IMPRESSO), COR_APAGADO);
  if (bi.pct >= 0) snprintf(t, sizeof t, "%d%%", bi.pct); else strcpy(t, "--");
  pVal[0].mostra(t, COR_TEXTO);
  pRot[1].mostra(tx(T_IMP_FALTAM), COR_APAGADO);
  if (bi.restante > 0 && imp) {
    if (bi.restante >= 60) snprintf(t, sizeof t, "%dh%02d", bi.restante / 60, bi.restante % 60); else snprintf(t, sizeof t, "%d min", bi.restante);
  } else strcpy(t, "--");
  pVal[1].mostra(t, COR_TEXTO);
  if (bi.camadas > 0) snprintf(t, sizeof t, tx(T_IMP_CAMADA_DE), bi.camadas); else strlcpy(t, tx(T_IMP_CAMADA), sizeof t);
  pRot[2].mostra(t, COR_APAGADO);
  if (bi.camadas > 0) snprintf(t, sizeof t, "%d", bi.camada); else strcpy(t, "--");
  pVal[2].mostra(t, COR_TEXTO);
  // barra na cor do filamento que esta imprimindo
  uint16_t cb = (bi.trayNow >= 0 && bi.trayNow < 4 && bi.cor[bi.trayNow]) ? cor565(bi.cor[bi.trayNow]) : COR_OURO;
  int pc = max(0, bi.pct);
  if (pc != pBarraPct || cb != pBarraCor) {
    pBarraPct = pc; pBarraCor = cb;
    preenche(12, 101, 296, 9, COR_TRILHO);
    if (pc > 0) preenche(12, 101, 296 * min(pc, 100) / 100, 9, cb);
  }
  snprintf(t, sizeof t, tx(T_IMP_BICO), (int)lroundf(bi.bico), (int)lroundf(bi.bicoAlvo)); pBico.mostra(t, COR_TEXTO);
  snprintf(t, sizeof t, tx(T_IMP_MESA), (int)lroundf(bi.mesa), (int)lroundf(bi.mesaAlvo)); pMesa.mostra(t, COR_TEXTO);
  if (bi.camara >= 0) snprintf(t, sizeof t, tx(T_IMP_CAMARA), bi.camara); else t[0] = 0;
  pCamara.mostra(t, COR_TEXTO);
  // AMS: 4 slots; o que esta imprimindo ganha moldura branca
  if (!bi.temAms) return;
  for (int i = 0; i < 4; i++) {
    bool atual = bi.trayNow == i;
    bool mudou = pAmsCor[i] != bi.cor[i] || strcmp(pAmsTipo[i], bi.tipo[i]) || (pAmsNow == i) != atual;
    if (!mudou) continue;
    int x = 12 + i * 76, y = 140;
    preenche(x - 3, y - 3, 70, 44, atual ? COR_BRANCO : COR_FUNDO);
    uint16_t cs = bi.tipo[i][0] ? cor565(bi.cor[i]) : COR_BLOCO;
    preenche(x, y, 64, 38, cs);
    escreve(x, y + 10, 64, 18, FONTE_P, corClara(bi.cor[i]) && bi.tipo[i][0] ? COR_OLHO : COR_BRANCO, cs, 1, bi.tipo[i][0] ? bi.tipo[i] : tx(T_IMP_VAZIO));
    pAmsCor[i] = bi.cor[i]; strlcpy(pAmsTipo[i], bi.tipo[i], 8);
  }
  pAmsNow = bi.trayNow;
}
// ---- rodape: Tokens | Impressora | Manter/Dormir (o texto e a acao do toque)
// A moldura dourada fina marca a tela atual. Sem impressora: Tokens | Manter.
static const int BT_Y = 186, BT_H = 50;   // alto: da para acertar com o dedo
int nBotoes() { return bambuLigado() ? 3 : 2; }
int botaoLarg() { return (308 - (nBotoes() - 1) * 6) / nBotoes(); }
void desenhaBotoes() {
  int n = nBotoes(), w = botaoLarg();
  for (int i = 0; i < n; i++) {
    int x = 6 + i * (w + 6);
    bool tela = i < n - 1;
    const char* nome = tx(!tela ? (manter ? T_BOTAO_DORMIR : T_BOTAO_MANTER) : i == 0 ? T_BOTAO_TOKENS : T_BOTAO_IMPRESSORA);
    bool atual = tela && (i == 0 ? pagina == 1 : pagina == 9);
    preenche(x, BT_Y, w, BT_H, atual ? COR_OURO : COR_BLOCO);
    preenche(x + 1, BT_Y + 1, w - 2, BT_H - 2, COR_BLOCO);
    escreve(x + 1, BT_Y + 16, w - 2, 18, FONTE_P, COR_TEXTO, COR_BLOCO, 1, nome);
  }
}
// Abre tokens (1) ou impressora (9); com Manter, fica ate tocar em Dormir.
void abreTela(int p) {
  mudaPagina(p);
  paginaDur = manter ? B_FIXO : VOLTA_PAGINA_MS;
  if (manter) paginaManter = p;
}
// Depois de um alerta (ou quando algo pede para voltar): a tela mantida, ou o rosto.
void voltaRepouso() { if (manter) abreTela(paginaManter); else mudaPagina(0); }
int botaoEm(int tx, int ty) {                         // -1: fora dos botoes
  if (ty < BT_Y - 2 || ty > BT_Y + BT_H + 2) return -1;
  int w = botaoLarg();
  for (int i = 0; i < nBotoes(); i++) { int x = 6 + i * (w + 6); if (tx >= x - 2 && tx < x + w + 2) return i; }
  return -1;
}
void toqueTela(int tx, int ty) {
  int i = botaoEm(tx, ty);
  if (i < 0) { if (!manter) mudaPagina(0); return; }    // fora dos botoes: volta a dormir (mantida, nada)
  if (i == nBotoes() - 1) {
    manter = !manter; registra("tela: %s", manter ? "mantida" : "dorme");
    if (!manter) { mudaPagina(0); return; }
    consumo.naTela = false; consumo.telaIntensa = false;   // o cartao automatico vira escolha da pessoa
    paginaManter = pagina; paginaDesde = millis(); paginaDur = B_FIXO; desenhaBotoes();
  } else abreTela(i == 0 ? 1 : 9);
}
void abrePainel() {                                   // o automatico, a cada 5 min
  mudaPagina(9); paginaDur = B_AUTO_DUR_MS;
}

// ---------------------------------------------------------------- cenas (pagina 10)
// Enquanto o Claude usa ferramentas, em vez da cara de trabalhando o Claudinho
// mostra uma cena: editor de codigo (Edit/Write), terminal (Bash), chuva do
// Matrix (Read/Grep/Glob), organograma (Agent) ou conversa (o Claude pedindo
// uma segunda opiniao a outra IA, como o Codex). Tudo de mentira, guardado
// aqui: o que o Claude faz de verdade nunca vem para a placa (o hook manda so
// a categoria). Cada cena fica pelo menos 8 s; 12 s sem ferramenta, volta ao
// rosto. Um mini Clawd (com bracinhos e perninhas) fica no canto.
// Letra mono: fonte 5 (JetBrains Mono, 16 px de altura, 7 px por letra).
// Nada de aspas nem barra invertida nos textos: vao direto no xstr.
enum { S_NENHUMA = -1, S_CODANDO, S_TERMINAL, S_LENDO, S_AGENTE, S_CONVERSA };
static const int FONTE_MONO = 5, MONO_W = 7, MONO_LH = 17;
static const unsigned long CENA_MIN_MS = 8000, CENA_FIM_MS = 12000;
// O organograma (Agent) e raro e importante: entra na hora, por cima de
// qualquer cena, e os comandos que vem logo depois nao o tiram antes de 6 s.
static const unsigned long CENA_AGENTE_MIN_MS = 6000;
// A conversa tambem: e a outra IA costuma levar minutos num comando so, sem
// evento nenhum no meio, entao a cena fica ate o proximo evento (ate 5 min).
static const unsigned long CENA_CONVERSA_MS = 300000;
int cenaAtual = S_NENHUMA; unsigned long cenaDesde = 0, cenaProx = 0;
char acaoEvento[12] = "";

// ---- letreiro: o resumo que o Claude ja escreve para voce aprovar (a descricao
// do comando ou do agente) ou a tarefa em andamento da lista dele. O comando e o
// nome de arquivo nunca vem. Fica numa faixa no pe da cena (na cor do rosto, letra
// grande vazada na cor do fundo), digitado letra por letra; o que nao cabe rola de
// um lado para o outro. O resumo vale enquanto a cena e do mesmo tipo (e por 1 min);
// depois fica a tarefa, se houver.
static const int LT_Y = 204, LT_H = 36, LT_X = 8, LT_W = 304, LT_MAX = 64;
#ifdef PLACA_E32R28T
static const int FONTE_LT = 4;        // DM Sans SemiBold 26 px (so a E32R28T tem)
#else
static const int FONTE_LT = FONTE_M;  // no Nextion: a negrito de 24 px
#endif
static const unsigned long LT_VALE_MS = 60000;
char ltEvento[LT_MAX] = "", ltTarefa[LT_MAX] = "", ltTela[LT_MAX] = "";   // ltTela: o que esta (ou vai) na tela
int ltEventoCena = -1, ltN = 0, ltIni = 0, ltDir = 1;
unsigned long ltEventoEm = 0, ltProx = 0;
// UTF-8 (o JSON) para ISO-8859-1 (as fontes): o que nao existe na fonte some, e
// aspas e barra invertida tambem (o Nextion nao as aceita no texto).
void ltLatin1(const char* u, char* out, size_t n) {
  size_t k = 0;
  for (const uint8_t* p = (const uint8_t*)u; *p && k + 1 < n; ) {
    uint8_t c = *p++;
    if (c >= 0xC0) {
      int resto = c >= 0xF0 ? 3 : c >= 0xE0 ? 2 : 1, v = c & (0x3F >> resto);
      for (int i = 0; i < resto && (*p & 0xC0) == 0x80; i++) v = (v << 6) | (*p++ & 0x3F);
      if (v >= 0xA0 && v <= 0xFF) out[k++] = (char)v;
    } else if (c >= 0x20 && c < 0x7F && c != '"' && c != '\\') out[k++] = (char)c;
  }
  out[k] = 0;
}

int cenaDe(const char* a) {
  if (!strcmp(a, "codando"))  return S_CODANDO;
  if (!strcmp(a, "terminal")) return S_TERMINAL;
  if (!strcmp(a, "lendo"))    return S_LENDO;
  if (!strcmp(a, "agente"))   return S_AGENTE;
  if (!strcmp(a, "conversa")) return S_CONVERSA;
  return S_NENHUMA;
}

// ---- mini Clawd (pixel de 4): corpo 10x7, bracinhos 2x2 dos lados, 4 perninhas
#define MINI_W (14 * miniP)
#define MINI_H (9 * miniP)
int miniX = 0, miniY = 0; uint16_t miniFundo = 0;
void miniCel(int cx, int cy, int w, int h, uint16_t c) { preenche(miniX + cx * miniP, miniY + cy * miniP, w * miniP, h * miniP, c); }
void miniClawd(int x, int y, uint16_t fundo) {
  miniX = x; miniY = y; miniFundo = fundo;
  uint16_t r = corRosto();
  preenche(x, y, MINI_W, MINI_H, fundo);
  miniCel(2, 0, 10, 7, r);
  miniCel(0, 3, 2, 2, r); miniCel(12, 3, 2, 2, r);
  miniCel(3, 7, 1, 2, r); miniCel(5, 7, 1, 2, r); miniCel(8, 7, 1, 2, r); miniCel(10, 7, 1, 2, r);
  miniCel(4, 2, 1, 3, COR_OLHO); miniCel(9, 2, 1, 3, COR_OLHO);
}
void miniBracos(int sobe) {          // 0 nenhum, 1 esquerdo, 2 direito (digitando), 3 os dois
  uint16_t r = corRosto();
  miniCel(0, 2, 2, 3, miniFundo); miniCel(12, 2, 2, 3, miniFundo);
  miniCel(0, (sobe & 1) ? 2 : 3, 2, 2, r); miniCel(12, (sobe & 2) ? 2 : 3, 2, 2, r);
}
void miniOlhos(int dx) {             // -1 esquerda, 0 frente, 1 direita (lendo)
  miniCel(3, 2, 8, 3, corRosto());
  miniCel(4 + dx, 2, 1, 3, COR_OLHO); miniCel(9 + dx, 2, 1, 3, COR_OLHO);
}

// ---- editor: codigo de mentira, com cores de sintaxe, digitado e rolando
// Cada linha traz a cor de sintaxe em bytes 1 a 7 (ver edCor): 1 palavra-chave, 2 funcao,
// 3 texto, 4 comentario, 5 numero, 6 resto, 7 tipo.
#include "cenas.h"   // os roteiros (arquivos do editor e sessoes do terminal), gerados por scripts/gera-cenas.py
int sorteiaOutro(int n, int antes) { if (antes < 0 || n < 2) return random(n); int k = random(n - 1); return k >= antes ? k + 1 : k; }
static const int ED_TOPO = 22, ED_X = 30, ED_LINHAS = 10;   // embaixo fica o letreiro
static const uint16_t ED_FUNDO = RGB565(30, 30, 30);
int edTopo = 0, edCol = 0, edEspera = 0, edPre = 0;   // edPre: letras ja digitadas do preambulo (-1 = no editor)
int edArq = -1;                                       // arquivo aberto: cada cena sorteia outro
char ED_PRE[24];                                      // "code <arquivo>"
const char* edTexto(int li) { const Arquivo& a = ARQUIVOS[edArq]; return a.l[li % a.n]; }

uint16_t edCor(char c) {
  switch (c) {
    case 1: return RGB565(86, 156, 214);
    case 2: return RGB565(220, 220, 170);
    case 3: return RGB565(206, 145, 120);
    case 4: return RGB565(106, 153, 85);
    case 5: return RGB565(181, 206, 168);
    case 7: return RGB565(78, 201, 176);
  }
  return RGB565(212, 212, 212);
}
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
void loop() {
  web.handleClient();
  leSerialConfig();
  leToque();
  if (WiFi.status() != WL_CONNECTED) {
    static unsigned long ultimaTentativa = 0;
    if (millis() - ultimaTentativa > 10000) { ultimaTentativa = millis(); WiFi.reconnect(); }
    servidor = SRV_SEM_WIFI;
  } else if (servidor == SRV_SEM_WIFI) servidor = SRV_INICIANDO;
  cuidaManutencao();
  if (pagina != 0 && !demo && !(manter && pagina == paginaManter) && millis() - paginaDesde > paginaDur) {
    if (pagina == 2) manutPedidaEm = 0;
    if (pagina == 6) saiVelha("sem toque");
    else if (pagina == 7) saiGenius("sem toque");
    else if (pagina >= 3 && pagina <= 5) cancelaPaleta("sem toque");
    else if (pagina == 8) { if (aN && aFila[0].fixo) abreAlerta(); else toqueAlerta(); }   // so o informativo sai sozinho
    else voltaRepouso();
  }

  static unsigned long ultimoTick = 0;
  if (millis() - ultimoTick >= 1000) { ultimoTick = millis(); confereRenovacao(); desenha(); }
  cuidaConsumo();
  cuidaVelha();
  cuidaGenius();
  cuidaBambu();
  cuidaCena();
  cuidaLetreiro();
  cuidaSom();
  cuidaBateria();
  cuidaDemo();
  cuidaAlertaAnim();

  // Brilho: dormindo ha mais de 20 s -> 15 %; acordado -> 100 % (ou o que o
  // toque longo escolheu). Poupa backlight e bateria.
  {
    static unsigned long dormeDesde = 0; static int brilhoNaTela = -1;
    bool dormindo = (pagina == 0 && caraNaTela == C_DORMINDO);   // jogo, paleta e cartao: brilho normal
    if (!dormindo) dormeDesde = 0;
    else if (!dormeDesde) dormeDesde = millis();
    int alvo = (dormindo && millis() - dormeDesde > 20000) ? 15 : (brilhoAlto ? 100 : 15);
    if (alvo != brilhoNaTela) { brilhoNaTela = alvo; nexCmdf("dim=%d", alvo); }
  }

  // Ajustes do Nextion repetidos de tempos em tempos: se ele acordou depois do
  // boot do ESP (ou foi regravado), perdeu o sendxy e o toque some.
  static unsigned long ultimoAjuste = 0;
  if (millis() - ultimoAjuste >= 30000) { ultimoAjuste = millis(); nexCmd("bkcmd=0"); nexCmd("sendxy=1"); nexCmd("thsp=0"); }
  if (pagina == 0) { cuidaRosto(); cuidaLegenda(); }
  delay(10);
}
