argeuthiesen/claudinho/firmware/claudinho/hms_pt.h

// Gerado por firmware/hms/gerar.py a partir da base oficial de avisos HMS da
// Bambu Lab (versao 202609231145) e da traducao em firmware/hms/hms_pt.json. Nao editar.
#pragma once
#include <stdint.h>

struct HmsCodigo { uint32_t a, c; uint16_t txt; uint8_t cat, nivel; char unid; uint8_t ht, slot; };
static const char* const HMS_CAT[] = {
  "AMS",
  "Mesa aquecida",
  "Arquivo / cart\343o",
  "Bico / extrusora",
  "Sistema",
  "Filamento",
  "Cortador",
  "Motores / eixos",
  "C\342mara / filtro",
  "Rede / internet",
  "C\342mera / sensores",
  "Calibra\347\343o",
  "Ventoinhas",
};
static const char* const HMS_TXT[] = {
  "quantidade ou tipo de AMS ligado n\343o suportado",
  "tubo interno quebrado ou sensor n\343o v\352 o filamento",
  "etiqueta RFID do carretel n\343o foi lida",
  "falha no aquecimento da mesa; desligue j\341",
  "erro no G-code; recarregado e a impress\343o seguiu",
  "arquivo fatiado com defeito; impress\343o cancelada",
  "erro de verifica\347\343o do G-code; a impress\343o seguiu",
  "filamento n\343o sai: bico ou extrusora entupidos",
  "falha de comunica\347\343o na placa; reinicie",
  "AMS-HT esfriando depois de secar; aguarde",
  "n\343o conseguiu tirar o filamento da extrusora",
  "motor do AMS com defeito no controle",
  "falha no chip de criptografia",
  "motor auxiliar do AMS com defeito no controle",
  "sensor da v\341lvula 1 do AMS com defeito",
  "sensor de temperatura do aquecedor com defeito",
  "v\341lvula 1 do AMS travando",
  "motor auxiliar patinou: roda gasta ou fio fino",
  "motor travou: tubo entre buffer e cabe\347a",
  "ambiente frio demais para secar bem",
  "AMS quente demais; RFID e carga pausados",
  "motor travou: resist\352ncia no tubo perto da cabe\347a",
  "motor auxiliar com bobina aberta",
  "n\343o conseguiu recolher o filamento ao AMS",
  "sensor de sa\355da desconectado",
  "v\341lvula 1 desconectada",
  "motor travou: resist\352ncia no tubo perto do AMS",
  "falha ao ler o mapa do AMS; toque em Retomar",
  "sensor de temperatura do aquecedor desligado",
  "filamento acabou; coloque um novo",
  "fonte com tens\343o alta demais; troque a fonte",
  "erro no medidor de filamento",
  "aquecedor desconectado",
  "o filamento pode ter partido",
  "falha de comunica\347\343o com o AMS; veja o cabo",
  "bobina da v\341lvula 2 com defeito",
  "motor do alimentador sem sinal",
  "sensor de corrente do motor com defeito",
  "etiqueta RFID danificada ou ileg\355vel",
  "sem filamento; coloque um novo",
  "v\341lvula 2 do AMS travando",
  "motor auxiliar com defeito",
  "motor patinou: roda com defeito ou fio fino",
  "ventoinha do aquecedor sem a fonte ligada",
  "motor auxiliar com defeito na velocidade",
  "aquecedor em curto",
  "medidor de filamento sem sinal",
  "filamento puxando com for\347a; veja carretel e tubos",
  "n\343o deu para secar; tire o filamento e tente",
  "demorou para recolher o filamento ao AMS",
  "sensor da v\341lvula 2 do AMS com defeito",
  "ventoinha do aquecedor travada",
  "motor travou: tubo entre AMS e impressora",
  "fonte com tens\343o baixa; seca menos",
  "sensor de temperatura e umidade com defeito",
  "motor n\343o consegue girar o carretel",
  "motor sobrecarregado: filamento enroscado",
  "motor patinou; corte a ponta gasta e tente",
  "filamento pode ter partido na cabe\347a",
  "sensor de umidade desconectado",
  "fios do sensor do motor desconectados",
  "buffer de filamento sem sinal de posi\347\343o",
  "sensor de entrada desconectado",
  "sem filamento externo; coloque um novo",
  "filamento pode ter partido dentro do AMS",
  "bobina da v\341lvula 1 com defeito",
  "motor travou: tubo perto do buffer",
  "secagem descontrolada; desligue o AMS",
  "cortador indo longe demais; motor XY perdeu passo",
  "motor do AMS sem sinal",
  "filamento n\343o puxou; corte a ponta reta",
  "ventoinha do aquecedor lenta",
  "RFID n\343o l\352 por defeito na pe\347a",
  "demorou para limpar o filamento velho: entupido?",
  "n\343o leu o RFID do carretel",
  "motor auxiliar com defeito nas fases",
  "par\342metro do motor perdido; reinicie o AMS",
  "fios do motor auxiliar desconectados",
  "placa RFID 2 com defeito",
  "secando com a energia da impressora; ligue a fonte",
  "aquecedor esquentando errado",
  "filamento acabou; limpando o filamento velho",
  "filamento acabou; ponha outro no mesmo slot",
  "filamento acabou; trocou para um slot igual",
  "temperatura do AMS fora: tampa aberta?",
  "motor travou: tubo entre AMS e buffer",
  "aquecedor ou sensor de corrente com defeito",
  "calibra\347\343o do motor perdida; reinicie o AMS",
  "tubo PTFE quebrado ou solto ao carregar",
  "placa RFID 1 com defeito",
  "n\343o conseguiu levar o filamento at\351 a cabe\347a",
  "filamento acabou e a limpeza falhou; veja a cabe\347a",
  "filamento n\343o sai: extrusora entupida ou fio fino",
  "v\341lvula 2 desconectada",
  "n\343o girou o carretel ao recolher o filamento",
  "demorou para mandar o filamento para fora",
  "carretel externo enroscado ou travado",
  "AMS desligado; use o carretel externo",
  "buffer de filamento com sinal estranho",
  "tire o filamento externo da extrusora",
  "sensor do cortador com defeito; veja o conector",
  "filamento externo acabou; coloque um novo",
  "alavanca do cortador presa",
  "Bambu Studio incompat\355vel; atualize",
  "motores perderam passo v\341rias vezes",
  "n\343o leu o carretel: placa do AMS com defeito",
  "carretel com RFID de outra marca",
  "etiqueta RFID pode estar danificada",
  "RFID travado ao carregar; tire o filamento",
  "filtro no fim da vida; troque",
  "muita poeira fina no ar; veja o filtro",
  "fatiador n\343o autorizado detectado",
  "RFID n\343o validado; use filamento Bambu",
  "erro no Wi-Fi; desligue e ligue o Wi-Fi",
  "slot sobrecarregado: filamento enroscado",
  "Micro Lidar desconectado",
  "aquecedor 1 em curto",
  "c\342mara n\343o chegou na temperatura; seguindo",
  "motor 2 sem sinal",
  "laser largo demais; a mesa est\341 suja?",
  "firmware do AMS n\343o bate; atualize",
  "placa de impress\343o fora do lugar; ajuste",
  "sensor de for\347a sentiu toque fora da mesa",
  "eixo Y com problema: correia frouxa?",
  "temperatura da c\342mara estranha: sensor em curto?",
  "ventoinha do aquecedor 1 travada",
  "n\343o leu o RFID: etiqueta danificada ou torta",
  "sensor da mesa sentiu tranco: fio solto?",
  "cart\343o microSD n\343o formatado; formate",
  "slot vazio; coloque um filamento",
  "eixo X diferente da calibra\347\343o; limpe e calibre",
  "sinal fraco no sensor de for\347a 2 da mesa",
  "aquecedor 1 esquentando errado",
  "microSD cheio; sem v\355deo nem timelapse",
  "sensor do aquecedor 1 desligado",
  "sistema com defeito; restaure de f\341brica",
  "falha ao baixar a impress\343o; veja a rede",
  "impressora em modo engenharia; cuidado",
  "sem internet; a impress\343o continua",
  "Micro Lidar novo; calibre antes de usar",
  "tampa do AMS aberta; atrapalha a secagem",
  "motor B em curto; pode ter queimado",
  "ventoinha do bico lenta; veja se tem sujeira",
  "par\342metro do Micro Lidar com erro; suporte",
  "buffer de filamento com defeito; reinicie",
  "motor do slot com defeito no controle",
  "motor A com circuito aberto: fio solto?",
  "erro de comunica\347\343o interna; sistema com falha",
  "falha ao entrar na c\342mera ao vivo; veja a rede",
  "laser vertical apagado: coberto ou desconectado",
  "sinal fraco no sensor de for\347a 2: fio partido?",
  "a tampa da frente da cabe\347a caiu",
  "comando recusado; atualize o Bambu Studio",
  "AMS esfriando depois de secar; aguarde",
  "sensor da c\342mara com circuito aberto",
  "driver do motor da extrusora com defeito",
  "sinal fraco no sensor de for\347a 1: fio partido?",
  "c\342mera desconectada; veja o cabo",
  "motor auxiliar com defeito no controle",
  "ventoinha do aquecedor 2 lenta",
  "bico entupido de filamento",
  "placa de impress\343o pode estar fora do lugar",
  "falha no aquecimento da mesa",
  "c\342mara n\343o aqueceu: fonte quente demais",
  "sensor da mesa em curto",
  "aquecedor 2 desconectado",
  "c\342mara n\343o aqueceu: aquecedor sem ar quente",
  "motor 1 sem sinal",
  "sensor de for\347a 1 sens\355vel demais: preso?",
  "eixo X com frequ\352ncia baixa: correia frouxa?",
  "pe\347as puladas; sem inspe\347\343o da 1\252 camada",
  "sensor da mesa com circuito aberto",
  "aquecedor do bico em curto",
  "usu\341rio n\343o autorizado; veja sua conta",
  "buffer de filamento com erro de posi\347\343o",
  "a tela da impressora falhou; reinicie",
  "sensor de for\347a 3 sentiu toque fora da mesa",
  "aquecedor 1 ou sensor de corrente com defeito",
  "motor Z com circuito aberto: fio solto?",
  "ventoinha do aquecedor 1 lenta",
  "sinal fraco no sensor de for\347a 1 da mesa",
  "sensor do aquecedor 2 desligado",
  "ventoinha do aquecedor 2 travada",
  "aquecedor 2 ou sensor de corrente com defeito",
  "laser n\343o mede este material; 1\252 camada imprecisa",
  "sensor da mesa sente for\347a cont\355nua: preso?",
  "m\363dulo de inspe\347\343o reiniciou; resultado incerto",
  "mesa j\341 teve falha no aquecimento; veja o wiki",
  "sensor de for\347a 2 sentiu toque fora da mesa",
  "mesa passou do limite; temperatura ajustada",
  "sensor de for\347a 3 sens\355vel demais: preso?",
  "sinal fraco no sensor de for\347a 3: fio partido?",
  "sensor de for\347a 3 com defeito ou mesa travando",
  "falha ao informar o estado; veja a rede",
  "inspe\347\343o da 1\252 camada demorou; resultado incerto",
  "ventoinha da pe\347a lenta ou parada",
  "sensor do bico em curto; veja o conector",
  "marcador da placa n\343o achado; alinhe a placa",
  "mesa quente demais",
  "c\342mera do Micro Lidar com defeito",
  "falha ao acertar o rel\363gio",
  "laser do Micro Lidar desregulado; calibre",
  "sensor da porta do AMS-HT solto",
  "motor 4 sem sinal",
  "cabe\347a de impress\343o com defeito; reinicie",
  "c\342mara esfriando devagar; abra a porta se puder",
  "motor B com circuito aberto: fio solto?",
  "sinal fraco no sensor de for\347a 3 da mesa",
  "eixo X com problema: cabe\347a presa ou barra dura?",
  "inspe\347\343o da 1\252 camada parou: erro do Lidar",
  "veja se sai filamento do bico; empurre de leve",
  "falha de comunica\347\343o com o hub do AMS; veja o cabo",
  "driver do motor esquentando; veja a ventoinha",
  "o sistema travou; reinicie a impressora",
  "sensor do bico com circuito aberto",
  "falha de comunica\347\343o com o controle da c\342mara",
  "eixo Y diferente da calibra\347\343o; limpe e calibre",
  "mesa no m\341ximo h\341 muito tempo; controle estranho",
  "firmware do acess\363rio n\343o bate; atualize",
  "falha no login da impressora; veja sua conta",
  "bico baixo demais: gasto ou torto?",
  "c\342mara n\343o aqueceu: resist\352ncia t\351rmica alta",
  "filamento purgado acumulou na calha; limpe",
  "aquecedor 2 esquentando errado",
  "aquecedor 2 em curto",
  "controle do bico estranho: hotend instalado?",
  "placa de movimento com defeito; reinicie",
  "aquecedor da mesa em curto",
  "sem inspe\347\343o da 1\252 camada nesta impress\343o",
  "c\342mara n\343o aqueceu: aberta ou ambiente frio",
  "motor 3 sem sinal",
  "nivelamento da mesa estranho: sujeira na mesa?",
  "controle da c\342mara com defeito; reinicie",
  "servi\347o interno com defeito; reinicie",
  "motor B com resist\352ncia errada; pode ter queimado",
  "poss\355vel defeito na 1\252 camada; confira a pe\347a",
  "laser vertical fraco; limpe a mesa",
  "controle da mesa estranho: placa AC com defeito",
  "sensor de corrente do motor B com defeito",
  "inspecionando a 1\252 camada; aguarde",
  "sensor de corrente do motor A com defeito",
  "eixo X com problema: correia frouxa?",
  "laser horizontal apagado: coberto ou desligado",
  "motor da extrusora com resist\352ncia errada",
  "aceler\364metro com dados estranhos; reinicie",
  "laser horizontal fraco; limpe a mesa",
  "motor da extrusora com circuito aberto",
  "controle do cart\343o SD com defeito",
  "arquivo de impress\343o n\343o autorizado",
  "temperatura da c\342mara acima do limite; ajustada",
  "aquecedor 1 desconectado",
  "firmware com problema; atualize pela rede",
  "falha ao calibrar o Micro Lidar; limpe o alvo",
  "falha no v\355deo interno; reinicie",
  "eixo Z travando: sujeira nas guias ou correia?",
  "ventoinha do aquecedor 1 sem a fonte ligada",
  "ventoinha do aquecedor 2 sem a fonte ligada",
  "a impressora falhou; reinicie",
  "placa de calibra\347\343o ausente ou fora do lugar",
  "falha na autentica\347\343o do AMS; religue o cabo",
  "m\363dulos incompat\355veis com o firmware; atualize",
  "sensor da porta frontal solto",
  "login expirou; entre na conta de novo",
  "hora de limpar as barras de carbono",
  "hora de lubrificar os fusos",
  "falha no kit de timelapse; religue o cabo",
  "sensor de temperatura 1 do aquecedor com defeito",
  "sensor de temperatura 2 do aquecedor com defeito",
  "pronto; limpando o ar da c\342mara",
  "c\342mara muito quente; se sair fuma\347a, desligue j\341",
  "falha no aquecimento do bico; desligue j\341",
  "sem cart\343o microSD; sem timelapse",
  "microSD sem espa\347o para os arquivos",
  "sensor de for\347a 2 com defeito ou mesa travando",
  "bico alto demais: filamento grudado no bico?",
  "ventoinha do bico lenta ou parada",
  "mesa n\343o achou a posi\347\343o: vibra\347\343o demais",
  "microSD ficando lento; formate ou troque",
  "sensor de acelera\347\343o da mesa fraco: soltou?",
  "bico quente demais",
  "microSD s\363 leitura; sem v\355deo nem timelapse",
  "dados de f\341brica da placa AP com defeito",
  "eixo Y com frequ\352ncia baixa: correia frouxa?",
  "sensor de corrente do motor Z com defeito",
  "eixo Y com problema: cabe\347a presa ou carro duro?",
  "sensor de for\347a 2 sens\355vel demais: preso?",
  "energia inst\341vel; prote\347\343o contra queda ativada",
  "hardware incompat\355vel; veja o Micro Lidar",
  "c\342mara n\343o aqueceu: ventoinha lenta",
  "sensor de for\347a 1 com defeito ou mesa travando",
  "sensor do motor da extrusora com defeito",
  "mesa quente para este filamento; abra a porta",
  "Micro Lidar dessincronizado; reinicie",
  "mesa com problema: calombo ou bico sujo?",
  "aquecedor do bico com circuito aberto",
  "LED do Micro Lidar pode ter queimado",
  "poss\355vel espaguete! confira a impress\343o",
  "motor A com resist\352ncia errada; pode ter queimado",
  "motor A em curto; pode ter queimado",
  "a porta parece estar aberta",
  "motor Z com resist\352ncia errada; pode ter queimado",
  "erro no v\355deo ao vivo; veja a rede",
  "motor Z em curto; pode ter queimado",
  "o sistema travou e reiniciou sozinho",
  "AMS com defeito; reinicie a impressora",
  "bico coberto de filamento ou placa torta",
  "n\343o conseguiu retomar a impress\343o anterior",
  "aquecedor da mesa aberto ou chave t\351rmica aberta",
  "lente do Micro Lidar suja; limpe",
  "c\342mera sem imagem; sem detec\347\343o de espaguete",
  "ventoinha do bico lenta; limpe",
  "arquivo ileg\355vel; mande a impress\343o de novo",
  "motor da extrusora em curto; pode ter queimado",
};
static const HmsCodigo HMS_COD[] = {
  {0x03000100, 0x00010001, 227, 1, 2, 0, 0, 0},
  {0x03000100, 0x00010002, 307, 1, 2, 0, 0, 0},
  {0x03000100, 0x00010003, 198, 1, 2, 0, 0, 0},
  {0x03000100, 0x00010005, 3, 1, 2, 0, 0, 0},
  {0x03000100, 0x00010006, 164, 1, 2, 0, 0, 0},
  {0x03000100, 0x00010007, 171, 1, 2, 0, 0, 0},
  {0x03000100, 0x00010008, 162, 1, 2, 0, 0, 0},
  {0x03000100, 0x0001000A, 237, 1, 2, 0, 0, 0},
  {0x03000100, 0x0001000C, 217, 1, 1, 0, 0, 0},
  {0x03000100, 0x0001000D, 187, 1, 2, 0, 0, 0},
  {0x03000100, 0x00030008, 189, 1, 0, 0, 0, 0},
  {0x03000200, 0x00010001, 172, 3, 2, 0, 0, 0},
  {0x03000200, 0x00010002, 294, 3, 2, 0, 0, 0},
  {0x03000200, 0x00010003, 279, 3, 2, 0, 0, 0},
  {0x03000200, 0x00010005, 270, 3, 2, 0, 0, 0},
  {0x03000200, 0x00010006, 196, 3, 2, 0, 0, 0},
  {0x03000200, 0x00010007, 214, 3, 2, 0, 0, 0},
  {0x03000200, 0x00010009, 225, 3, 2, 0, 0, 0},
  {0x03000300, 0x00010001, 275, 12, 2, 0, 0, 0},
  {0x03000300, 0x00020002, 142, 12, 1, 0, 0, 0},
  {0x03000400, 0x00020001, 195, 12, 2, 0, 0, 0},
  {0x03000500, 0x00010001, 212, 7, 2, 0, 0, 0},
  {0x03000600, 0x00010001, 146, 7, 2, 0, 0, 0},
  {0x03000600, 0x00010002, 298, 7, 2, 0, 0, 0},
  {0x03000600, 0x00010003, 297, 7, 2, 0, 0, 0},
  {0x03000700, 0x00010001, 206, 7, 2, 0, 0, 0},
  {0x03000700, 0x00010002, 141, 7, 2, 0, 0, 0},
  {0x03000700, 0x00010003, 234, 7, 2, 0, 0, 0},
  {0x03000800, 0x00010001, 178, 7, 2, 0, 0, 0},
  {0x03000800, 0x00010002, 302, 7, 2, 0, 0, 0},
  {0x03000800, 0x00010003, 300, 7, 2, 0, 0, 0},
  {0x03000900, 0x00010001, 246, 3, 2, 0, 0, 0},
  {0x03000900, 0x00010002, 312, 3, 2, 0, 0, 0},
  {0x03000900, 0x00010003, 243, 3, 2, 0, 0, 0},
  {0x03000A00, 0x00010001, 168, 1, 1, 0, 0, 0},
  {0x03000A00, 0x00010002, 180, 1, 2, 0, 0, 0},
  {0x03000A00, 0x00010003, 156, 1, 2, 0, 0, 0},
  {0x03000A00, 0x00010004, 122, 1, 1, 0, 0, 0},
  {0x03000A00, 0x00010005, 289, 1, 2, 0, 0, 0},
  {0x03000B00, 0x00010001, 285, 1, 1, 0, 0, 0},
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
};
static const int HMS_N = sizeof HMS_COD / sizeof HMS_COD[0];

// Busca binaria pelo par (attr, code) que vem no campo hms da impressora.
inline const HmsCodigo* hmsBusca(uint32_t a, uint32_t c) {
  int lo = 0, hi = HMS_N - 1;
  while (lo <= hi) {
    int m = (lo + hi) / 2; const HmsCodigo& e = HMS_COD[m];
    if (e.a == a && e.c == c) return &e;
    if (e.a < a || (e.a == a && e.c < c)) lo = m + 1; else hi = m - 1;
  }
  return nullptr;
}
