argeuthiesen/claudinho/(commit log)

2026-09-27 Claudinho 1.1.0: o mascote do Claude Code num ESP32 com display
    Plugin do Claude Code (hooks + status line + skill de configuracao) e
    firmware para ESP32-C3/S3 com Nextion NX3224F024. Sem OAuth, sem nuvem e
    sem gastar tokens no dia a dia.
2026-09-27 Diagramas de ligacao, alimentacao e visao geral; secao Bom saber no README
2026-09-27 Aviso de risco no README
2026-09-28 Paleta de cor do rosto na tela (firmware 1.2.3) e manual de uso bilingue
2026-09-28 Manual: comparar os tons da borda direto com a moldura impressa
2026-09-29 Impressora Bambu Lab opcional: painel e alertas (firmware 1.5.3)
    O Claudinho conecta direto no MQTT local da impressora (TLS 8883, sem
    biblioteca, sem servidor, sem nuvem). Testado na P2S com AMS 2 Pro.
    - Painel (pagina 9): modelo e estado, arquivo, 3 colunas (%, tempo
    restante, camada), barra na cor do filamento, bico/mesa, 4 cores do AMS.
    Imprimindo, aparece a cada 5 min por 15 s; tocar fixa.
    - Alertas (pagina 8) que ficam ate o toque: comecou, pausou (com o
    motivo), retomou, faltam 5 min, trocou o filamento, terminou, falhou/
    cancelada, avisos HMS, AMS umido.
    - claudinho.sh bambu IP (codigo escondido ou pela entrada padrao),
    bambu desligar, painel.
    - Skill, manuais e READMEs (i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
    [claudinho.ino, config.h]
2026-09-29 Cenas enquanto o Claude trabalha e alertas da impressora em portugues (firmware 1.7.1)
    Cenas (pagina 10): editor de codigo (Edit/Write, com preambulo "code
    claudinho.ino"), terminal (Bash), chuva do Matrix (Read/Grep/Glob) e
    organograma (Agent), com um mini Claudinho animado no canto. Tudo de
    mentira, guardado na placa: o hook manda so a categoria da ferramenta.
    Cada cena fica pelo menos 8 s; 12 s sem ferramenta, volta ao rosto.
    Nova fonte 5 na tela (JetBrains Mono, OFL): .HMI e .tft atualizados.
    Alertas da impressora redesenhados: "IMPRESSORA 3D" e o modelo no alto,
    titulo grande na cor do alerta, "peca: ...", Claudinho pulando (boas) ou
    abanando os bracos (atencao). Avisos HMS em portugue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
2026-09-30 Botoes Tokens / Impressora / Manter e umidade do AMS (firmware 1.8.2); versao de placa unica a caminho
    - Cartao de consumo e painel da impressora ganham botoes embaixo (50 px,
    para o dedo): Tokens | Impressora | Manter. Moldura dourada fina na tela
    atual. Manter deixa a tela ligada (o botao vira Dormir, que volta ao
    rosto): o Claudinho vira monitor portatil da impressora. Alertas da
    impressora continuam aparecendo e voltam para a tela mantida.
    - Painel: sai o nome da impressao (pela rede local so vem "projeto + placa"
    ou o perfil do MakerWorld); entra a umidade e a temperatura do AMS.
    - Alertas sem o nome da impressao.
    - READMEs: secao "Em breve" sobre a E32R28T (ESP32 com tela de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
2026-09-30 Painel da impressora: temperatura da camara ao lado do bico e da mesa (firmware 1.8.3)
2026-10-05 Idiomas: textos da tela em ingles e portugues, prontos para traducao (firmware 1.9.1)
    - idiomas/: um arquivo por idioma (en.txt e a referencia, pt-BR.txt),
    "chave = texto", com os 121 textos da tela e os 313 avisos HMS.
    idiomas/gerar.py confere chaves, %... (mesma ordem), caracteres e a
    largura de cada texto medida com a fonte de verdade (DM Sans, OFL), a
    partir de idiomas/caixas.txt, e gera firmware/claudinho/textos.h.
    Guia para colaboradores: idiomas/TRANSLATING.md (en e pt-BR).
    - Avisos HMS: firmware/hms/hms.json + hms_codigos.h so com os codigos;
    os textos vem dos idiomas. Ingles da versao GC9A01 do Mathias (bserking).
    - claudinho.sh idioma [codigo]; padrao de fabrica: ingles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
2026-10-07 Modo demonstracao (firmware 1.10.0) e video no topo dos READMEs
    - claudinho.sh demo [parar]: um passeio de ~2 min por tudo, sozinho na
    placa, para filmar: dorme e acorda, as caras, o consumo, as cenas, a
    impressora e os alertas, a calibragem de cor, velha e Genius com toques
    "fantasma". Dados de mentira; eventos do PC e da impressora ignorados
    durante a demo; tudo volta como estava. Um toque na tela para.
    - Video da demo logo abaixo da frase de abertura, no mesmo lugar nos dois
    READMEs.
    - Manuais, READMEs e skill (ingles e portugues).
2026-10-07 Placa unica E32R28T (ESP32 + tela 2,8" embutida), firmware 1.11.0
    - tela_e32.h: tela ST7789 (a ficha diz ILI9341, mas na placa e ST7789) e
    toque XPT2046 calibrado, com LovyanGFX. O resto do firmware continua
    falando "Nextion" (fill, xstr, line, cir, cirs, dim): na E32R28T esses
    comandos viram desenho direto, e o toque gera os mesmos eventos. Tudo
    funciona nela: caras, consumo, cenas, impressora, jogos, demo, idiomas.
    - fontes_e32.h: DM Sans e JetBrains Mono em VLW com borda suave (ISO-8859-1),
    gerado por firmware/fontes/gerar_vlw.py, nos mesmos numeros de fonte.
    - compilar.sh gera tambem claudinho-e32r28t-*.bin; gravar.sh reconhece o
    ESP32 classico como E32R28T; a skill conduz as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
2026-10-08 ctx no cartao (todas as placas); na placa unica: fala de robo, bateria e desligar (firmware 1.13.0)
    Todas as placas:
    - Cartao de consumo mostra o ctx (contexto da conversa) no alto: cinza,
    amarelo a partir de 75 %, vermelho a partir de 90 %. Texto nos idiomas.
    So na E32R28T (todo o som fica em #ifdef PLACA_E32R28T):
    - Idioma de robo gerado na hora: 14 humores, cada fala sorteada (voz,
    ritmo, silabas, notas), nada gravado, nunca igual. Fala ao acordar,
    quando o Claude espera voce, no erro, quando termina e ao dormir; chama
    a cada 15 s na tela de permissao de atualizacao; cada cara fala na demo.
    - Som pelo DAC do IO26 escrito direto no registrador (dacWrite era lento
    demais: o som s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
2026-10-08 READMEs: pecas da versao de placa unica (E32R28T, alto-falante, bateria)
2026-10-08 README: single board (E32R28T) as the main version; classic Nextion stays supported
    Assembly warning: flash first over USB, then power with 5 V through the
    UART connector (pin 1 +5 V, pin 2 GND per the schematic), never together
    with USB. Skill description covers both versions.
2026-10-08 README: single-board case is being modeled, coming to MakerWorld
2026-10-08 README: reorganized around the single board (E32R28T)
    Which-version table up front, then the single board (parts, power on the
    desk vs inside the case, new power diagram, warning), prerequisites and
    installation with the essentials as steps, everyday use with real paths,
    updates (firmware vs plugin), classic assembly, internals, story at the end.
    Reviewed twice by GPT. Same content in English and Portuguese.
2026-10-08 README: board's USB-C is for the first flash only; everyday power through the case's USB-C
2026-10-12 README: E32R28T case is on MakerWorld; new case photos
    Both cases are now print profiles of the same MakerWorld model. Swap the
    bare-board photos for the printed case (front, back, side) and add an
    assembly row (parts, battery, inside, printing), in EN and PT.
2026-10-12 1.14.0: charging bolt on the battery icon; hello/goodbye sounds
    E32R28T only:
    - Charging detection from the battery voltage (the TP4054 status pin is not
    wired to the ESP32): a ~100 mV step when 5 V is plugged in or removed,
    plus a 10-minute trend for boots that start on the charger. A lightning
    bolt shows inside the battery icon; the percent discounts the step.
    /mini reports bat_carga.
    - Sound when a Claude Code session opens (hello, the wake-up sound) and when
    the last one closes (goodbye, the sleep sound), without repeating it when
    the face falls asleep right after.
    Manual and README (EN/PT) updated; README notes the SketchUp source of both
    cases is in the MakerWorld model.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
2026-10-12 1.15.0: captions under the face; celebrates commits and reacts to tests
    - Caption: a short phrase at the bottom of the face for a few seconds after
    each event (Thinking..., Committed!, I need you!...), then it clears.
    New texts in idiomas/ (en, pt-BR), width-checked by gerar.py.
    - New PostToolUse hook (Bash/PowerShell): evento.sh checks on the computer
    whether the command was a git commit or a test run (pytest, npm test,
    cargo test, go test...) and sends only the word: commit, teste_ok or
    teste_falhou. With a pipe (| tail) the output is checked too. A failed
    test run turns the error into teste_falhou. The command never leaves the PC.
    - Board: commit = excited (+ sound on E32), te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
2026-10-12 1.16.0: virtual Claudinho (browser, no board) and an online demo
    - virtual/servidor.py: a small local server (127.0.0.1 only) that takes the
    board's place: same /evento and /estado, same secret, forwarded to the page
    over Server-Sent Events. Reading the events needs a per-run read key; tabs,
    queues and body sizes are capped.
    - virtual/claudinho.html: the face ported from the firmware onto a canvas,
    used as the live screen of the 3D-printed case (three.js + the case's STL,
    assembled as printed: frame pinned into the body, body tilted 30 degrees in
    the base). Captions, sleep dimming, the work scenes (editor, terminal,
    Matrix, agents), plan usage beside it, 2D fallback. Outside 12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
2026-10-12 1.16.1: printer panel and alerts in the demo; virtual has no Bambu yet
    The online demo now shows the Bambu printer panel and alerts (started,
    5 min left, filament changed, paused, finished) with made-up data, like the
    board's demo. README, manual and skill (EN/PT) say the virtual Claudinho
    doesn't talk to a real printer yet, and has no games.
2026-10-12 1.17.0: web panel on the board, with harmless settings; SHA-256 check
    - The board serves its own web panel at /painel: current face, sessions,
    Wi-Fi, uptime, memory, battery, printer, plan usage and the last 20
    events. Data and settings need a separate read key (claudinho.sh web
    creates it, stores it on the board and opens the page); settings are
    whitelisted to harmless ones (sound, volume, face color, language, show a
    screen, games, demo, restart, turn off). Firmware, Wi-Fi, secret and
    printer stay behind the main secret.
    - firmware/bin/SHA256SUMS: compilar.sh writes it; claudinho.sh atualizar and
    gravar.sh refuse a binary that doesn't match.
    Both ideas come from bserking's r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
2026-10-12 1.17.1: a browser opening the board's address goes to the web panel
    Scripts and tools still get the JSON identification at /.
2026-10-12 1.17.2: agents scene takes priority; claudinho command on the PATH
    - The agents (organogram) scene now opens at once over any other scene and
    stays at least 6 s; before, constant terminal use kept it from showing
    (a scene only switched after 8 s). Board and virtual page.
    - bin/claudinho: Claude Code puts the plugin's bin/ on its shell PATH, so
    "claudinho info" works there. claudinho.sh atalho [remover] creates
    ~/.local/bin/claudinho for the user's own terminal (finds the newest plugin
    version); the skill offers it at the end of setup.
2026-10-13 1.17.3: eventos.log, one line per hook event with the board's answer
    For diagnosing "it didn't react": time, event type and HTTP status
    (200 = received, 000 = didn't reach the board), last 200 lines, in the
    plugin data folder. Never the prompt. Troubleshooting row in EN/PT.
2026-10-13 1.18.0: usage card in three rings on the single board
    5 hours, 7 days and the session context as rings side by side, number in
    the middle, label and time to reset below. The context ring turns yellow at
    70% and red at 85%, since Claude Code compacts before it's full; the small
    ctx in the header goes away on this board. The classic Nextion version keeps
    the bars. Manual (EN/PT) updated.
2026-10-14 1.18.1: usage rings on the virtual Claudinho; animated GIF at the top of the README
    The virtual Claudinho now has the board's usage screen: three rings (5 hours,
    7 days, context). It opens with a click on the screen or the "Show usage"
    button, on its own when usage crosses a band (kept for later if a scene is on),
    and as a step of the online demo. Click detection ignores drags and pinches.
    The README opens with a GIF of the 3D Claudinho reacting, linked to the live
    demo.
2026-10-15 1.18.2: varied editor and terminal scenes; mini Clawd in tic-tac-toe
    The editor opens a different file each scene (Python, TypeScript, Go, SQL,
    C++) and the terminal strings together realistic sessions in random order:
    git, tests that fail and then pass, builds, docker, cargo, PlatformIO. The
    scripts live in scripts/gera-cenas.py, which generates firmware/claudinho/cenas.h
    and the matching block in the virtual Claudinho, so both always show the same.
    Claudinho's tic-tac-toe piece is now a white mini Clawd instead of an O. The
    demo no longer draws the "ghost tap" ring in tic-tac-toe (it circled the X)
    and has shorter pauses. The virtual draws mono text letter by letter, so the
    font's ligatur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
2026-10-15 README: single-board video at the top, Nextion video in the classic section
2026-10-15 README: MakerWorld case link at the top, next to the live demo
2026-10-22 1.19.0: chat scene when Claude asks Codex (or Gemini) for a second opinion
    When Claude Code calls another AI (OpenAI's Codex plugin, codex exec,
    gemini -p, or a codex:* subagent), the hook sends a new "conversa"
    category and Claudinho shows Clawd and a pixel-art cloud with ">_" eyes
    and little arms trading speech bubbles full of zeros and ones. The cloud
    sometimes changes its look, the scene enters right away and stays up to
    5 minutes (the other AI often runs a single long command), and any
    non-tool event ends it. Detection reads the command like the shell does,
    so quoted text or a log file named codex-companion doesn't trigger it.
    Also in the demo, the virtual Claudinho, `claudinho.sh cena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
2026-10-25 1.20.0: a ticker under the scenes saying what Claude is doing
    While Claudinho shows a scene (editor, terminal, reading, agents, chat),
    a band in the face color at the bottom shows, in cut-out letters, the
    short description Claude Code already writes for each command or agent
    ("Compiling the firmware", "Reviewing the code in parallel"), or the
    task in progress from its to-do list. It types itself in and scrolls
    back and forth when it doesn't fit. Zero tokens: it reuses text Claude
    already wrote for the person to approve. The command and file names
    still never leave the PC; the text is cleaned and cut to 60 letters,
    and `claudinho.sh letreiro desliga` turns it off.
    The single board uses a new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
2026-11-08 1.21.0: printer progress alerts close by themselves; stale ones drop out
    The Bambu alerts that only say how the print is going (started, resumed,
    5 minutes left, filament changed) now close by themselves after 20
    seconds; the others (paused and why, finished, failed/cancelled, HMS
    warnings, damp AMS) still wait for a tap.
    A newer alert from the same print also drops the ones it made old:
    "finished" replaces a "started" nobody saw, and a pause goes away once
    the print resumes or ends. The virtual Claudinho shows "closes by
    itself" instead of "tap: got it" on those. Also in the demo, the
    `alerta` test command, the manuals, the skill and the README.
2026-11-12 1.21.1: back to printing means the problem was solved
    When the printer goes back to printing, Claudinho takes it that the
    person already fixed the problem: the pause, the printer's HMS warnings
    and the end of the previous print leave the alert queue without waiting
    for a tap.
    HMS warnings that arrive while the printer keeps printing close by
    themselves (they didn't stop anything), and a warning the printer
    clears from its list leaves the queue too. Codes Bambu publishes with
    no description at the "notice" level (no effect on the print), like
    0500-0200-0003-000A on the P2S, now only go to the log instead of
    asking to look them up in the wiki. Manuals and skill updated.
